dtbinh/FlyNet/Technical/Vicon_Px4_Orientation_notes.txt

Vicon New Terminator Notes:
----------------------------
Facing Flight Direction Towards True North:
-------------------------------------------
Movement	Vicon	PX4 Local
--------	-----	---------
Pith up		-x		-y
Pitch down	+x		+y
Roll Left	+z		+x
Roll Right	-z		-x
Yaw Right	+y		-z
Yaw Left	-y		+z
