dtbinh/FlyNet/Presentations/integration_overview.pptx

## FlyNet Integration Architecture

Austin Anderson

## Overview

Target Detection

Tag
Detection

Navigation
Subsystem

Planning
Subsystem

Map Information

Flight Control
Subsystem

Target/Tag Information

Multi-Platform Coordination

= USB, MAVLink

= ROS Internal

= External Radio

= TBD

## Overview

Target Detection

Tag
Detection

Flight Control
Subsystem

Pixhawk

Navigation
Subsystem

Embedded Proc.

Planning
Subsystem

Map Information

Target/Tag Information

External Platforms

Multi-Platform Coordination

= USB, MAVLink

= ROS Internal

= External Radio

= TBD

## Nav Subsystem

Attitude
- Input
- Euler or Quaternion
- 3, double (64-pt.)
- MAVLink
- Up-to 1 kHz (?)

Local NED
- Output
- 3, double (64-pt.)
- ROS Internal
- ~10 Hz (based on sensor)

Map for OA
- Output
- ???
- ROS Internal
- ~10 Hz

Target Position in Local NED
- Input
- 3, double (64-pt.)
- ROS Internal
- ~10 Hz (based on sensor)

Nav Subsystem
- Runs SLAM on embedded controller
- Needs to output local NED and updated map.

Navigation
Subsystem

## Flight Control Subsystem

Flight Control Subsystem
- Runs flight control on Pixhawk
- Executes local position controller
- Given local NED pos
- Given local NED commands
- Outputs attitude for Nav. System

Attitude
- Output
- Euler or Quaternion
- 3, double (64-pt.)
- MAVLink
- Up-to 1 kHz (?)

Command, Local NED
- Input
- 3, double (64-pt.)
- USB MAVLink
- ~10 Hz (based on sensor)

Pos Local NED
- Input
- 3, double (64-pt.)
- USB MAVLink
- ~10 Hz (based on sensor)

Flight Control
Subsystem

## Detection Subsystem

Detection Subsystem
- Runs on embedded processor to detect targets and tags
- Extract az/el to target
- Extract binary detection from tag
- Tag is still TBD

Target Detection

Tag
Detection

Target Detection
- Binary -> target visible?
- Bearing 2, double (64-pt.)
  - Az/El
- SPI video
- 10 Hz (???)

Tag Detection
- Binary -> target visible?
- Double -> Tag ID
- USB or UART most likely…
- Or just camera…
- 10 Hz (???)

## Detection Subsystem

Detection Subsystem
- Runs on embedded processor to detect targets and tags
- Extract az/el to target
- Extract binary detection from tag
- Tag is still TBD
- Candidate for merging/ separate processor

Target Detection

Tag
Detection

Target Detection
- Binary -> target visible?
- Bearing 2, double (64-pt.)
  - Az/El
- SPI video
- 10 Hz (???)

Tag Detection
- Binary -> target visible?
- Double -> Tag ID
- USB or UART most likely…
- Or just camera…
- 10 Hz (???)

## Off-board Interface

Target/Tag Information

Map Information

Multi-Platform Coordination

Off-board Interface
- WiFi link for now
- Has to run some thread on embedded processor
- Very much TBD for now….
- Likely 10 Hz interface
- Map is a lot of data to move
- Need to reduce map
- Figure out how distributed planning will work
- Consider adding more processors…
