dtbinh/FlyNet/Technical/controls/Architecture/controls_working.pptx

W

R

C(s)

F, M

G(s)

A, α

Y

V

## Slide 2

Thrust, T
Drag, F_D
Gravity, F_g

Roll Torque
Pitch Torque
Yaw Torque

F

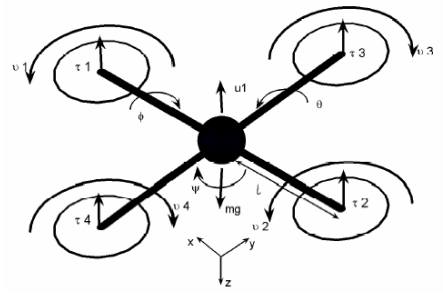
[picture p4: figure]

A_i =[xyz]_(inertial)

α_b =[φθψ]_(body)

M

Forces

τ_θ =k_t L (ω_1^2 −ω_2^2 )

τ_ψ =k_ψ L (ω_1^2 −ω_2^2 +ω_3^2 −ω_4^2 )

Moments

τ_φ =k_t L (ω_3^2 −ω_4^2 )

T=∑ T_i =k_t ω^2

F_D =−k_d x

F_g =mz

Assuming body and propeller gyroscopic moments are small

## Slide 3

C(s)

Roll ref

Pitch ref

Yaw ref

Throttle ref

Control System

Voltage1

Rotor Dynamics

ω_1

ω_2

ω_3

ω_4

f(ω)

F

M

Voltage2

Voltage3

Voltage4

## Slide 4

Rotor Dynamics

R_a

L_a

+

e=k_e θ

τ=k_t I_a

Θ/V=K/(s(τs+1))

Ω/V=K/(τs+1)

J_m θ+bθ=k_t I_a

L_a (di_a)/(dt)+R_a i_a =V_a −k_e θ

ℒ(s)

J_m Θs^2 +b Θs=k_t I_a

L_a I_a s+R_a I_a =V_a −k_e Θs

## Slide 5

Attitude
Control

V

K_I

1/s

φ_(des)

K_p

φ_(des)

K_p

K/(τs+1)

ω_m

t_φ (ω^2 )

τ_m

1/(Js)

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
θ_(des)

K_p

θ_(des)

K_p

K/(τs+1)

ω_m

τ_θ (ω^2 )

τ_m

1/(Js)

θ

1/s

θ

s

K_D

## Slide 6

Altitude
Control

1/s

K_I

z_(des)

K/(τs+1)

ω_m

T(ω^2 )

T

K_p

V

z_(estimate)

s

K_D

## Slide 7

Velocity
Control

1/s

K_I

x_b

V

K/(τs+1)

τ_θ (ω^2 )

τ_m

1/(Js)

1/s

x_b _(estimate)

K_p

ω_m

θ

θ

s

x_(estimate)

1/s

K_I

y_b

V

K/(τs+1)

τ_φ (ω^2 )

τ_m

1/(Js)

1/s

y_b _(estimate)

K_p

ω_m

φ

φ

s

y_(estimate)

## Slide 8

Position
Control

x,y_(des)

x_i ,y_i

x_b ,y_b

θ_(des)

K_p

R_(i2b)

Velocity Controller

φ_(des)

Attitude Controller

θ

x,y_(estimate)

Attitude Controller

φ
