dtbinh/FlyNet/Technical/controls/Architecture/control_diagram.pptx

Pixhawk/flight controller
Guidance
Custom

Desired velocity

ax-body, ay-body , az-body
p, q, r

ϕd θd ψd

Map Metrics

Map

pd qd rd

ϕd θd ψd

Desired trajectory

Vis. Odom.

ϕd θd ψd

Vis. Odom.

Vis. Odom.

Depth images,
Ultrasonic readings

Vis. Odom.

F, M

Zintertial-des

Desired Position

Depth images,
Ultrasonic readings
