dtbinh/FlyNet/Technical/documentation/Fall2015FinalReports/Technical Documentation/FlightControls.docx

Flight Control System:

Overview:

The purpose of the flight control system is to provide reliable indoor flight for a quad-rotor vehicle when a characterized/reliable position estimate is available, and when a set of desired locations/poses are commanded.

This system will accept a desired position in map space, given a North-West-Up coordinate system (used as per autopilot specifications), as well as a yaw command. These commands will be sent from the planning subsystem. Additionally, the SLAM algorithm described in the perception subsystem will provide position and orientation estimates to be used in the estimators used for control.

These commands and estimates are sent to an onboard Pixhawk autopilot. The autopilot uses these estimates and commands to run it’s internal control algorithms, which interface directly with the motors and ESCs. The Pixhawk uses a successive loop closure approach with position control as the outer most loop and the inner loops consisting of velocity, attitude, and attitude rate controllers.

Modeling:

Summary of Work

A simulation was developed to model the behavior of a quadcopter given certain physical properties and position commands. The simulation consists of a position controller, an attitude controller, and quadcopter dynamic model. The FlyNet simulation was built on the framework developed by D. Hartman, et al. (2014) and modified to fit the needs of this particular project and quadcopter. An overview of the model is shown in Figure 1.

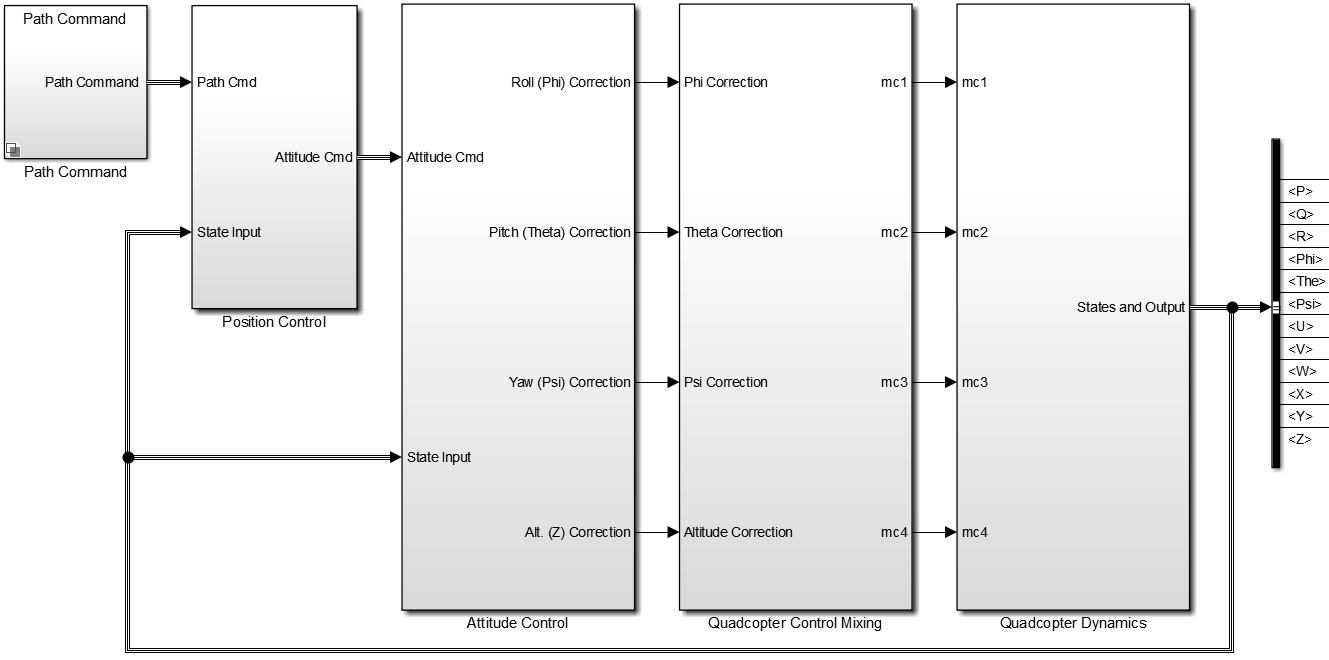
[picture p47: figure]

Figure 1. FlyNet quadcopter Simulink model

The simulation requires three sets of inputs:

- Initial conditions for all of the states (P, Q, R, ϕ , θ , ψ , U, V, W, X, Y, Z) and motor angluar rates, ω_(motor)
- Physical parameters of quadcopter (for a full list see Table 2)
- Path commands (X, Y, Z, and ψ )

These inputs are used by the model to simulate the quadcopter dynamics given a list of waypoints.

Position Controller

The position controller uses PD to control the desired velocity in the body horizontal plane ( X_b and Y_b ). The desired velocity is derived from the error between desired and current inertial positions. Figure 2 shows Simulink diagram of the position controller.

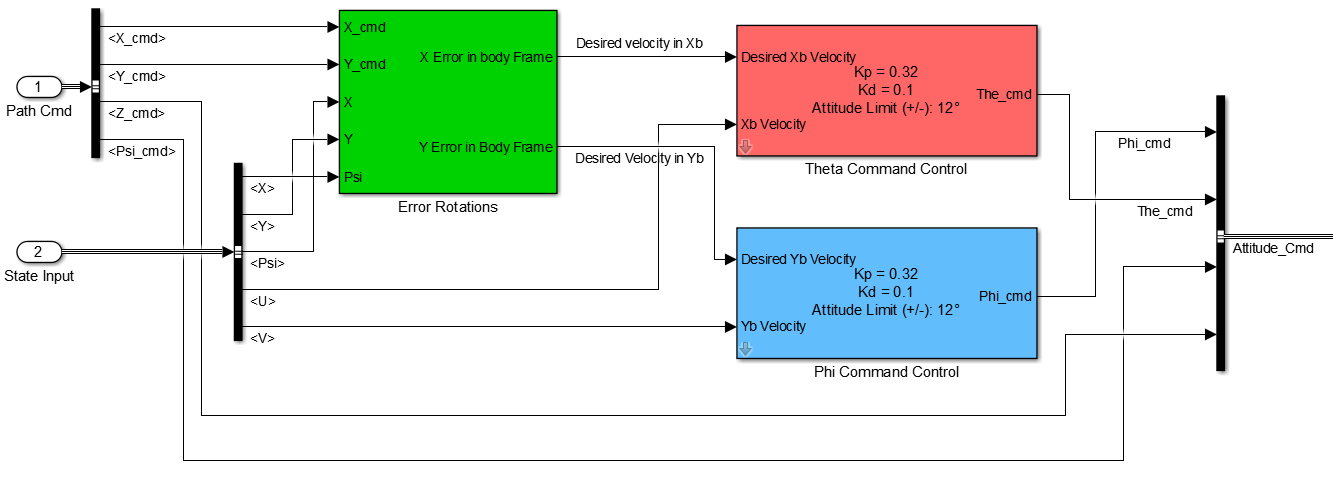
[picture p48: figure]

Figure 2. FlyNet quadcopter simulation position controller

The position controller outputs a signal bus containing roll and pitch attitude commands in addition to the altitude and yaw commands provided by the path command. This signal bus is then passed to the attitude controller.

Attitude Controller

The attitude controller applies PID control to the roll, pitch, and yaw in addition to the body Z coordinate in order to maintain the attitude required to execute the path command provided to the model. The attitude controller Simulink model is shown in Figure 3.

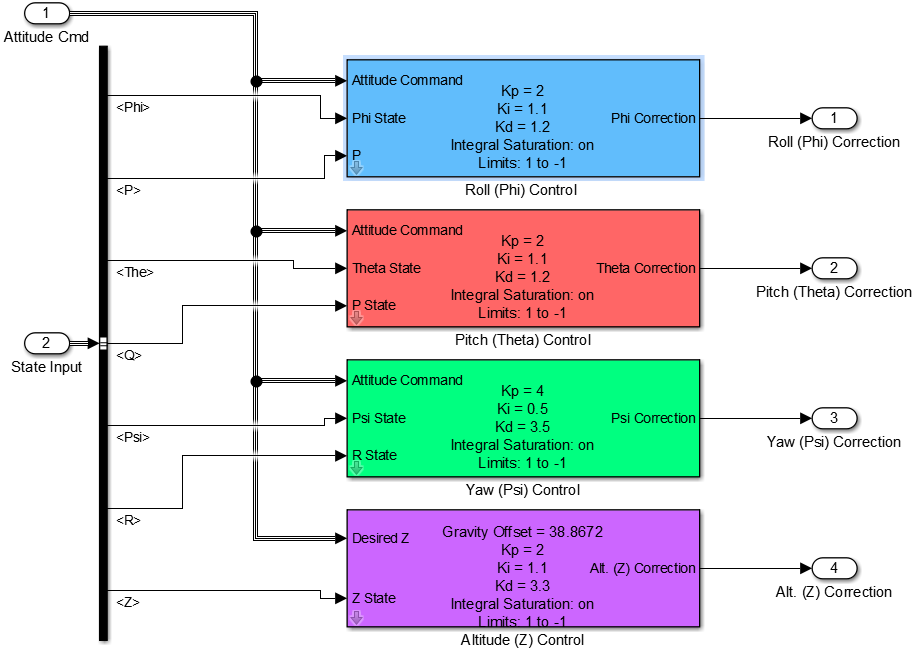
[picture p49: figure]

Figure 3. FlyNet quadcopter simulation attitude controller

The attitude controller uses body angular positions and rates (P, Q, R) in addition to the roll, pitch, and yaw commands provided by the position controller to compute the attitude corrections necessary to maintain a given path. The attitude corrections are sent to the motor mixer in order to translate them in to motor RPM commands. The motor mixer is shown in Figure 4.

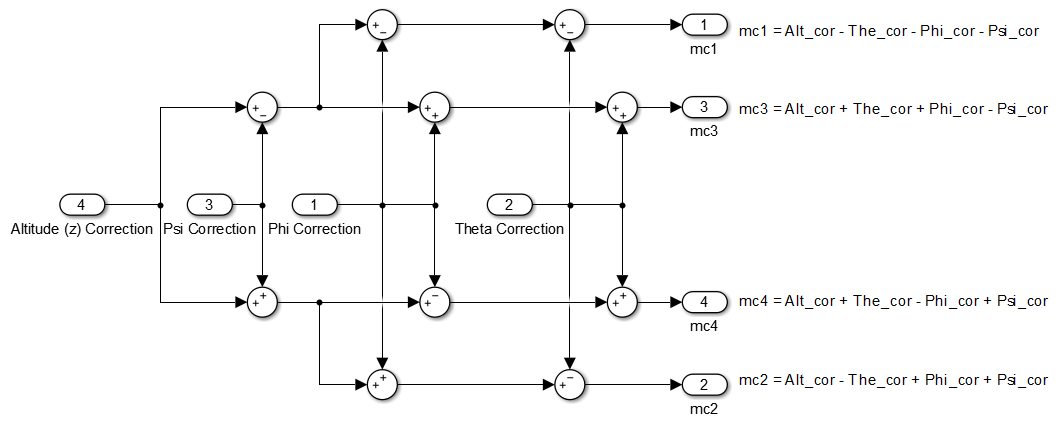
[picture p50: figure]

Figure 4. FlyNet quadcopter simulation motor mixer

The variable ‘mc#’ refers to the individual motor RPM commands that are required to achieve the attitude corrections. At this time, motor dynamics are considered and modeled in this simulation according to the transfer function shown in Equation (1):

| Ω/V=(k_t)/(τ_m s+1) | (1)

Here, Ω is the motor angular velocity, V is the PWM signal provided to the motor, k_t is the motor torque constant, and τ_m is the motor time constant. Once the motor commands are known, the dynamic model can simulate the response of the quadcopter to external force and moments.

Quadcopter Dynamics

Quadcopter dynamics are well understood and documented in various papers. Detailed information on the physics behind the quadcopter dynamic model used in this simulation can be found in the work of D. Hartman, et al. (2014). It is important, however, to note that the current dynamics model ignores blade flapping and frame aerodynamic drag. Because the quadcopter velocities are assumed to be small, these effects are negligible.

Simulation Results

The simulation was first tested using step input commands for X, Y, and Z to simulate the behavior of quadcopter in response to 1 meter commands in each direction. Figure 5 shows the response of the quadcopter in the X and Y directions (the test yielded the same result for both directions).

Figure 5. X and Y response of model to step command

In the X-Y direction, the quadcopter shows a stable response with an overshoot of 14% with a 5% settling time of 3.7 seconds. The altitude (Z direction) step response exhibits slower performance but is still stable. Figure 6 shows the model response to an altitude step command.

Figure 6. Z response of model to step command

In the Z direction, the quadcopter shows a stable response with an overshoot of 50% with a 5% settling time of 22.4 seconds. The altitude control is less critical than the horizontal control for the purposes of the FlyNet mission because minimal altitude control is expected. Horizontal control, however, is pivotal to maneuvering obstacle-filled spaces.

Yaw angle is another command that was tested because it will be necessary to perform yaw maneuvers in order to scan the search area during the mission. Figure 7 shows the model response to a yaw step command.

Figure 7. Yaw response of model to step command

The yaw angle control is stable, showing an overshoot of 25% with a 5% settling time of 6.6 seconds. These results show the controller is stable and performs well in horizontal motion but should be improved in the other direction. Improvement can be achieved by further tuning PID gains or adding feedforward control.

In order to assess the quadcopter model’s ability to follow a path, a series of position commands were provided to the model. The path shown in Table 1 was provided to the model.

Table 1. Simulink model commanded path

| 0 min | 6 min | 7 min | 7.5 min | 8 min | 8.5 min | 9 min | 9.5 min | 10 min
X [in] | 126 | 165 | 84 | 50 | 46 | 48 | 130 | 280 | 270
Y [in] | 30 | 179 | 329 | 362 | 497 | 584 | 548 | 467 | 480
Z [in] | 36 | 36 | 36 | 36 | 36 | 36 | 36 | 36 | 36

The XYZ commands were given at the time intervals shown. The first command was given 6 minutes to execute as it was the initial change in altitude from ground level to 36 inches (3 feet). After the first command, constant altitude was maintained. Figure 8 and Figure 9 shows the simulated results of the quadcopter path following.

Figure 8. Top-down view of simulated quadcopter path-following

Figure 9. Isometric view of simulated quadcopter path-following

The results show that after an initial overshoot in altitude, the vehicle tends to adhere to the commanded path. There are slight deviations when heading is changed but that is expected based on the simulated controller step responses. The simulation shows a Root-Mean-Square (RMS) error of 8.50 and the requirement is RMS must be less than 20 for path following.

Table 2. Quadcopter simulation physical parameters.

Variable | Parameter | Units
g | Acceleration due to gravity | m/(s^2)
d | Distance between motor and the axis of rotation | m
mass | Total mass | kg
ct | Lumped parameter thrust coefficient | (Ns^2)/(rad^2)
cq | Lumped parameter torque coefficient | (Nms^2)/(rad^2)
Jx | Moment of inertia about X | kg∙m^2
Jy | Moment of inertia about Y | kg∙m^2
Jz | Moment of inertia about Z | kg∙m^2
Jm | Moment of inertia of motors | kg∙m^2
Jb | Inertia tensor | kg∙m^2
Jbinv | Inverted inertia tensor | kg∙m^2
dctcq | Matrix of ct and cq for moment calculation | (Ns^2)/(rad^2), (Nms^2)/(rad^2)
motor_m | Mass of one motor | kg
motor_dm | Distance from motor to quadcopter center of mass | m
motor_h | Height of motor | m
motor_r | Radius of motor | m
ESC_m | Mass of one ESC | kg
ESC_a | Width of ESC | m
ESC_b | Length of ESC | m
ESC_ds | Distance from ESC to center of mass | m
HUB_m | Mass of hub | kg
HUB_r | Radius of hub | m
HUB_H | Height of hub | m
arms_m | Mass of one arm | kg
arms_r | Radius of arm | m
arms_L | Length of arm | m
arms_da | Distance from center of mass to arm | m
minThr | Minimum throttle | %
T | Time constant | s
cr | Throttle % to RPM conversion coefficient | (RPM)/(%Throttle)
b | Y-intercept for linear regression model of cr | RPM

Hardware:

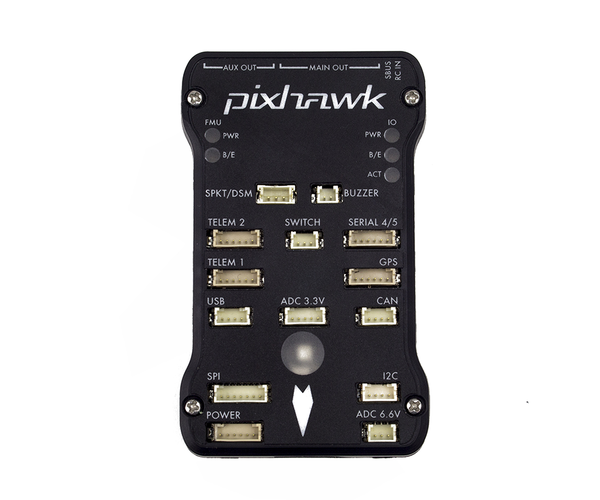
[picture p51: figure]

A 3DR Pixhawk autopilot is being used as the low-level flight controller and state estimator.

The Pixhawk internally uses accelerometers built into the unit to estimate its orientation. It also has a built in barometer for altitude state estimation; however, this is not being used since the barometer estimates are unreliable even over a short time frame. The magnetometer onboard the Pixhawk can also provide yaw estimates.

The PX4 firmware is being used in our system. This firmware is convenient for this application because it has built in support for external pose estimates. This allows the use of VICON for pose estimates during the controller performance evaluations, initial flight-testing for waypoint following, and for testing of the planning subsystem. Additionally, this topic will be used in the final flight configuration, in which a SLAM solution provides the pose estimates.

Figure 10: Pixhawk Autopilot

The firmware currently being used on the Pixhawk is PX4 commit hash: 2a1b1fe11db3406ff9e6027f858c7a994adee15d

Interfaces:

The communication between the planning subsystem, perception subsystem, and the flight control subsystem is handled using the Robot Operating System (ROS). This library was used as it abstracts low level interfaces, manages software dependencies, allows for the integration of heterogeneous code, and has existing code relevant to all of the subsystems. The MAVROS library allows direct communication with the PX4 firmware running on the Pixhawk using the MAVLink protocol. For near term testing, a motion capture system was used to feed position and orientation data into the autopilot. This will be replaced by the SLAM solution in the future, but development of the motion capture system also provides ground truth data with which the team can verify the performance of its algorithms. Currently a trajectory generation node is used to feed set point commands to the autopilot. This node will be replaced by the planning subsystem as that matures. The current architecture and interconnectivity of the ROS flight control software is shown in the following graph:

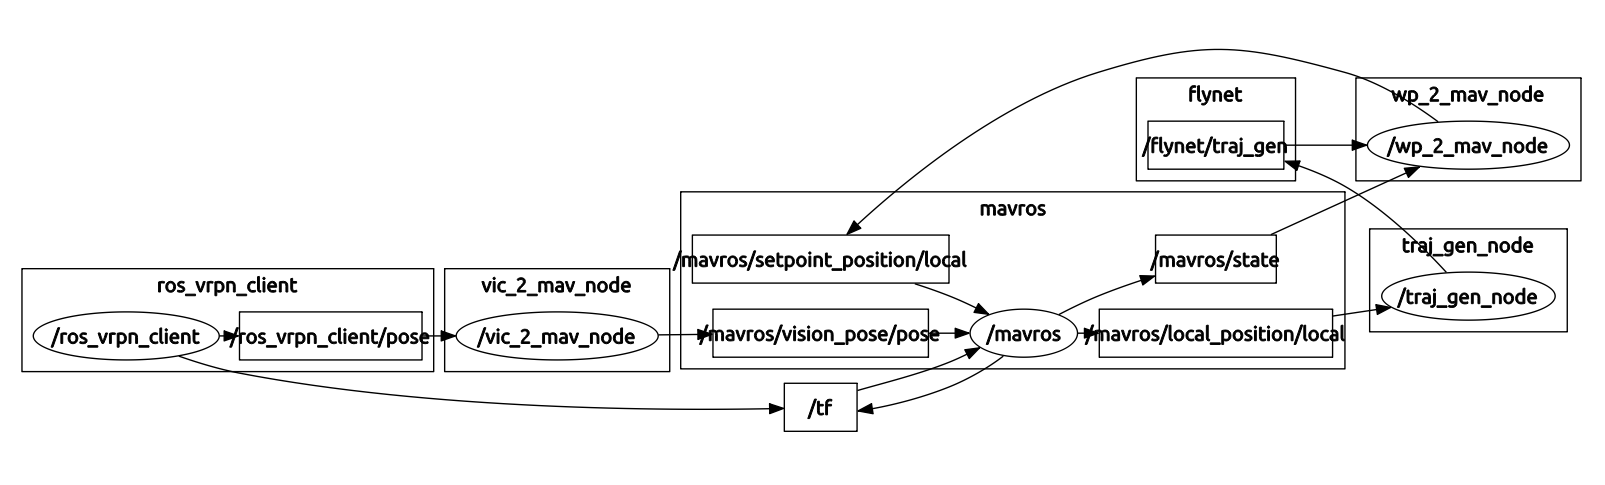
[picture p52: figure]

ROS NODES:

Figure 11: Flight Controls ROS Architecture

The flight control software written in ROS was architected to maximize modularity to support different flight modes as different subsystems evolve. The core nodes are the MAVROS node and wp_2_mav node. These handle the lowest level operations of the vehicle. The surrounding nodes can be switched out and still maintain basic functionality. For example, while the ROS_VRPN_CLIENT node is used now to provide position estimates to the vehicle, it will eventually be replaced with the SLAM algorithm. Similarly, the traj_gen node will eventually be replaced by the planning subsystem. Translator nodes will still likely be required to manage coordinate frame differences, but the existing translators should be adaptable to meet future requirements.

MAVROS Node:

This is the central node of the flight control software. It interfaces directly with the autopilot. It feeds in position and heading set points as well as vehicle position and orientation estimates from an external source. It publishes the local position and orientation estimate of the vehicle state calculated by the autopilot. It also publishes current autopilot state information that is used for management of flight modes. In addition to the topics MAVROS publishes and can subscribe to, it also provides a number of useful services. Currently MAVROS services are used to accomplish the following tasks:

1. Arm the quadcopter for autonomous flight
2. Force the autopilot into OFFBOARD flight mode to support autonomous commands
3. Set the GUIDED flag to true to enable autonomous operation
4. Set the home location to 0,0,0 in the local frame.
5. Set the takeoff flag

The MAVROS node is also used to set internal parameters of the autopilot. The following table captures important parameters for autonomous flight and their settings:

Name | Description | Value
ATT_MAG_DECL | Magnetic declination at Boulder, CO in deg. | 8.60
CBRK_NO_VISION | Flag indicating if vision data is available | 0 (use vision)
MIS_YAWMODE | Mode enumeration for yaw control | 0 (use set point)
ATT_EXT_HDG_M | External heading measurement mode | 1 (use vision)
INAV_W_Z_BARO | Weight used to incorporate barometer in alt. est. | 0.2 (lowered from default of 0.5)
Control Gains | Gains for internal set point controllers (attitude rate, attitude, velocity, position), still in the process of tuning for performance | Various/TBD

For further lists of parameters, descriptions, and default values, visit:
https://pixhawk.org/firmware/parameters

ROS_VRPN_CLIENT NODE:

This node interfaces to motion capture system using a VRPN connection. The node is passed the IP address of the computer running the motion capture system and the name of the object being tracked. It reports the position and orientation information of the tracked object at 100 Hz.

Vic_2_Mav Node:

This node subscribes to the position and orientation topic published by the ROS_VRPN_CLIENT node and translates the coordinate frame to one compatible with MAVROS. The translated position and orientation estimates are then published directly to the vision position and orientation topic of MAVROS. The autopilot’s attitude and local position estimators then fuse this information internally. The rate of this node is driven by the rate of the ROS_VRPN_CLIENT node topic.

Traj_Gen Node:

This node generates a series of set points for the vehicle to follow. The published set points follow a custom message format that includes local x,y,z (North, West, Up) coordinates and heading. This node currently supports the use of manually input arrays of set points. The first set point is always point 1.5 m above the origin with no heading command. This was done to prevent the vehicle from trying to take off and re-orient its heading at the same time. Set points are advanced when the vehicle has closed to within a set distance threshold of the current set point. This is accomplished by independently checking distance to the altitude set point, z, and the absolute distance to the planar x,y set points. To further smooth motion from set point to set point, the vehicle must remain in the specified threshold for a number of software loops that approximate a set amount of time before it is advanced. The node subscribes to the local position estimate generated by the autopilot for this threshold check. The rate of this node is driven by that subscribed estimate.

WP_2_MAV Node:

This node subscribes to the custom set point message generated by the Traj_Gen node, formats it to be compatible with MAVROS, and publishes set point commands to the autopilot at a constant rate of 50 Hz. Set points are updated asynchronously as new local position information becomes available, but this node synchronizes that to publish at a constant rate to the autopilot. This node also handles the interaction with the MAVROS services to arm the quardrotor and set the proper flags and states to force it into an autonomous mode. It monitors the state of the autopilot reported by MAVROS to safely set autonomous mode when the pilot allows it to by flipping a switch on their control. When the pilot specifies manual control, this node stops trying to force the vehicle to autonomous operation and allows the pilot to fly the vehicle.

Coordinate Systems:

The following list of coordinate systems is relevant to the control system:

1. VICON: (West-Down-South) defined by user to align with to the compass rose.
2. Pixhawk: (North-East-Down) the coordinate system used by the Pixhawk internally.
3. MAVROS: (North-West-Up) the coordinate system that is expected when passing position commands and estimates to MAVROS topics.
4. SLAM: (TBD)

Results:

After the coordinate system transformations were discovered and implemented in ROS nodes used to convert between coordinate systems, a successful flight test was performed that tested the waypoint tracking capabilities of the system.

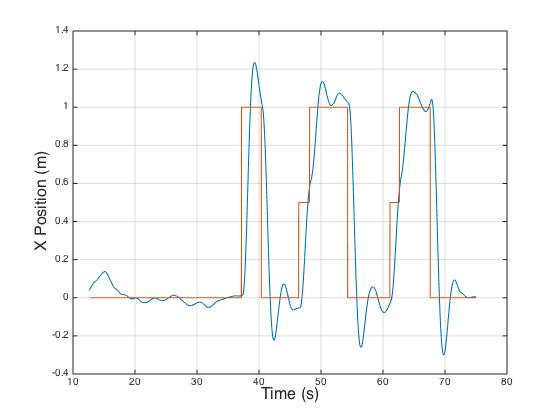
[picture p53: figure]

Figure 12: X Position Waypoint Tracking (Pose Estimate: Blue, Setpoint: Green)

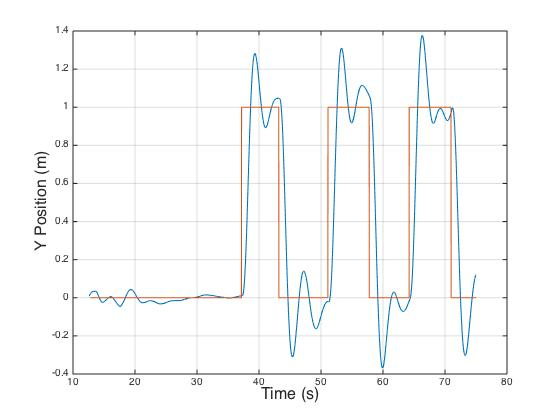
[picture p54: figure]

Figure 13: Y Position Waypoint Tracking (Pose Estimate: Blue, Setpoint: Green)

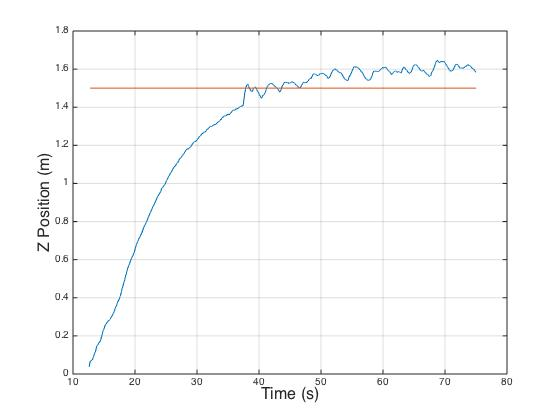
[picture p55: figure]

Figure 14: Z Position Waypoint Tracking (Pose Estimate: Blue, Setpoint: Green)

These results demonstrate the successful development of a test bed for future work on the integration of planning and perception algorithms.

Future Work:

The future work for this subsystem includes the tuning of control gains and the integration of the planning and perception subsystems. New software nodes will also be required to handle obstacle avoidance, set flags for re-planning, and using altitude diversity to bypass occlusions. Generally, testing of this subsystem has required multiple team members, long hours, and has resulted in crashes requiring mechanical reconstruction. All of these issues can be mitigated with a larger focus on high fidelity modeling. While software-in-the-loop (SITL) simulations were explored briefly this semester, they were abandoned. In the coming semester, SITL will be further explored and developed to prototype algorithms and flight control software before deployment on the flight hardware. This should reduce time required to debug new software on the hardware, and reduce the risk of unexpected behavior.
