dtbinh/FlyNet/Administration/quadchart_drew_austin_11_18.pptx

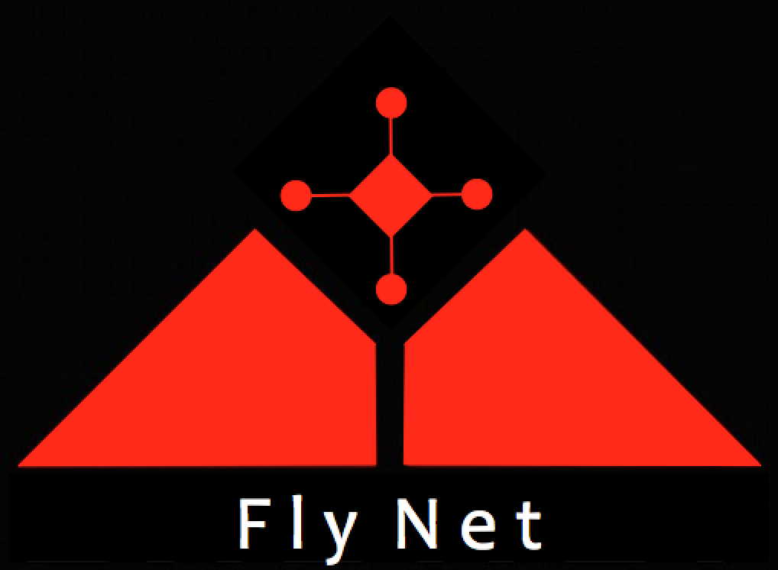
[picture p87: figure]

FlyNet: Autonomous Quadcopter Search and Rescue

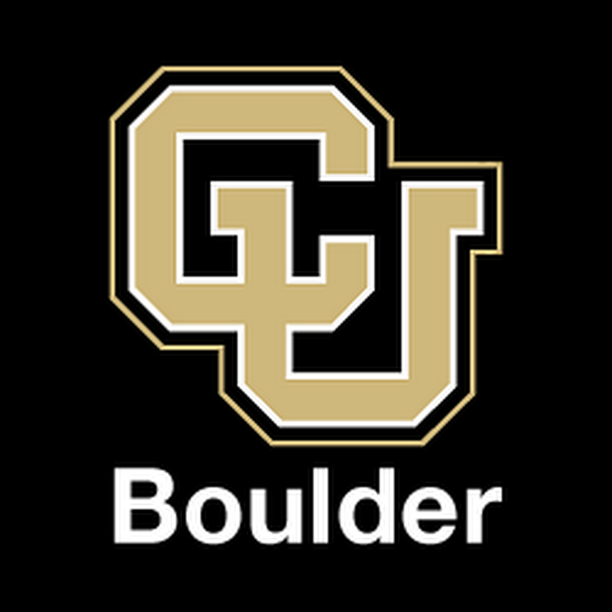
[picture p88: figure]

Progress
- Station-keeping at origin reliably
- Non-origin setpoints are underway
- Have been able to feed vision pose to pixhawk estimators
- Yaw commands appear to being accepted

Big Picture Task
- Have the quadrotor fly reliably indoors
- Follow a given set of waypoints
- Station-keep reliably

Proposed Solution / Justification
- Temporarily use VICON position data
- VICON pose is fed into the pixhawk and internally fused with barometer
- Send series of different position and attitude setpoints, verify performance with VICON
- Use RTAB position in the long run

Path Forward
- Flight test yaw control
- Flight test non origin waypoints
- Gain tuning is in progress in tandem with pixhawk simulation from Ed
- Once individual waypoint tracking is reliable, send list of waypoints
