dtbinh/FlyNet/Presentations/frew_approved_block_diagrams.pptx

Main Node

Converter Node

Legend

Hardware

ROS Topic

ROS VRPN

Vicon Pose
(xvic, yvic, zvic, ψset)

Coord. Sys. Transform

Vicon Pose in MAVROS C.S.
(xmap, ymap, zmap)

Quadrotor

Motor PWM

Dynamics

Pixhawk

Visual Odometry
(vx, vy, vz)

Depth and Grayscale Images

Obstacle Distance
(fused range x 5)

Ultrasound
(range x 5)

IMU
(ax-body,ay-body,az-body,
p, q, r)

Fused Pose Data

Position Setpoint

MAVROS

Pixhawk Pose Estimate
(x, y, z, ϕ, θ, ψ)

Pose → Odom.

Fused Odometry
(vx, vy, vz)

RTAB Map

SLAM Pose
(xmap, ymap, zmap)

Guidance Node

Guidance

OctoMap

OctoMap → 2D Map

2D Occupancy Grid

Planning Node

Setpoint Position/Attitude
(xset, yset, zset
ϕset, θset, ψset)

## Slide 2

FLiR

WiFi Dongle

ODROID

Battery (14.8V)

14.8 V , .81 A

5 V , 4 A

5V
Regulator

5 V , 0.3 A

Guidance

Pixhawk

Power Distribution

14.8 V , 2-20 A

ESC

Radio Receiver

Motors

14.8 V

## Slide 3

FLiR

I2C (Control)

Expansion Board

SPI (Video)

WiFi Dongle

USB 3.0 (#0)

ODROID

USB 2.0 (#1)

Pixhawk

USB 2.0 (#2)

Guidance

PWM

ESC

Radio Receiver

## Slide 4

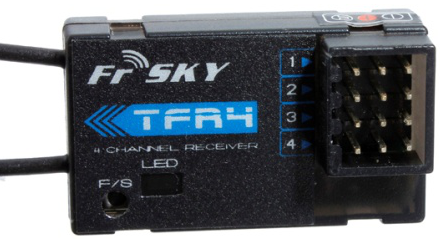
[picture p89: figure]

FrSKY TFR4 Radio Receiver

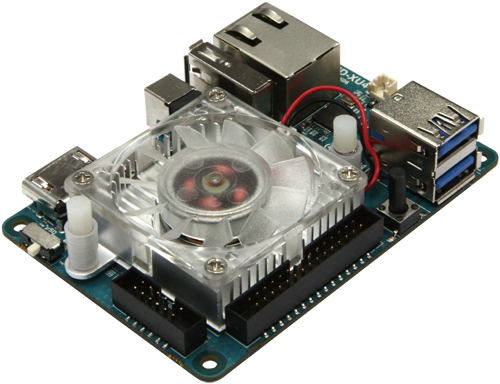
[picture p90: figure]

ODROID XU4

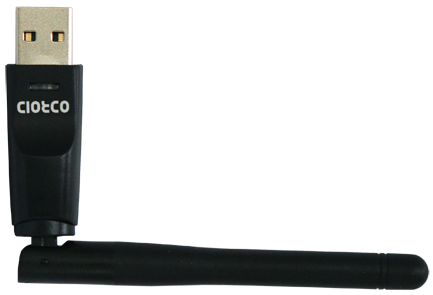
[picture p91: figure]

WiFi Adapter

USB Hub

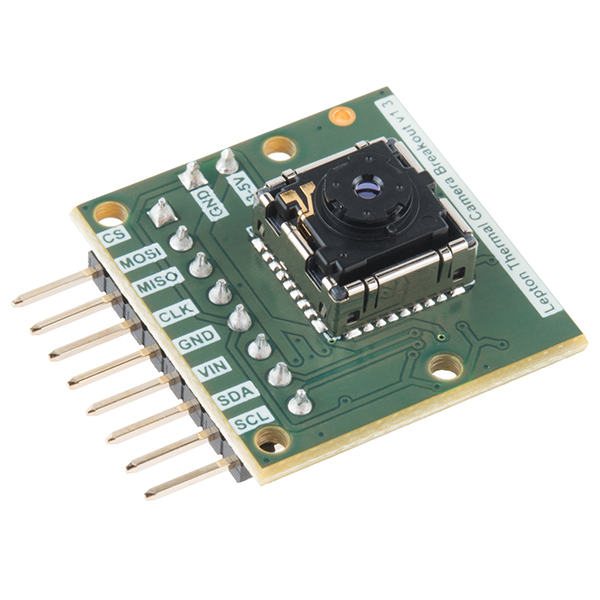
[picture p92: figure]

FLiR Sensor

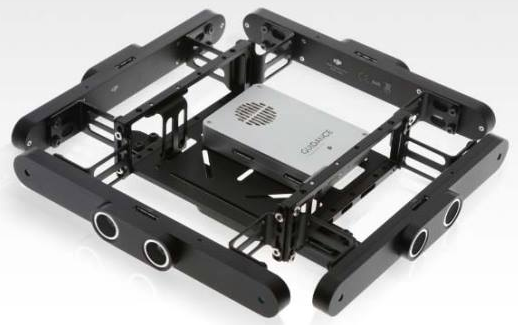
[picture p93: figure]

DJI Guidance

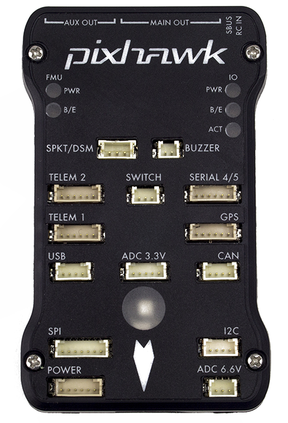
[picture p94: figure]

Pixhawk with PX4 Firmware


Aliencopter Bee Quadrotor

ESC/ Motor

Power Distribution Board

Battery

Power Module

BEC

## Slide 5

WiFi Adapter

Comms
Power

Aliencopter Bee Quadrotor

FrSKY TFR4 Radio Receiver

UART
(RC inputs)

Pixhawk with PX4 Firmware

USB 3.0 (#0)

ODROID XU4

FLiR Sensor

DJI Guidance

USB 2.0 (#1)
(Position
Commands)

SPI (video)
I2C (control)

PWM Signals

USB 2.0 (#2)
(odometry & BW images)

ESC/ Motor

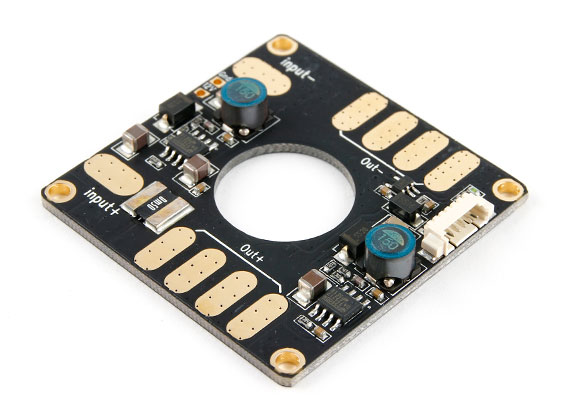
[picture p95: figure]

Battery (14.8V)

## Final Architecture

Ground Station

- ROS master
- Communicates with onboard flight computer
- Data visualization with RVIZ

ROS publisher 10Hz
(HW Limited)

USB

DJI Guidance

- Provides depth map, grayscale images, and visual odometry for RTAB Map

SSH via WiFi

FLiR Sensor

- Provides IR images for human identification

Odroid XU4

- Ubuntu 14.04
- Runs RTAB Map
- Runs planning algorithms
- Runs target ID algorithms

I2C & SPI

Pixhawk Autopilot

- Running PX4 Firmware
- Accept position/attitude setpoints from planning algorithm
- Runs onboard position controllers
- Provides attitude information to target ID algorithms

USB
