dtbinh/FlyNet/Presentations/dvz_example.pptx

## Final Architecture

Ground Station

- ROS master
- Communicates with onboard flight computer
- Data visualization with RVIZ
- Runs laser scanmatcher

ROS publisher 10Hz
(HW Limited)

Hokuyo Laser scanner

- Measurements used by AMCL for position and scanmatcher for velocity

Pixhawk Autopilot

- Running Arducopter Firmware
- Providing accelerometer measurements and Euler angles to KF
- Providing attitude control (stabilize mode)

3DR X8, X8+

- Octo-Quad configuration
- ~15 min flight time with 10000mA 4S battery

ROS

Odroid U3

- Ubuntu 14.04
- Runs Kalman Filter
- Runs AMCL
- Runs Flight Controllers

ROS publisher 40Hz (HW Limited)

PyMavlink
20Hz
(SW Limited)

SSH via WiFi

Motor ESCs

PX4Flow

- Measures Altitude

## ROS Architecture

PixHawk

PWM Conv

PX4 Flow

NAV

Path Planner

Scan Matcher

Hokuyo

Localization

Map

Key

Hardware Node

Software Node

Topic

Pre-loaded Info

Notes: Quinn
Update PixHawk outputs
Break localization into Kalman Filter and Particle Filter
Change odom to be rates

## Hardware Configuration

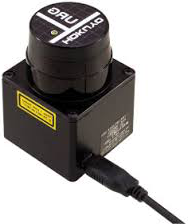
[picture p96: figure]

Hokuyo URG-04LX-UG01 Laser Scanner

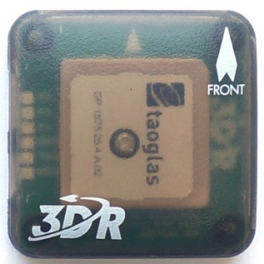
[picture p97: figure]

ublox LEA-6H GPS+MAG

Pixhawk with APM Arducopter Firmware

FrSKY TFR4 Radio Receiver

Sony Camera

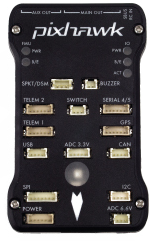
[picture p98: figure]

Overview

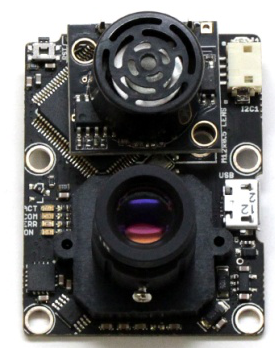
[picture p99: figure]

PX4Flow

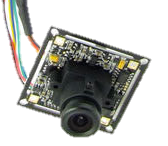
[picture p100: figure]

ESC/ Motor

USB Hub

O-Droid U3

Power Distribution Board

Battery

Power Module

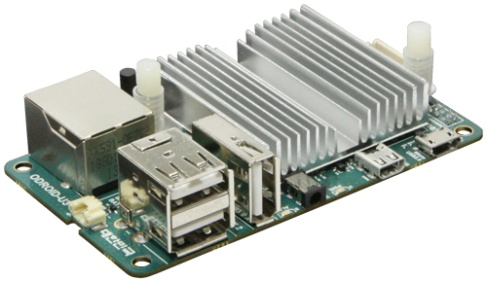
[picture p101: figure]

BEC

To USB Hub

Intro

Design

Wrap Up
