dtbinh/FlyNet/Presentations/GP_6_min.pptx

## FlyNet Overview

Austin Anderson
Steve McGuire

## Project Requirements

## Project Requirements

Disaster!

## Project Requirements

Blocked Door

Goal:
Find the Survivor!

Survivor

Dark
Room

Drones

Debris

Responder

Inaccessible Room

Operator

## Project Requirements

Blocked Door

Goal:
Find the Survivor!

Requirements

- Operate in GPS denied environment
- Operate in low/no light
- Identify and track survivors
- Identify and track responders
- Navigate 3D environment
- Plan with prior map
- Update plan based on findings
- Update prior map
- Explore the space in one flight
- Work in a team to explore
- Include ground and air vehicles
- Carry/deploy aide package
- Communicate findings to operator

Survivor

Dark
Room

Drones

Debris

Responder

Inaccessible Room

Operator

## Project Requirements

Blocked Door

Goal:
Find the Survivor!

Requirements

- Operate in GPS denied environment
- Operate in low/no light
- Identify ~~and track~~ survivor~~s~~
- Identify ~~and track~~ responder~~s~~
- Navigate 3D environment
- Plan with prior map
- Update plan based on findings
- Update prior map
- Explore the space in one flight
- ~~Work in a team to explore~~
- ~~Include ground and air vehicles~~
- ~~Carry/deploy aide package~~
- Communicate findings to operator

Survivor

Dark
Room

Drone

Debris

Responder

Inaccessible Room

Operator

## SLAM Background

- SLAM = Simultaneous Localization and Mapping
- Family of algorithms used for robotic exploration
- Localizes a robot using sensor odometry and map landmarks
- Updates map landmarks as it goes
- Uses estimation filters

Plywood Structures

Floor

Wall

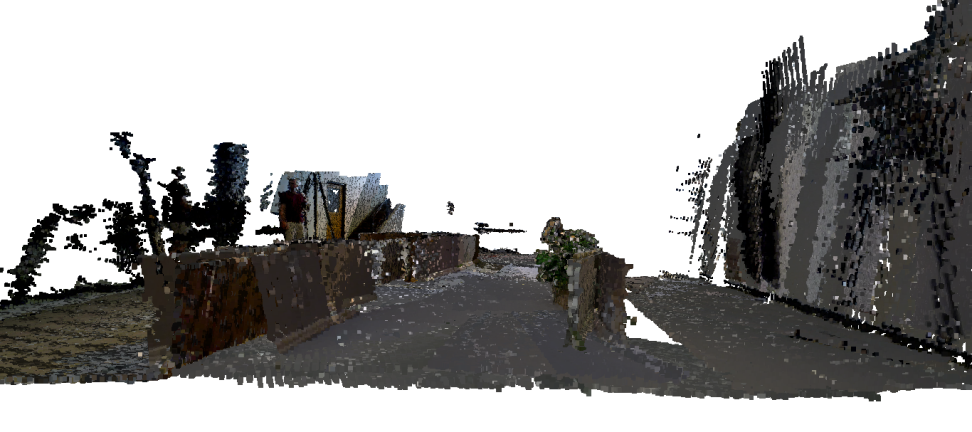
[picture p102: figure]

Occupancy map of Fleming Flight Space
Generated with RGBD sensor

## Common Platform Components


Quadcopter Frame*

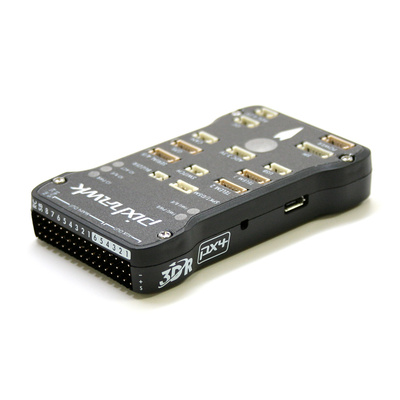
[picture p103: figure]

Pixhawk Autopilot

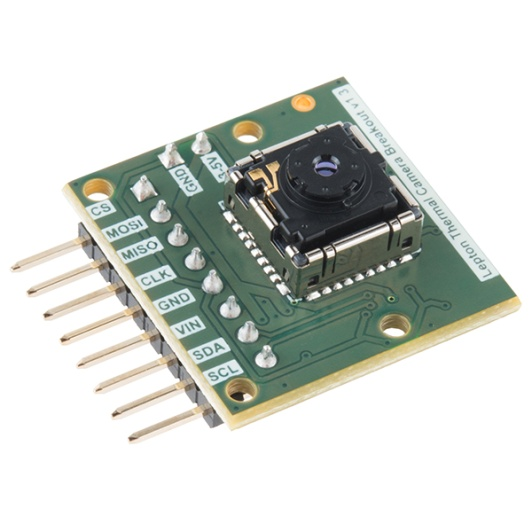
[picture p104: figure]
FLiR Dev Kit

FLiR Sensor

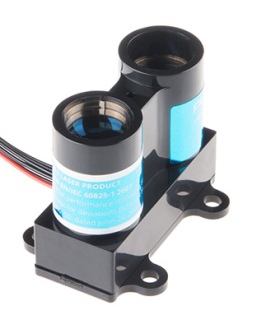
[picture p105: figure]
LIDAR-Lite v2
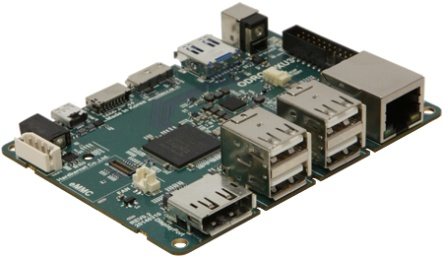
[picture p106: figure]

Embedded Processor*

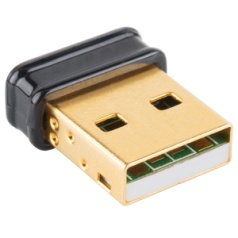
[picture p107: figure]
Edimax WiFi Adapter (EW-7811UN)

Laser Altimeter*

WiFi Radio Link

* Indicates design options being evaluated

Laser Altimeter image from: sparkfun.com

Quadrotor frame image from: hobbyking.com

Embedded Proc. image from: hardkernel.com

WiFi Radio Link image from: sparkfun.com

Pixhawk image from: pixhawk.org

FLiR Sensor image from: sparkfun.com

## SLAM Sensors

- LiDAR and monocular camera
- LiDAR provides 2-D scans
- Camera supplements scans
- LiDAR is robust to lighting conditions
- Platform can fly fast
- Relatively light processing requirement
- LiDAR is heavy/expensive

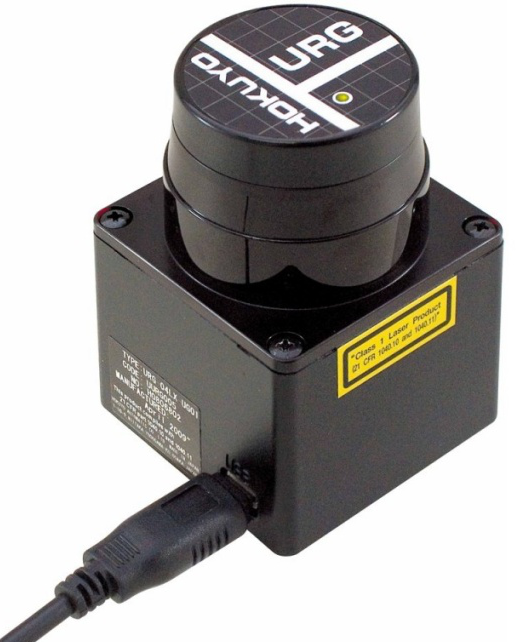
[picture p108: figure]
Hokuyo URG-04LX-UG01 Scanning Laser Rangefinder
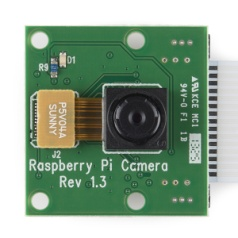
[picture p109: figure]
Raspberry Pi Camera Module

Hokuyo Lidar image from: robotshop.com

Monocular camera image from: sparkfun.com

## SLAM Sensors

- RGBD Camera
  - Red, green, blue, depth
- Depth map constructed from structured light projection
- Depth robust to lighting conditions
- Heavy
- Medium computational complexity
- Suffers from image blurring

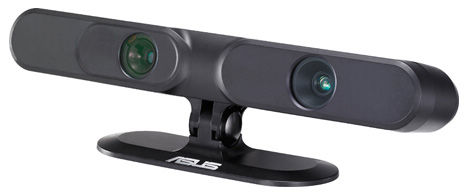
[picture p110: figure]
Product Image

ASUS Xtion Pro RGBD Camera image from: asus.com

## SLAM Sensors

- DJI Guidance
  - Stereo vision with ultrasonic ranging
  - Five simultaneous modules
  - IMU fused
- FPGA accelerated to reduce computation costs
- Provides visual odometery and collision avoidance out of the box
- Sensitive to lighting conditions
- Expensive and heavy

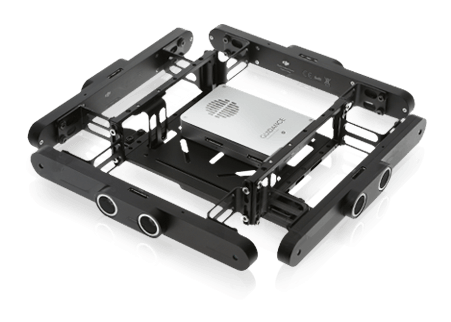
[picture p111: figure]

DJI Guidance sensor image from: developer.dji.com

## Technical Challenges

- Robust indoor flight
- GPS denied navigation
- Embedded processing of SLAM algorithms
- Robust planning for efficient search
- Planning with known prior map
- Planning for obstacle avoidance in 3-D
- Multi-platform search
- Multi-platform information fusion
- Robust target identification
- Target discrimination
- SLAM with moving targets

## Technical Challenges

- Robust indoor flight
- GPS denied navigation
- Embedded processing of SLAM algorithms
- Robust planning for efficient search
- Planning with known prior map
- Planning for obstacle avoidance in 3-D
- Multi-platform search
- Multi-platform information fusion
- Robust target identification
- Target discrimination
- SLAM with moving targets

## Questions?

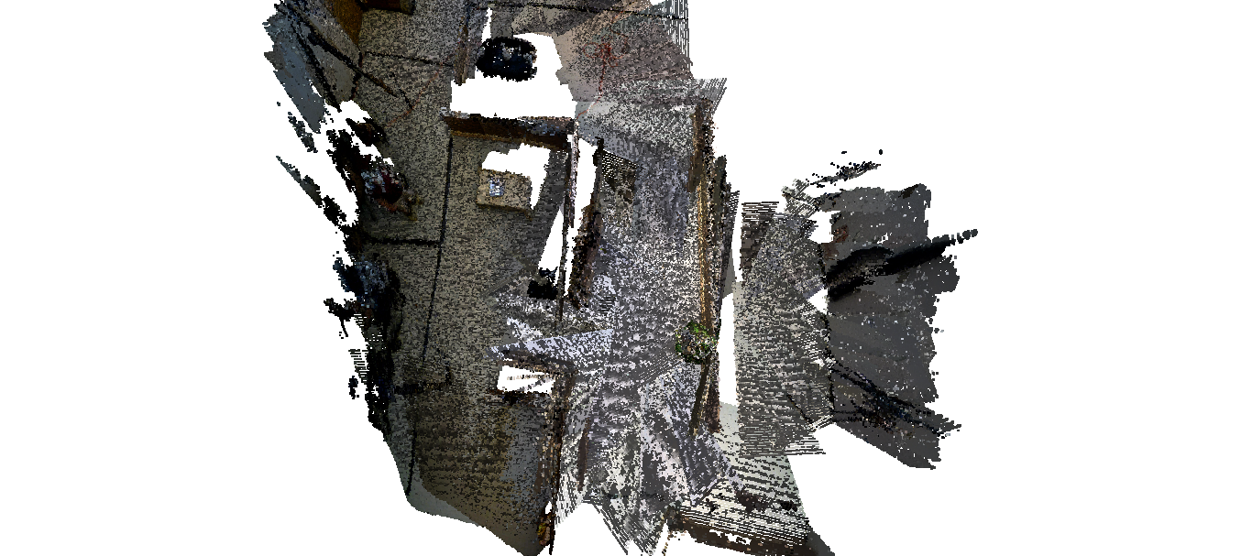
[picture p112: figure]

## Backups

## FlyNet Overview or: How I Learned to Stop Worrying and Love the Drones

Austin Anderson
Steve McGuire
