dtbinh/FlyNet/Presentations/Mid Semester Review/msr_presentation_10_21.pptx

AlienBee Power and Mass Budgets

Item | QTY | Mass [g] | Curr [mA] | [mW]
Turnigy Nano-Tech LiPo Battery | 1 | 482.7 | -- | --
Odroid XU4 | 1 | 64.2 | 800 | 4000
3DR Radio | 1 | 26.2 | 100 | 330
Pixhawk | 1 | 40.3 | 175 | 1500
FLIR Lepton LWIR Camera | 1 | 0.55 | 5 | 150
Customer Payload (1lb) | 1 | 453.59 | -- | --
AlienBee Quad (Motor, Structure) | 1 | 43 | -- | --
DJI 9443 Propellor (E300) | 4 | 19 | -- | --
Guidance | 1 | 291 | 540 | 12000
ASUS Xtion Pro Live – RGBD camera | 1 | 115 | 500 | 2500
LIDAR-Lite v2 | 1 | 28.1 | 100 | 550
Windows Lifecam Studio Camera | 1 | 128 | 500 | 2500
TOTAL - Guidance | | 2380 | 1670 | 17980
TOTAL - RGBD | | 2360 | 2230 | 11530

## Slide 2

AlienBee Endurance vs. Payload

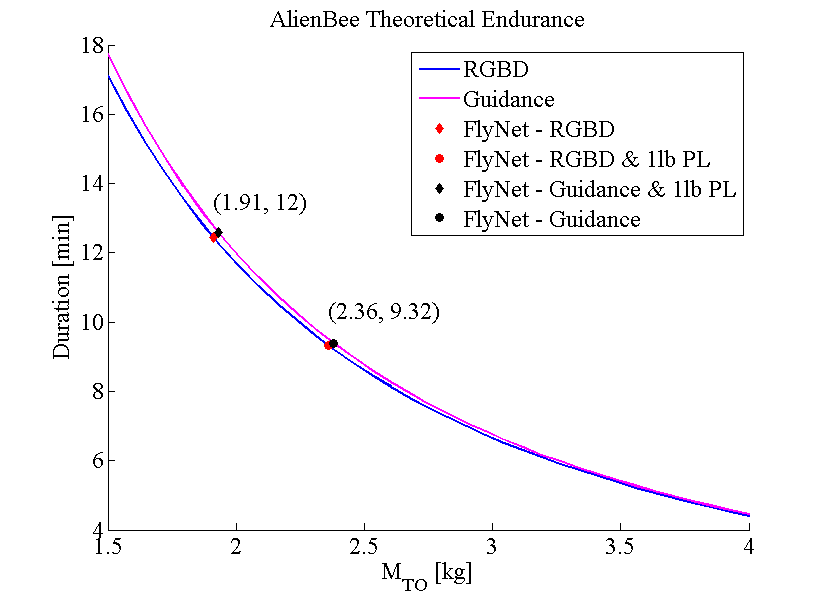
[picture p113: figure]

## Slide 3

Matrice Endurance vs. Payload

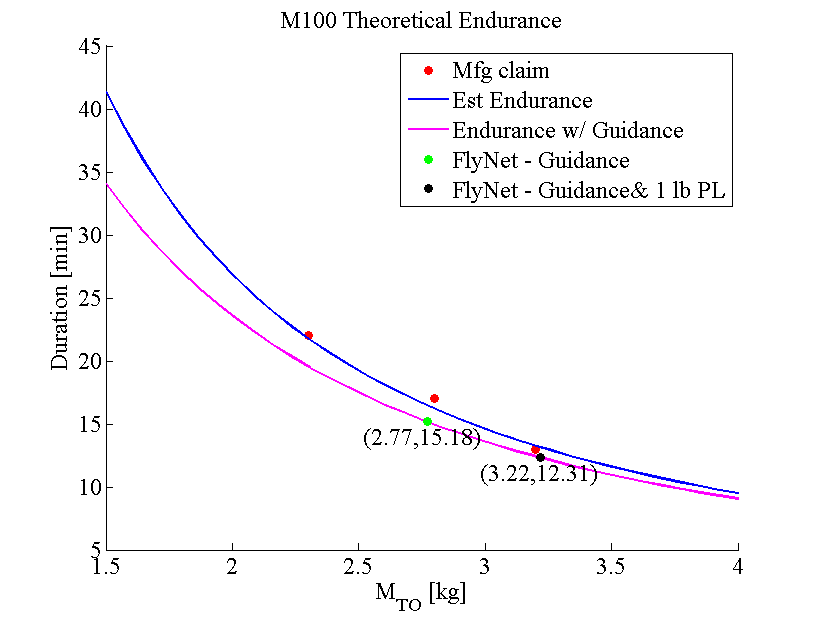
[picture p114: figure]
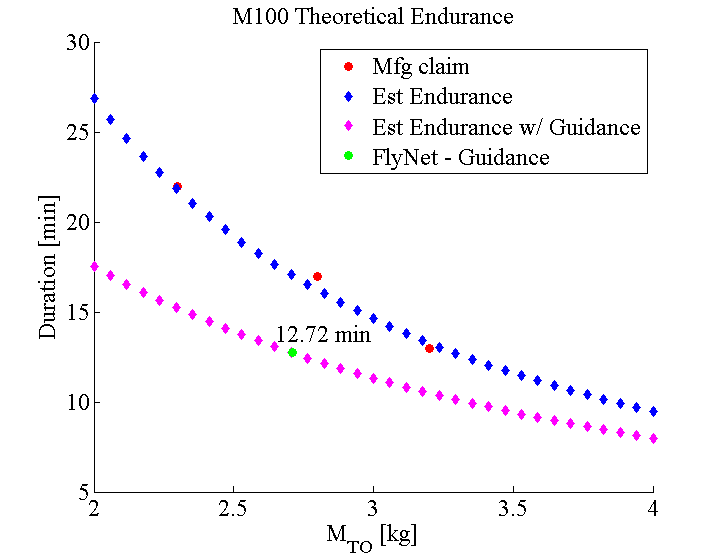
[picture p115: figure]

## Slide 4

FlyNet: Autonomous Quadcopter Search and Rescue

System | Mass Normal (1lb PL) [kg] | Endurance [min] | Endurance w/ 1lb PL [min]
M100 | 2.77 (3.22) | 15.2 | 12.3
AlienBee w/ RGBD | 1.91 (2.36) | 12.4 | 9.3
AlienBee w/ Guidance | 1.93 (2.38) | 12.6 | 9.4

## Slide 5

Matrice 100 Mass Budget

Item | QTY | Mass [g]
Intelligent Flight Battery TB47D | 1 | 600
Odroid XU4 | 1 | 64.2
FLIR Lepton LWIR Camera | 1 | 0.55
Guidance | 1 | 291
DJI Matrice 100 | 1 | 1083
Customer Payload (1lb) | 1 | 453.59
DJI E 620D ESC (E800) | 4 | 43
DJI 1345s Propellor (E800) | 4 | 19
DJI 3510 Motor (E800) | 4 | 106
TOTAL | | 3220
