dtbinh/FlyNet/Presentations/Mid Semester Review/slide_contributions/Ed.pptx

Pixhawk Control Architecture

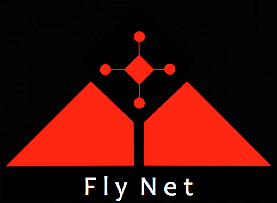
[picture p116: figure]

Position Control

Position Control

Horizontal
Control

Vertical
Control

Position Rate Control

Horizontal Rate Control

Altitude Control

Attitude Control

Euler Angles

Attitude Rate Control

Roll Rate

Pitch Rate

Attitude Control

Yaw Rate

Position setpoint

X, Y, Z
Vx, Vy, Vz

Attitudesetpoint

Roll, Pitch, Yaw, Throttle

Multirotor Mixer

Manual RC

Manual RC

Current position and velocity

Euler rotation matrix

Velocity estimate

Accelerometer

GPS

Barometer

Sonar

Flow

Position Estimator

Velocity

Accelerometer

GPS

Magnetometer

Flow

Attitude Estimator

Attitude
