dtbinh/FlyNet/Presentations/Mid Semester Review/slide_contributions/bryce_slides.pptx

FlyNet: Autonomous Quadcopter Search and Rescue

## Motivation

Req 1: The system shall perform a search for targets in and unknown environment
Req 9: The system shall operate in various indoor lighting conditions

FlyNet: Autonomous Quadcopter Search and Rescue

Notes: Basic flight environment description

## System Interface

- Linux companion computer
  - Path planner
  - Obstacle avoidance

FlyNet: Autonomous Quadcopter Search and Rescue

Notes: Need to dedicate significant amount of time to systems level tasks i.e leave low level controllers alone if possible

## Vehicle Control

Strategy:
- Use as many onboard(autopilot) processes as possible
- Use off the shelf hardware/software wherever possible
1st Iteration:
- Run position/attitude/altitude controllers on Pixhawk
- Use Pixhawk controllers

FlyNet: Autonomous Quadcopter Search and Rescue

## Pixhawk Hardware

FlyNet: Autonomous Quadcopter Search and Rescue

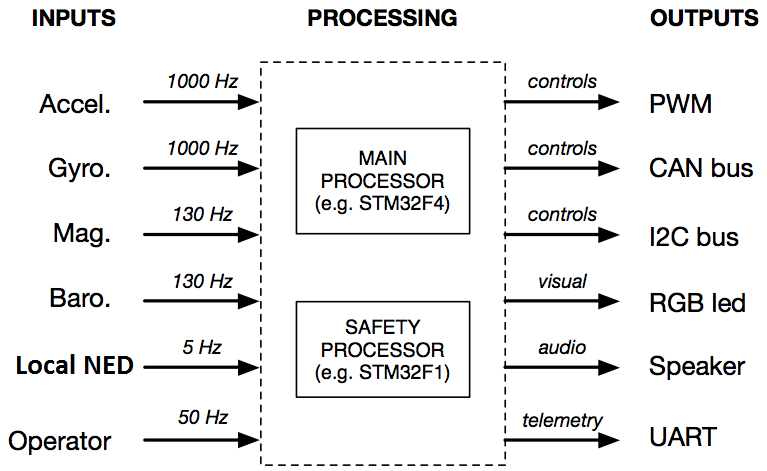
[picture p117: figure]

Notes: Replace gps with local ned

## Pixhawk – Off-board Computer Interface

FlyNet: Autonomous Quadcopter Search and Rescue

Embedded Controller (Pixhawk)

uORB publish/subcribe bus

Position Controller

Attitude Controller

Linux Companion Computer

ROS publish/subscribe bus

Actuator & Sensor Interface

Safety Controller

SLAM

Obstacle Avoidance

Local NED Subscriber

Planner Generated Set point

UART MAVlink
>250 Hz
< 1 ms latency

Local NED Publisher

Path
Planner

Modified

Custom

Preexisting

## Slide 7

FlyNet: Autonomous Quadcopter Search and Rescue

IMU

p,q,r | ax-b ay-b az-b |φbθbψb

Path Planner

Acceleration
Set point

Quadrotor

Actuator Allocator

Attitude Controller

Position Controller

Velocity
Set point

Controller Decision Gate

Position
Set point

Custom

Hardware

Preexisting

Altitude
Set point
