dtbinh/FlyNet/Presentations/Mid Semester Review/slide_contributions/prashant.pptx

## Sensors

FlyNet: Autonomous Quadcopter Search and Rescue

## Sonar

- Sonar Max MB 1200 (Broad Beam)
  - Most sensitive
  - Low power consumption
  - Less sensitive to noise clutter
- Sonar Max MB 1240 (Narrow Beam)
  - Large target detection
  - Better acoustic noise rejection

FlyNet: Autonomous Quadcopter Search and Rescue

## Ultrasonics Specification

- Current drawn –
  - 5V – 3.4mA
  - 3.3V – 2.1mA
- Min. reported distance – 20 cm
- Max. range – 765 cm
- Refresh rate – 99uS
- Modes of operation
  - PWM
  - Analog
  - RS232
- Auto calibrates

FlyNet: Autonomous Quadcopter Search and Rescue

## Plots

FlyNet: Autonomous Quadcopter Search and Rescue

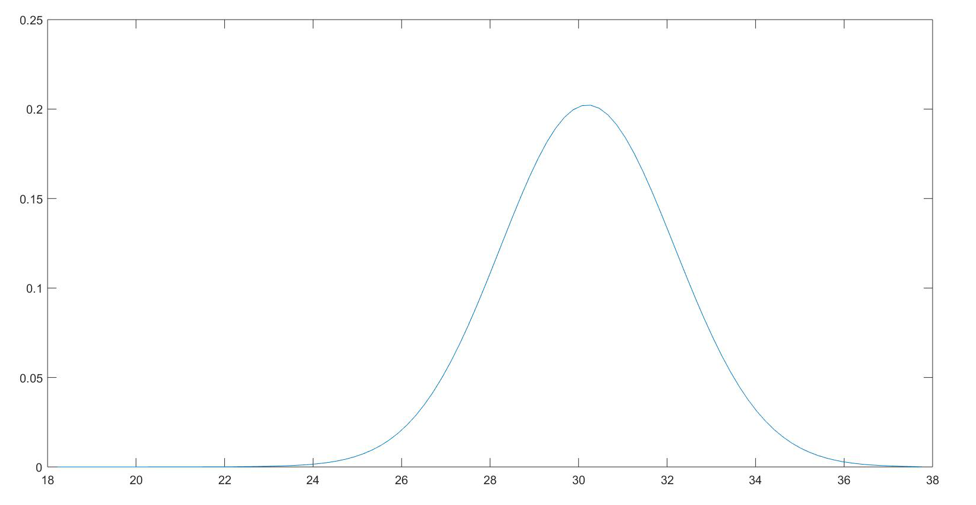
[picture p118: figure]

Sonar Max MB1200 PDF – Analog Mode

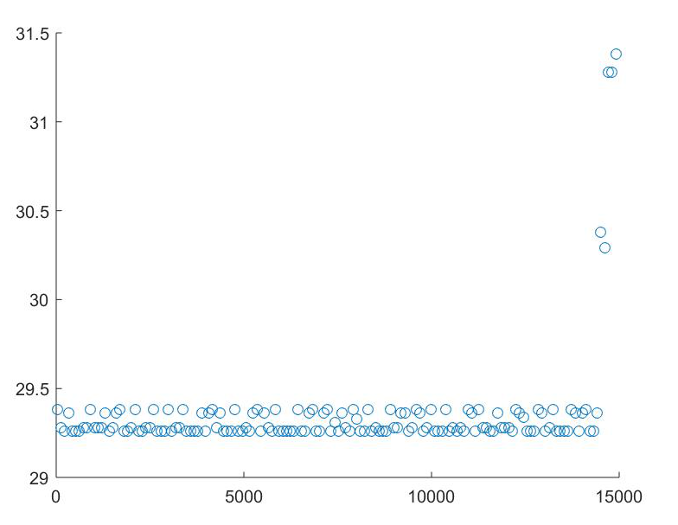
[picture p119: figure]

Sonar Max MB1200 Scatter plot– PWM Mode

Object placed 29 cm from sensor

## Plots

FlyNet: Autonomous Quadcopter Search and Rescue

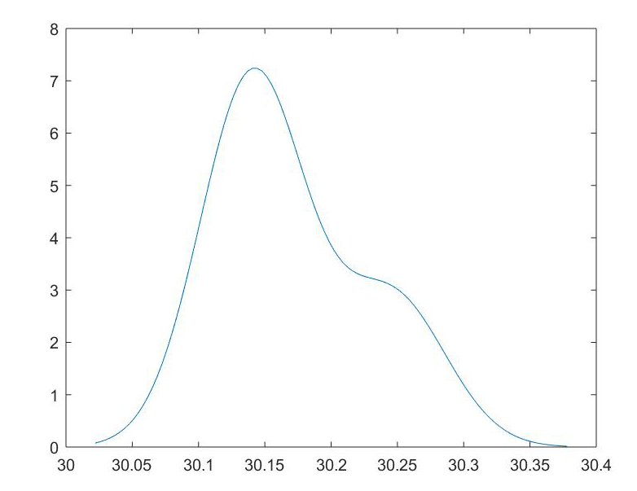
[picture p120: figure]

MB1240 PDF PWM Mode

Object placed 30 cm from sensor

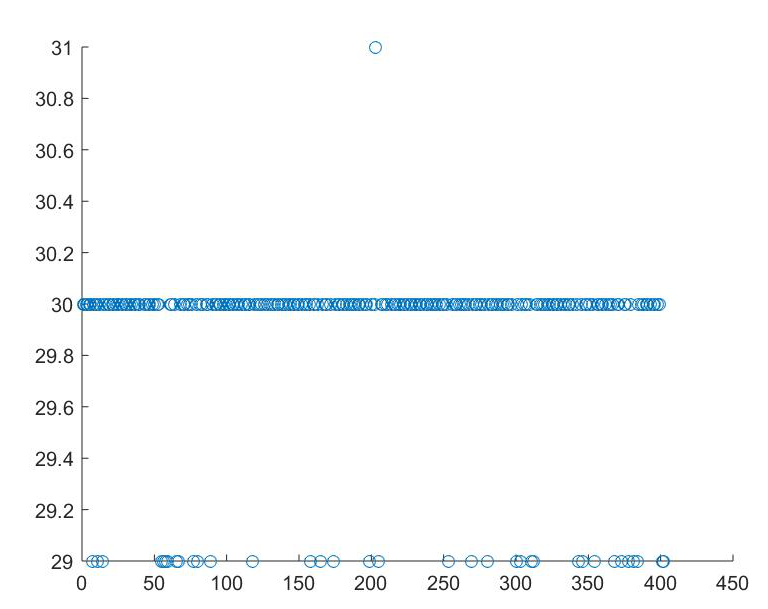
[picture p121: figure]

MB1240 Scatter Plot PWM Mode

## Slide 6

FlyNet: Autonomous Quadcopter Search and Rescue

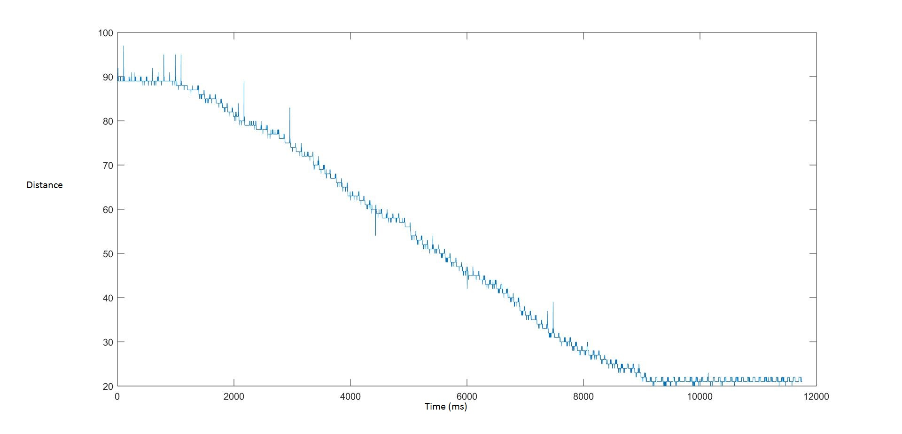
[picture p122: figure]

Sensor moved from 90 cm to almost 5 cm from wall

MB1240 Plot When sensor is in motion

## Slide 7

FlyNet: Autonomous Quadcopter Search and Rescue

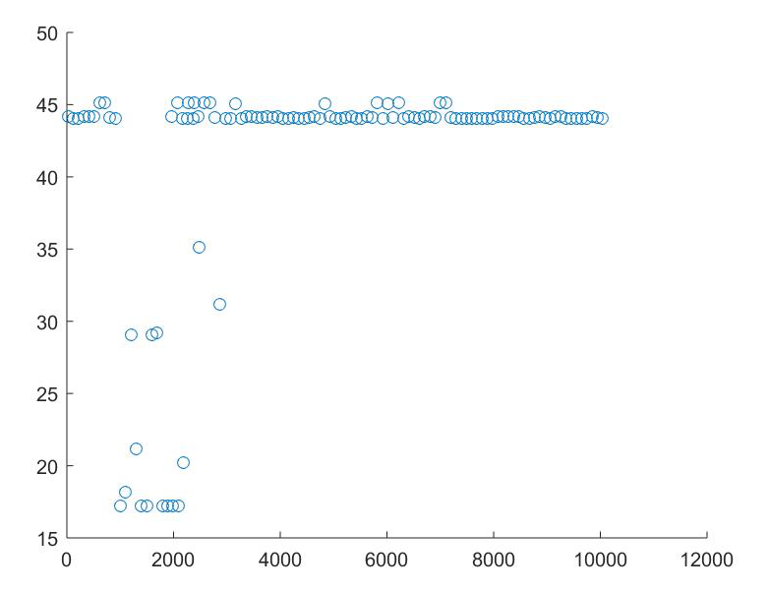
[picture p123: figure]

MB1240 in clutter
x axis – time in ms
Y axis – distance in cm

Sensor placed 44 cm from wall

## LiDAR

- Range 0-40m
- Current consumption <100mA
- Max Repetition rate – 500 Hz
- Acquisition time 0.02 seconds
- Modes of communication
  - I2C
  - PWM

FlyNet: Autonomous Quadcopter Search and Rescue

## Plots

FlyNet: Autonomous Quadcopter Search and Rescue

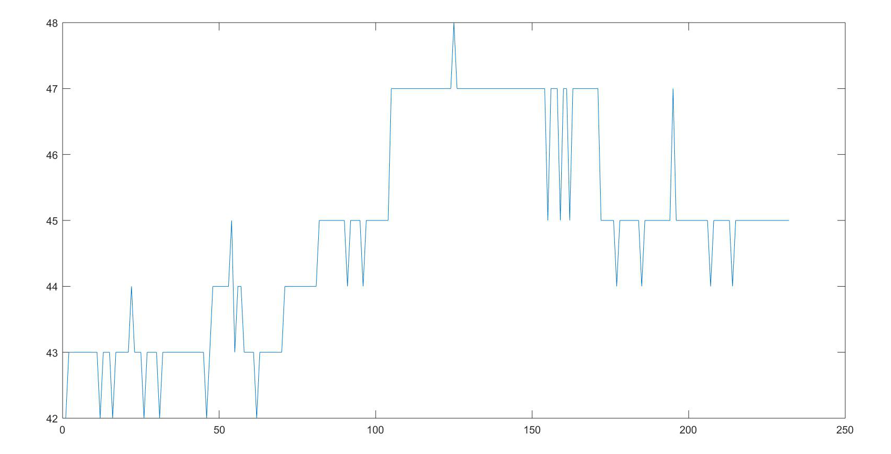
[picture p124: figure]

LiDAR Lite Plot

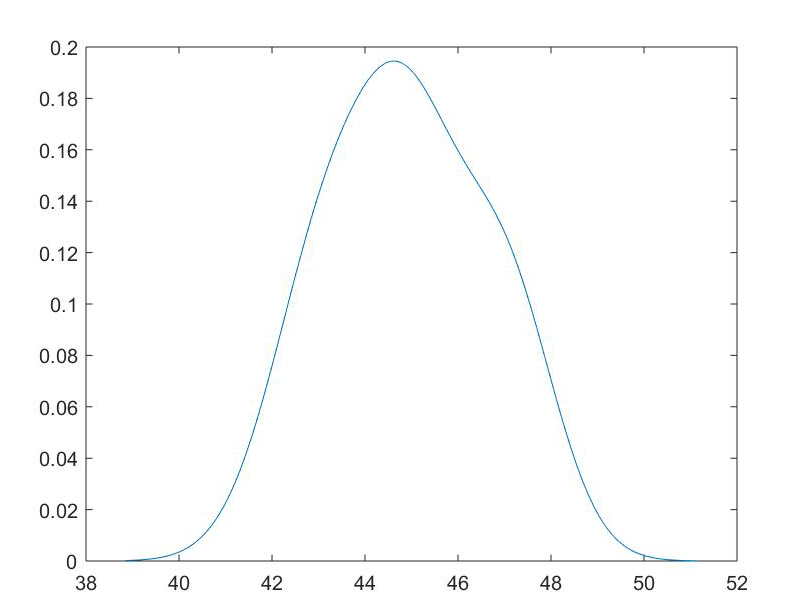
[picture p125: figure]

LiDAR Lite PDF

Sensor placed 44 cm from wall
