dtbinh/FlyNet/Presentations/Mid Semester Review/slide_contributions/taylor.pptx

Tracking

Motivation: Req. 1.2.1: The system shall identify human targets within 5 meters
Req. 2: The system shall track visually identified targets

## Slide 2

Tracking Method

- Must process images at >= 10 Hz (Req. 2.2.1)
  - Use C++ and OpenCV for low-overhead image processing
- OpenCV has significant documentation and many useful libraries
- OpenCV used in conjunction with Multiple Hypothesis Tracking (MHT) and Kalman Filtering will provide quick and accurate tracking solutions
- Preliminary Sensor: Lepton 80x60 Pixel LWIR camera
  - Provides contrast between human and background

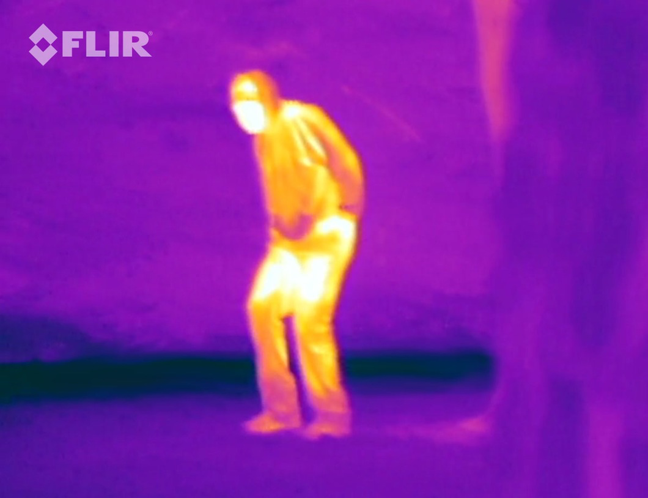
[picture p126: figure]

## Slide 3

Algorithm Overview

Obtain Object Measurements
Generate Hypotheses
Prune Hypotheses
Correlate Hypotheses with Previous Feasible Tracks
Prune Feasible Tracks
Publish Confirmed Tracks

## Slide 4

Obtaining Measurements from Images

Obtain Image

Mask Image

Find Contours

Save Features

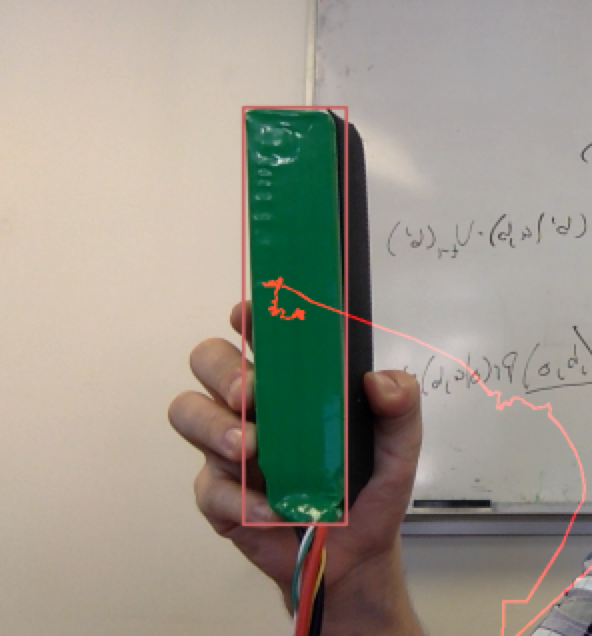
[picture p127: figure]
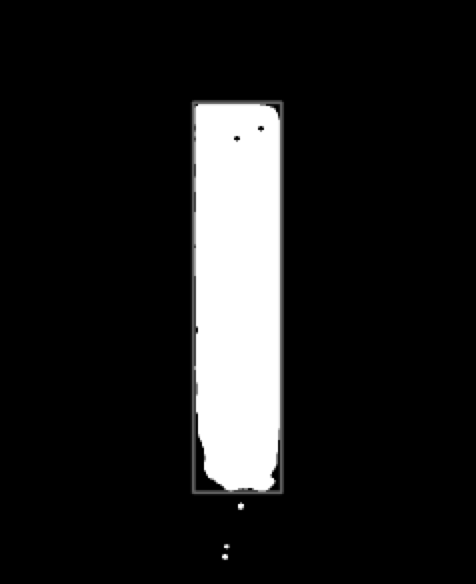
[picture p128: figure]
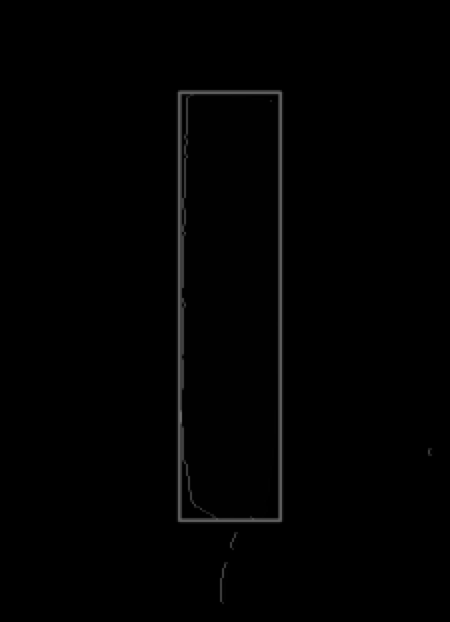
[picture p129: figure]

Features:
- Area
- X Position
- Y Position
Computed Features:
- Δ Area
- X Velocity
- Y Velocity

## Slide 5

Algorithm Overview

Obtain Object Measurements
Generate Hypotheses
Prune Hypotheses
Correlate Hypotheses with Previous Feasible Tracks
Prune Feasible Tracks
Publish Confirmed Tracks

## Slide 6

Generating Hypotheses

Objects of interest are detected at t0

t0

## Slide 7

Generating Hypotheses

New objects of interest are detected at t1 and they can be associated to form feasible tracks

t1

## Slide 8

Generating Hypotheses

New objects of interest are detected at t1 and they can be associated to form feasible tracks

t1

## Slide 9

Algorithm Overview

Obtain Object Measurements
Generate Hypotheses
Prune Hypotheses
Correlate Hypotheses with Previous Feasible Tracks
Prune Feasible Tracks
Publish Confirmed Tracks

## Slide 10

Pruning Hypotheses

These may be down selected using a velocity constraint

t1

## Slide 11

Pruning Hypotheses

This velocity constraint is used as follows:

t1

## Slide 12

Pruning Hypotheses

Propagate the measurement’s state for one period:

t1

## Slide 13

Pruning Hypotheses

Apply an error bound:

t1

## Slide 14

Pruning Hypotheses

Prune hypotheses down to those that fit within velocity constraint

t1

## Slide 15

Algorithm Overview

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

## Slide 16

Prune Feasible Tracks

Continue to form feasible tracks until tracks become improbable

t2

## Slide 17

Algorithm Overview

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

## Slide 18

Prune Feasible Tracks

Track is terminated after no new correlated objects

t3

## Slide 19

State Transition Matrix

A State Transition Matrix (STM) can be used to further constrain the location of future object measurements

## Slide 20

Kalman Filtering
