dtbinh/FlyNet/Administration/Documentation/flynet_requirements_chart_10_19_15.xlsx

Level 1 Requirement | Level 2 Requirement | Level 3 Requirement | Requirement Label | Verification | Proposed Solution
The system shall perform a search for targets | The system shall visually identify targets | The system shall have visual sensor(s) | 1.1.1 | Record images | ASUS Xtion Live Pro (RGBD Camera)
 |  | The system shall be capable of processing imagery | 1.1.2 | Load images into processing software | Interfacing Xtion with onboard processor
 |  | The system shall locate individual targets in images with 95% probability of detection | 1.1.3 | Correctly identify all targets in image with 95% accuracy, run statistics on experimental results | Tune parameters of OpenCV tracking software to identify targets with correct POD
 |  | The system shall identify human targets within 5 meters | 1.1.4 | Run experiments on identification percentage at various distances to target in order to characterize visual identification range | Resolution of RGBD camera
 | The system shall navigate an unknown environment, using partial, prior information, e.g. building plans. | The vehicles shall avoid unrecoverable collisions with obstacles | 1.2.1 | Send the obstacle on trajectory with collision on the course, verify that the obstacle is avoided. | Use of laser/ultrasonic rangefinders
 |  | The system shall plan vehicle trajectories through the environment | 1.2.2 | Calculate a trajectory and report waypoints between current position and desired position, visually verify results | ???
 |  | The vehicles shall move through the environment along planned trajectories to within 20 RMS error of the planned trajectory when no obstacles are present. | 1.2.3 | The system shall plan and record a trajectory through a course of obstacles. The position of the moving vehicle will be recorded by a VICON system. The measured position and trajectory waypoints will be used to characterize the RMS position error | Interfacing of trajectory planner with Pixhawk position controller
 |  | The aerial vehicle will maintain a minimum distance of 5 cm from obstacles | 1.2.4 | The vehicle will be sent on a crash course with obstacles, the minimum distance between vehicle and obstacle will be measured by a VICON system | Position control/obstacle avoidance algorithms will maintain distance
 | The system shall search a 50,000 ft^2 area | The system shall have power to sustain 10 minutes of search time with full payload | 1.3.1 | The system will be sent on a racetrack trajectory and the total capable search time measured. | Battery and motor choices? Platform choice/weight and sensor and computer weights
 |  | The system shall travel a minimum of 1 mile | 1.3.2 | The total distance travelled during the verification of 1.3.1 will be calculated | Platform and battery choice
The system shall track visually identified targets | Each PPU shall have the ability to track targets | The PPU shall estimate target position to within 0.5 meters | 2.1.1 | The estimated position of the target on the system will be compared with that of the target position recorded by a VICON system. | Use of Kalman filter and range information from RGBD camera to localize target
 |  | Each PPU shall estimate at least 2 visually identified target tracks | 2.1.2 | 10 targets will be placed in the field of view of the visual sensor and estimated positions of visually identified targets will be reported | Association filter for creating new tracks and associating measurements?
 |  | Each PPU shall maintain estimates of all confirmed target tracks | 2.1.3 | The system will report tracks of confirmed targets and report them over the course of its search | Confirmed targets will not demise after any time, algorithm spec
 | PPUs shall track targets moving up to 2 m/s along the ground | PPUs shall process target estimates at 10 Hz (derived from 2.1.1) | 2.2.1 | The time of each updated track position shall be reported | NVIDIA Jetson for processing power
The system shall consist of a team of at least 2 robots | The system shall have at least 1 aerial vehicle | The vehicle shall have a manual override mode | 3.1.1 | Visually verified flight | Quadrotor aerial vehicle
 |  | The aerial vehicle shall be able to take off autonomusly | 3.1.2 | An autonomous take will be visually verified | Autonomous take off sequence for quad through software, uses altimeter (rangefinder)
 |  | The aerial vehicle shall be able to land autonomously without unrecoverable collision | 3.1.3 | An autonomus landing will visually verified | Autonomous landing sequence for quad through software, uses altimeter (rangefinder)
The system shall be autonomous, i.e. no human input once the system begins a search. | The system shall not rely on external processing | The system shall carry processing capabilities onboard | 4.1.1 | All computing platforms will be mounted onboard system vehicles | NVIDIA Jetson
 |  | The system shall perform perception onboard | 4.1.2 | All perception operations will occur on onboard computing platforms. Design requirement | Jetson
 | The system shall not have any off-vehicle sensors | The system shall carry sensing capabilities onboard | 4.2.1 | Deisgn requirement | Xtion, rangefinders
 | The system shall not have access to external power supplies | The system shall carry all vehicle and PPU power supplies onboard | 4.3.1 | Design requirement | Quadrotor H frame with acceptable payload capabilities
 | The system shall not have external navigation and targeting commands | The system shall make all navigation decisions onboard | 4.4.1 | Design requirement | Algorithms on Jetson
The aerial vehicle shall be capable of delivering a 0.5 lb payload | The vehicle shall produce enough lift to carry itself and the additional payload | The vehicle shall carry a 1lb payload | 5.1.1 | Flight testing with additional payload attached | Quadrotor platform
 | The aerial vehicle shall navigate to a delivery zone | The aerial vehicle shall identify the delivery zone within 5 meters confirmed target ID and target position. | 5.2.1 | Perceived landing zone position shall be reported | Localization algorithms, target ID algorithms
 | The aerial vehicle should autonomously deliver the payload | The aerial vehicle should be equipped with a payload release mechanism | 5.3.1 | Design requirement | ???
 |  | The aerial vehicle should autonomously place the payload in the delivery zone | 5.3.2 | Visually verify payload release | ???
The vehicle PPUs shall communicate obstacle and target state information with other PPUs | The vehicles shall maintain communication intermittently throughout the mission amongst themselves | PPUs shall each have the capability to receive data | 7.1.1 | Send test data packets and PPU will report received status | LTE, Wifi, Radio transmitter
 |  | PPUs shall each have the capability to transmit data | 7.1.2 | PPU will send test packets, receiving system will report received status | LTE, Wifi, Radio receiver
 | The system shall detect the position of obstacles | PPUs shall have an obstacle sensor | 7.2.1 | Design requirement | Xtion
 |  | PPUs shall have an obstacle perceiver | 7.2.2 | PPU will report perceived obstacle positions, verified against VICON position measurement of obstacles | SLAM Algorithm
 | The system shall share obstacle information | PPUs shall maintain an obstacle map | 7.3.1 | See verification of 7.2.2 | SLAM Algorithm
 |  | PPUs will have the ability to communicate their obstacle map to other PPUs | 7.3.2 | PPUs will report the received maps from other PPUs | ROS
 | The system shall share target information | The system shall have the ability to communicate confirmed target tracks | 7.4.1 | PPUs will report all receied confirmed tracks | ROS
The system shall tag/confirm targets using pre-tagged identifiers | The targets will be pre tagged | Tags shall be transferable | 8.1.1 | Design requirement | QR Codes
 | The system shall be capable of identifying tags | The system shall have a target tag sensor/identifier | 8.2.1 | The system will report identified tags | Xtion
 | The system shall confirm targets tags | The system shall detect target tags with 95% probability of detection | 8.3.1 | Statistical tests on verification of 8.2.1 | Xtion/OpenCV
 |  | The system shall detect target tags within 5 meters | 8.3.2 | Range tests on verification of 8.2.1 | Xtion/OpenCV
 | Tags shall be independently identifiable | Tags shall have a uniquely determined, measurable characteristic | 8.4.1 | Report tag ID number, confirm all tags are uniquely identified | QR Codes
Keywords/Acronyms | Definition
System | Team of vehicles + PPUs performing the mission
Vehicle
Mission | Searching an unknown territory for a target
Target | A human or object of interest for searching/tracking
Perception | Interpretation/manipulation of data from sensors
Platform | The vehicle frame, electronics, and (if applicable) motors and wheels. Does not include PPU.
PPU (Perception and Planning Unit) | All hardware necessary to perform computation, sensing, and send movement commands to a vehicle. Includes autopilot and additional sensors (when applicable). There will be one PPU per vehicle
External Weight | Any weight that is additional to platform and PPU weight
Onboard | Attached to any one of the vehicles in the system
Unrecoverable Collision | A collision which renders the vehicle incapable of moving.
Change Log:
Removed lighting requirement
Altered frame rate requirement on FLiR
Replace 1lb payload with 0.25lb
