dtbinh/FlyNet/Technical/Hardware/budget.xlsx

Hardware Name | Total Cost | Category | Computer Totals | Flight Hardware Totals | Sensor Totals
NVIDIA Jetson Dev Board | 190.49 | 1 | 190.49 | 0 | 0
ASUS Xtion Pro Live | 170 | 3 | 0 | 0 | 170
Laser Range Finder | 114.95 | 3 | 0 | 0 | 114.95
Ultrasonic Range Finder (wide beam) | 49.95 | 3 | 0 | 0 | 49.95
Ultrasonic Range Finder (narrow beam) | 49.95 | 3 | 0 | 0 | 49.95
Teensy board | 39.9 | 1 | 39.9 | 0 | 0
ODROID XU4 | 75 | 1 | 75 | 0 | 0
Headers | 7.5 | 2 | 0 | 7.5 | 0
Breadboard | 5.95 | 2 | 0 | 5.95 | 0
Jumpers | 3.95 | 2 | 0 | 3.95 | 0
Wire Kit | 6.95 | 2 | 0 | 6.95 | 0
Guidance | $800.00 | 3 | 0 | 0 | 800
FLiR Camera Sensor | $260.00 | 3 | 0 | 0 | 260
XU4 Shifter Shield | $18.00 | 1 | 18 | 0 | 0
ODROID USB-CAM | $17.00 | 3 | 0 | 0 | 17
Propellers for Aliencopter Bee (your call on choice) | $40 | 2 | 0 | 40 | 0
HDMI Cable | $5.50 | 2 | 0 | 5.5 | 0
DJI Mounting Gear | $148.00 | 2 | 0 | 148 | 0
Flir Mounting Hardware | $7.71 | 2 | 0 | 7.71 | 0
Odroids + Peripherals x 2 | $362.10 | 1 | 362.1 | 0 | 0
Final demo supplies | $371.11 | 2 | 0 | 371.11 | 0
New Aliencopter Bee | $152.49 | 2 | 0 | 152.49 | 0
 |  | Total | 685.49 | 749.16 | 1461.85
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
