dtbinh/FlyNet/Presentations/Mid Semester Review/slide_contributions/Busby_Slides.pptx

FlyNet: End of Semester Test

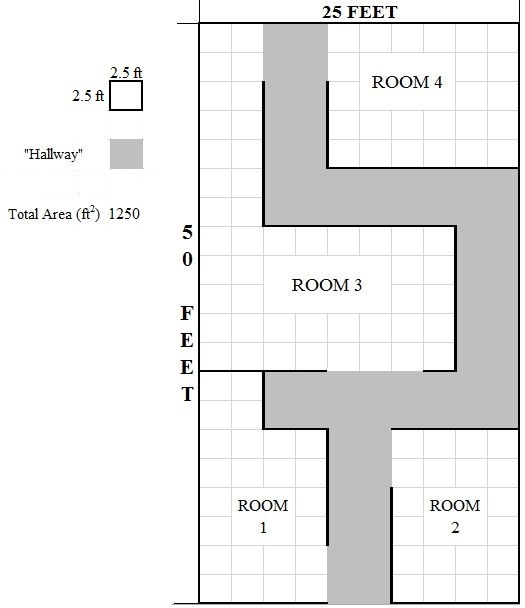
[picture p148: figure]

Setup:
- Known blueprint of area
- Set up in Fleming Vicon Cage
- Multiple rooms
- Includes various hallway types
  - Dead end
  - Left turn
  - Right turn

## Slide 2

FlyNet: End of Semester Test

“Roadblock”

“Target”

“Complete Block”

Unknowns:
- Three “Roadblocks” placed into map
  - 4’ x 3’ wall
  - Placed into map
- “Target” placed into map
- One “Complete Block” placed into map
  - 4’ x 6’ wall
  - Height of standard wall for test environment

## Slide 3

FlyNet: End of Semester Test

“Roadblock”

“Target”

Entry/Exit Point

“Complete Block”

Tasks to Complete:
- Explore entire map
- Avoid all obstacles
  - Walls
  - “Roadblocks”
  - “Complete Blocks”
- Return back to Entry Point with entire area mapped
