dtbinh/FlyNet/Presentations/Mid Semester Review/Individual_Slides/Steve/visodo_slides/figures/imu-6050.pdf

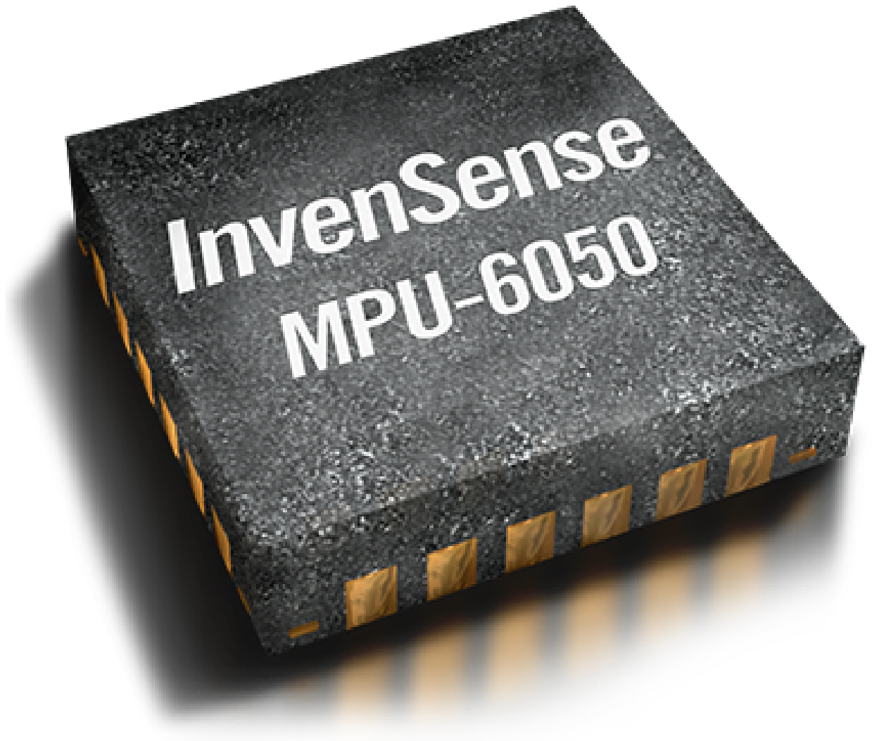
[picture p150: page 1]
