dtbinh/FlyNet/Presentations/Mid Semester Review/Individual_Slides/Steve/visodo_slides/figures/octree.pdf

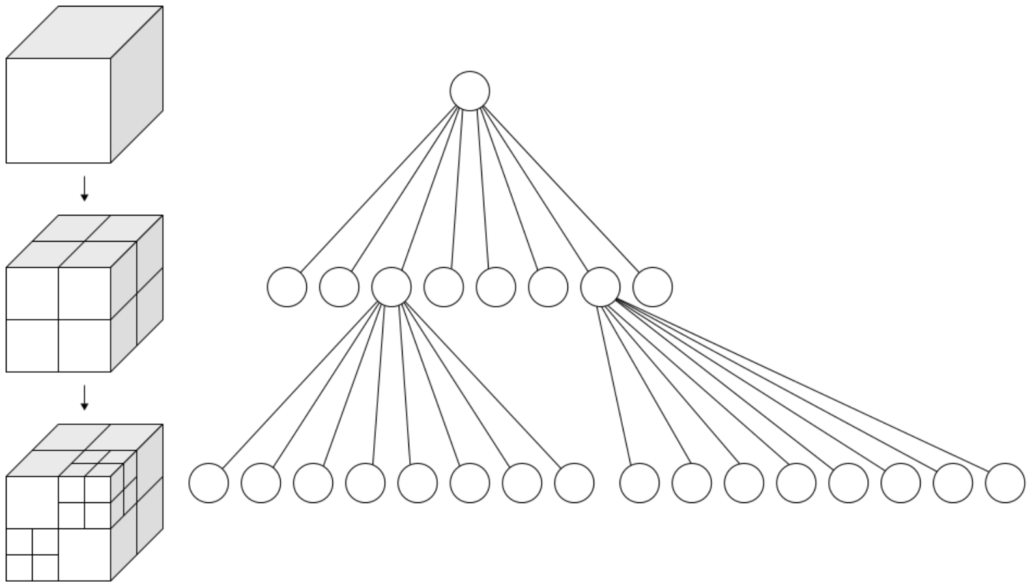
[picture p151: page 1]
