dtbinh/FlyNet/Presentations/Mid Semester Review/Individual_Slides/Steve/visodo_slides/figures/xtion_rgb_depth.pdf

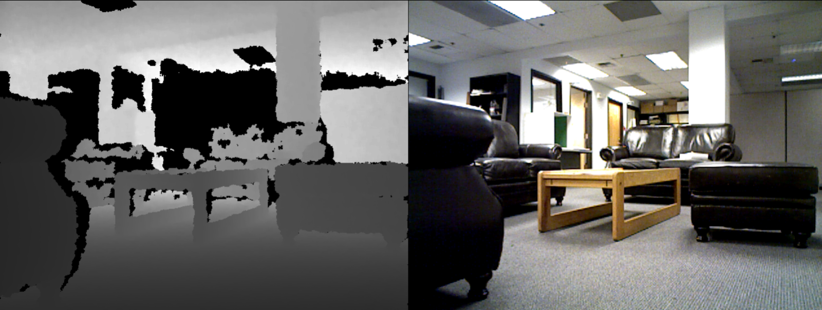
[picture p152: page 1]
