dtbinh/FlyNet/Data/flight_data/xy_traj.jpg

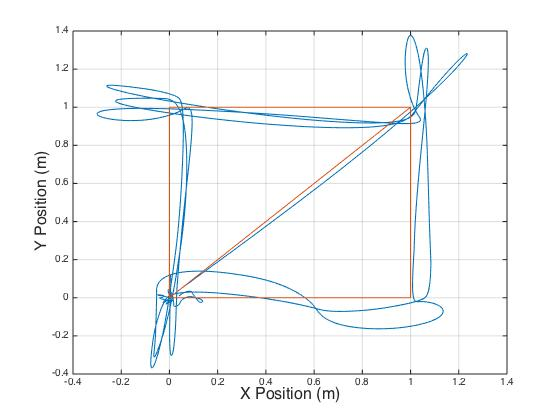
Data/flight_data/xy_traj.jpg
