dtbinh/FlyNet/Data/flight_data/yaw_command_xy_hold.jpg

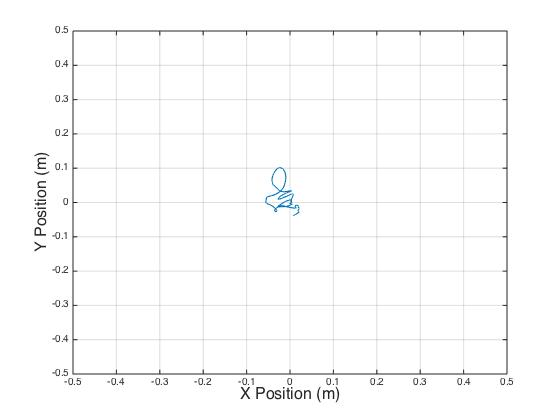
Data/flight_data/yaw_command_xy_hold.jpg
