dtbinh/FlyNet/Data/flight_data/yaw_command_yaw_pose.jpg

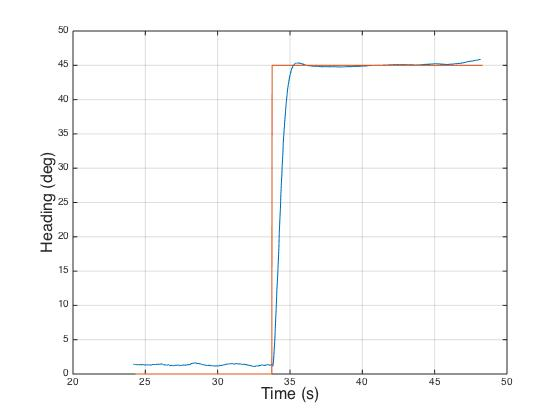
Data/flight_data/yaw_command_yaw_pose.jpg
