dtbinh/FlyNet/Odroid_Files/screenshot.png

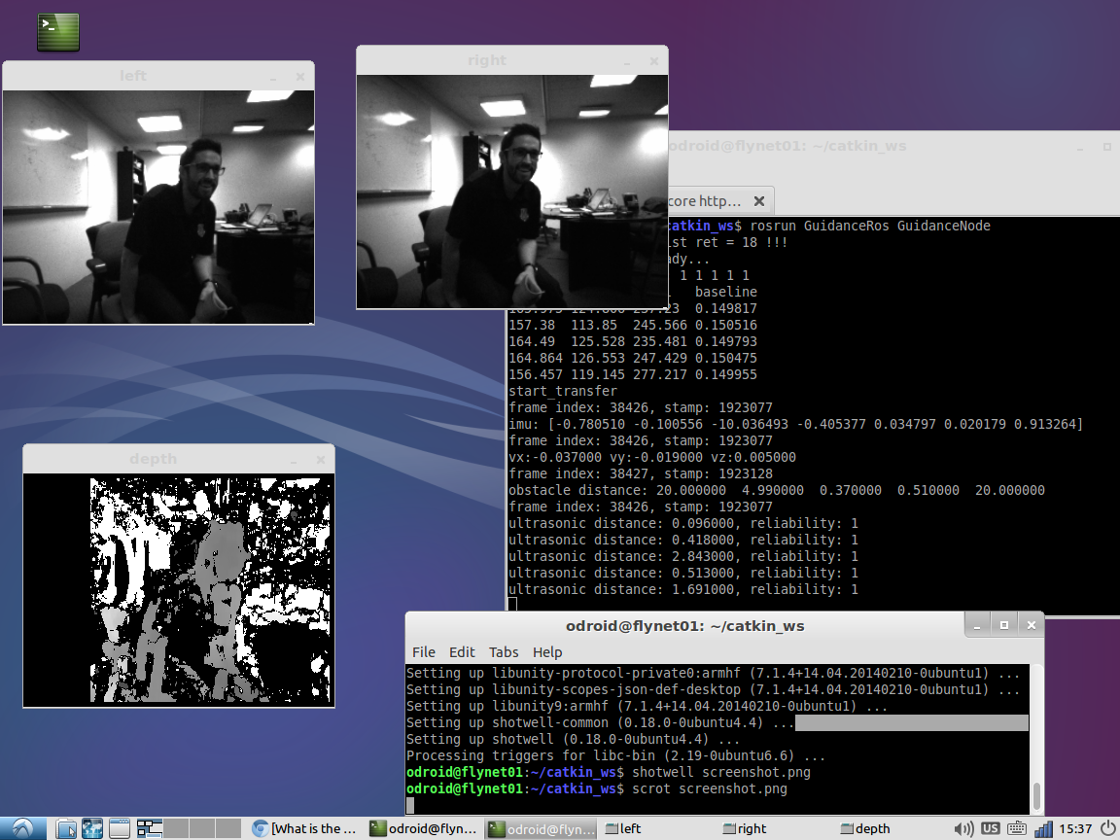
Odroid_Files/screenshot.png
