dtbinh/FlyNet/Presentations/Mid Semester Review/Individual_Slides/Ed/originalPX4.PNG

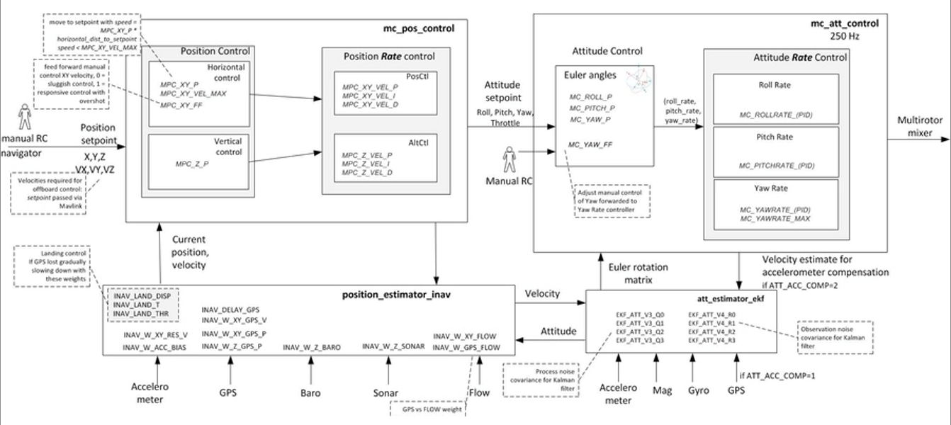
Presentations/Mid Semester Review/Individual_Slides/Ed/originalPX4.PNG
