dtbinh/FlyNet/Presentations/Mid Semester Review/Individual_Slides/Tyler/AB_endurance.png

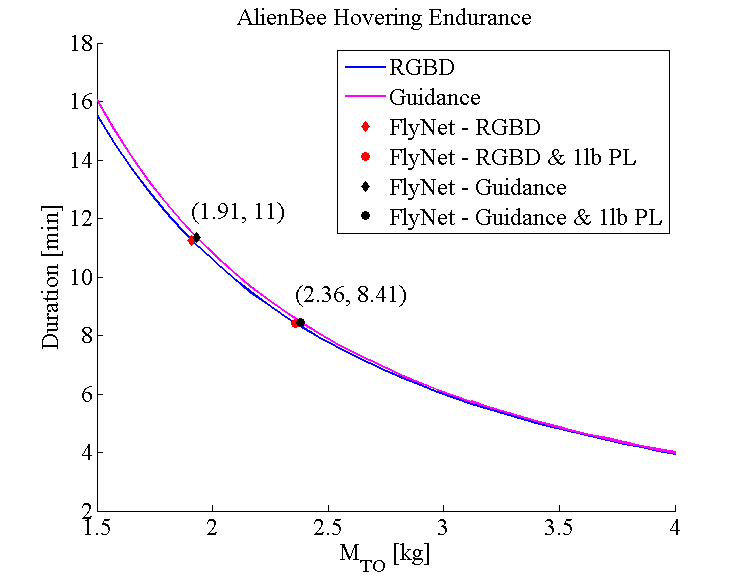
Presentations/Mid Semester Review/Individual_Slides/Tyler/AB_endurance.png
