dtbinh/FlyNet/Presentations/Mid Semester Review/Individual_Slides/Tyler/M100_endurance.png

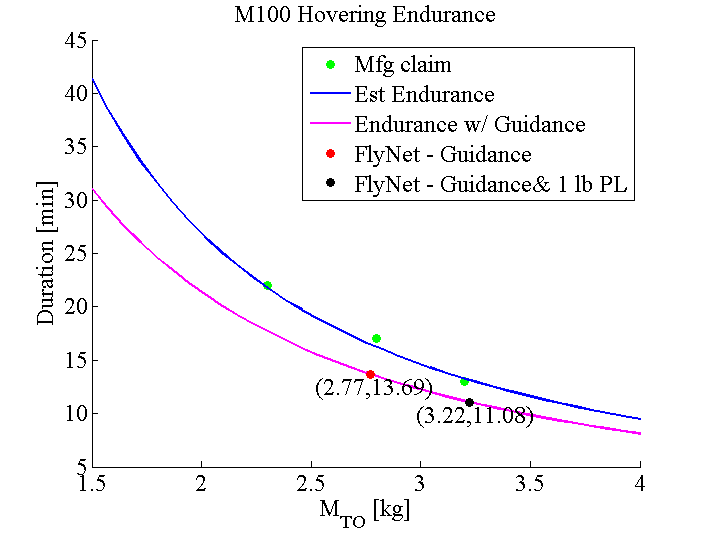
Presentations/Mid Semester Review/Individual_Slides/Tyler/M100_endurance.png
