dtbinh/FlyNet/Technical/pathPlanner/PRM/pathexample.gif

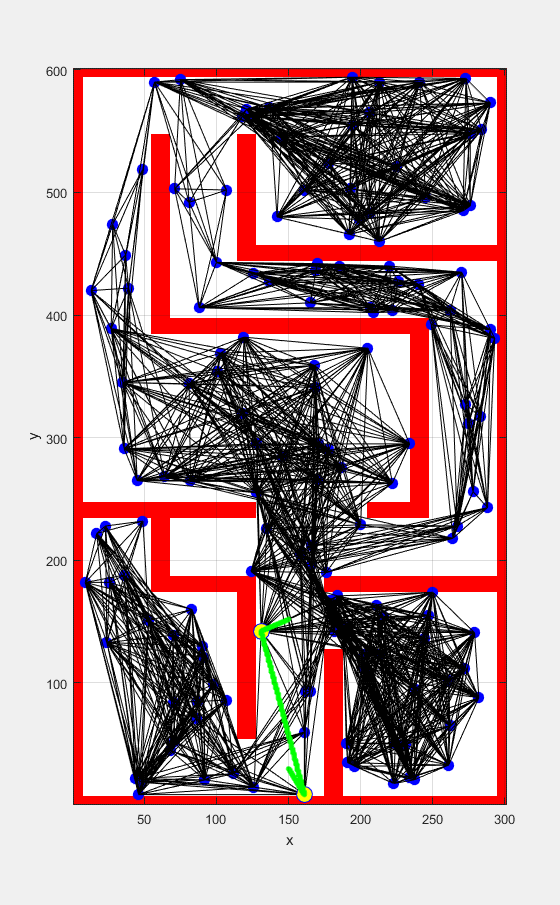
Technical/pathPlanner/PRM/pathexample.gif
