dtbinh/FlyNet/Technical/scripts/rqt_graph_cur.png

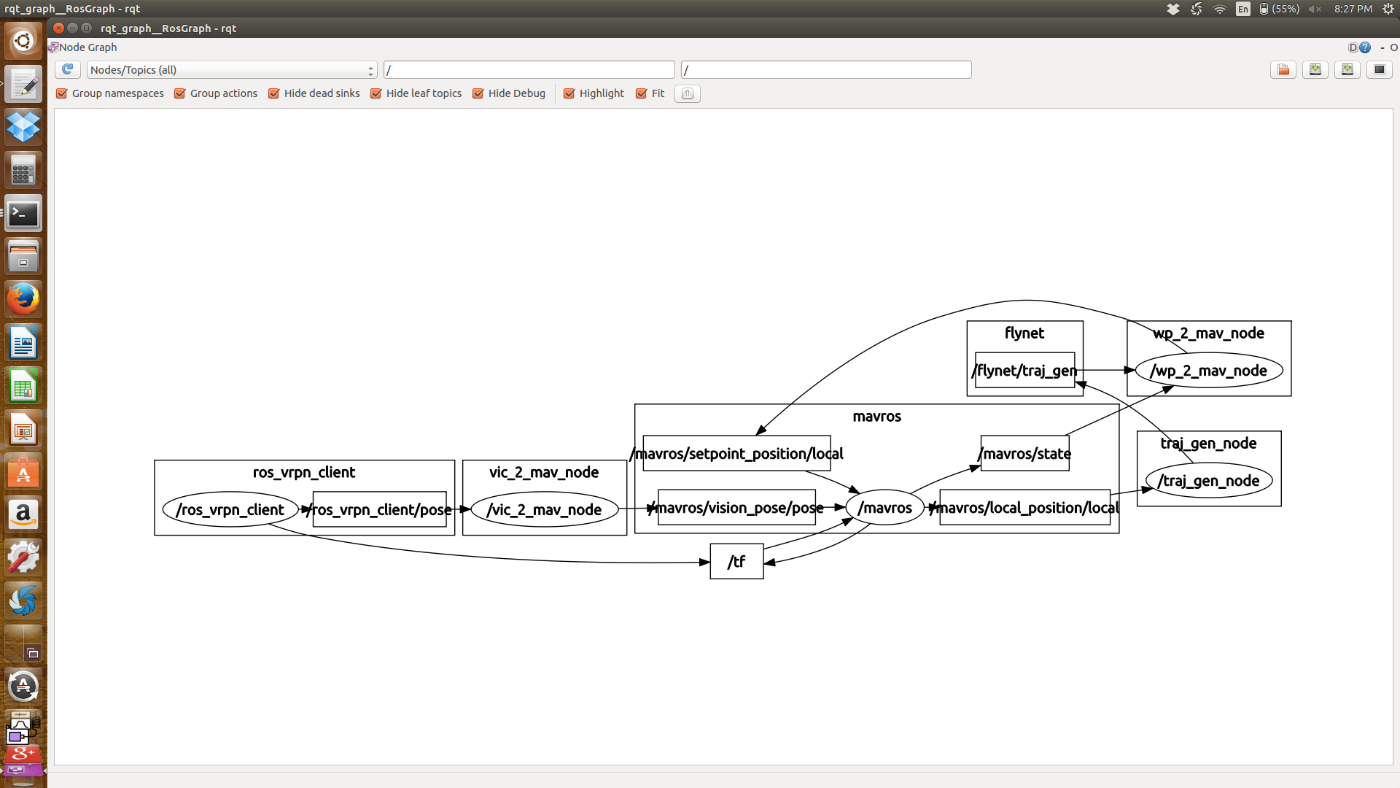
Technical/scripts/rqt_graph_cur.png
