dtbinh/FlyNet/Technical/Technical Budgets/SunnySky Motors.JPG

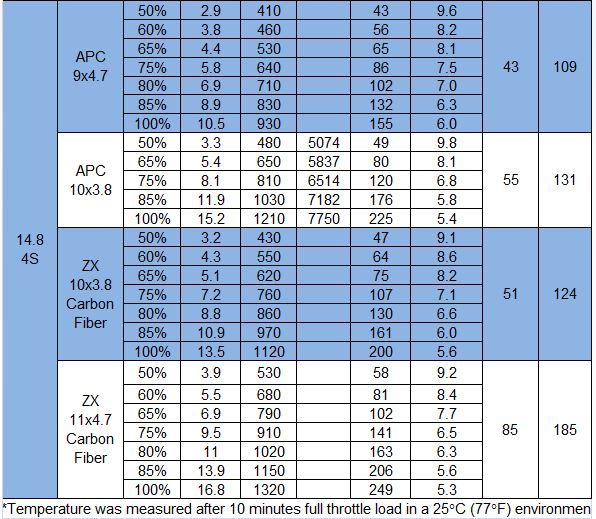
Technical/Technical Budgets/SunnySky Motors.JPG
