dtbinh/FlyNet/Technical/Technical Budgets/PowerMassBOM_ABee_NEW.xlsx

Sheet: Battery
** Voltage is automatically calculated based on the number of cells in the LiPo (3.7V per cell)
Battery | QTY | Mass [g] | Cost [$] | # Cells | Capacity [mAh] | Voltage [V] | Discharge Rate | Length [mm] | Width [mm] | Thickness [mm] | link(s)
Turnigy Nano-Tech LiPo Battery | 1 | 815.8 |  | 4 | 10000 | 14.8 | 10
Total | 1 | 815.8 | $0.00 | 4 | 10000 | 14.8 | 10
Turnigy Multistart 10.0 | 1 | 815.8 |  | 4 | 10000 | 14.8 | 10
Turnigy Nano-Tech Lipo Battery 4.5 | 1 | 482.7 |  | 4 | 4500 | 14.8 | 20

Sheet: Electronics
** Propulsion System is not included in this section, see "Propulsion" Worksheet
Electronics | QTY | Mass [g] | Cost [$] | Power [mW] |  |  | Voltage [V] |  |  | Current [mA] |  |  | link(s)
 |  |  |  | Min | Typical | Max | Min | Typical | Max | Min | Typical | Max
Jetson TK1 | 0 | 143.9 | $192.00 | 3470 | 4000 | 12490 | 9.5 |  | 13.5 | 365.2631579 | 333.3333333 | 1040.833333 | http://developer.download.nvidia.com/embedded/jetson/TK1/docs/Jetson_platform_brief_May2014.pdf http://elinux.org/Jetson/Jetson_TK1_Power
Odroid Xu4 expansion shield | 1 | 21.2
Odroid XU4 & case & dongle | 1 | 83.5 |  |  | 4000 |  |  | 5 |  |  | 4000 |  | http://www.hardkernel.com/main/products/prdt_info.php?g_code=G143452239825&tab_idx=1
FrSky TFR4 Radio Reciever | 1 | 8.7
3DR Radio | 0 | 26.2 |  |  | 330 |  |  | 3.3 |  |  | 100 |  | https://store.3drobotics.com/products/3dr-radio-set
Guidance+custom mounts | 1 | 470.4 |  |  | 12000 | 12000 | 11.1 | 14.8 | 25 |  | 810.8108108
ASUS Xtion Pro Live | 0 |  |  |  | 2500 | 2500 |  | 5 | 5 |  | 500 | 500
Pixhawk | 1 | 40.3 |  |  | 1500 |  |  | 5 |  |  | 300 |  | http://diydrones.com/profiles/blogs/pixhawk-and-apm-power-consumption
power distribution board | 1 | 21
LIDAR-Lite v2 | 0 | 28.1 | $114.95 |  | 550 |  | 4.75 | 5.5 | 6 | 2 | 100 | 100
FLIR Lepton LWIR Camera | 1 | 0.55 | $259.95 | 4 | 150 |  | 2.5 | 2.8 | 3.1 |  | 53.57142857
Windows Lifecam Studio Camera | 0 | 128 | $69.99 |  | 2500 | 2500 |  | 5 | 5 |  | 500 | 500
Total | 7 | 645.65 | $259.95 | 3474 | 17650 | 12000 | 27.85 | 46.4 | 57.6 | 367.2631579 | 5164.382239 | 2140.833333
 | SunnySky V2216-12 KV800 II
 | http://www.buddyrc.com/sunnysky-v2216-12-800kv-ii-brushless-motor.html

Sheet: Dead Mass
** Dead Mass includes any structures, payloads, or other added mass that is not part of the propulsion system, electronics, or batteries
Dead Mass | QTY | Mass [g] | Cost [$] | Length [mm] | Width [mm] | Thickness [mm] | link(s)
ALIEN BEE Quad Structure | 1 | 303 | $126.30 |  |  |  | http://www.hobbyking.com/hobbyking/store/__61487__AlienCopter_Bee_full_Carbon_KIT_W_Clean_and_Dirty_System_and_PDB_W_BEC.html
VICON IR Orbs | 0 | 11.2
Landing Gear | 4 | 22.5
Prop Guards | 2 | 39
Customer Payload (1lb) | 0 | 453.59 | $0.00
Total | 7 | 471 | $126.30
 |  |  |  | 123
quad | 330

Sheet: Propulsion
Propulsion | QTY | Mass [g] | Cost [$] | Thrust [g] |  | Power [mW] |  |  | Voltage [V] |  |  | Current [mA] |  |  | link(s)
 |  |  |  | nom | max | Min | Typical | Max | Min | Typical | Max | Min | Typical | Max
SunnySky V2216-12 | 4 | 68.7 |  |  | 1200 |  |  |  |  | 14.8 |  |  | 4730.88843 | 20000 | http://www.dji.com/product/e300/spec
20 A ESC | 4 | 28.4
DJI 9443 Propellors | 4 | 11.1
Total | 12 | 432.8 | 0 | 0 | 4800 | 0 | 0 | 0 | 0 | 14.8 | 0 | 0 | 18923.55372 | 80000
 |  |  |  |  |  |  | 280068.5951 | 1184000
 |  |  |  |  |  |  | 70017.14876 |  |  |  |  | I = | aT^2+bT+c | based off thrust values
 |  |  |  |  |  |  |  |  |  |  |  | a | 4.718e-06
 |  |  |  |  |  |  |  |  |  |  |  | b | 0.008504
 |  |  |  |  |  |  |  |  |  |  |  | c | -1.947284
 |  |  |  |  |  |  |  |  |  |  |  | 4730.75

Sheet: TOTAL
 | QTY | Mass [g] | Cost [$]
Electronics Total | 7 | 645.65 | $645.65
Propulsion Total | 12 | 432.8 | $0.00
Dead Mass Total | 7 | 471 | $432.80 | Nom Thrust Avail [g] | Max Thrust Avail [g] | Ideal Thrust Needed [g] | Battery Cap [mAh] | Typ Power [mW] | Max Current [mA] | Typ Current [mA] | Est Typ Flt Time [min] | Est Max Flt Time [min]
Battery Total | 1 | 815.8 | $0.00
Overall Total | 27 | 2365.25 | $1078.45 | 0 | 4800 | 4730.5 | 8000 | 17650 | 85164.38 | 24087.94 | 19.92698755 | 5.636159007
 |  |  |  |  | per motor | 1182.625 | *80% of total used
 |  |  |  |  | for hover | 591.3125
