dtbinh/FlyNet/Technical/Hardware/purchase_list_2.xlsx

Part | Price | Quantity | Link
Guidance | $800.00 | 1 | http://store.dji.com/product/guidance
FLiR Camera Sensor | $260.00 | 1 | https://www.sparkfun.com/products/13233
XU4 Shifter Shield | $18.00 | 1 | http://www.hardkernel.com/main/products/prdt_info.php?g_code=G143556253995
ODROID USB-CAM | $17.00 | 1 | http://www.hardkernel.com/main/products/prdt_info.php?g_code=G137517754892
Propellers for Aliencopter Bee (your call on choice) | Depends | 5 sets | http://store.dji.com/product/e300-9443-carbon-fiber-yellow?from=related_products | or | http://www.hobbyking.com/hobbyking/store/__55442__Multirotor_Carbon_Fiber_DJI_Self_Tightening_9_4x4_3_CW_CCW_2pcs_.html
HDMI Cable | $5.50 | 1 | http://www.amazon.com/AmazonBasics-High-Speed-HDMI-Cable-Supports/dp/B003L1ZYYM?s=aht
