dtbinh/FlyNet/Technical/Hardware/purchase_list.xlsx

Hardware Name | Justification | Price per unit | Weight (g) | Quantity | Total Cost | URL
NVIDIA Jetson Dev Board | Onboard Processing | $190.49 | 145 | 1 | $190.49 | http://www.newegg.com/Product/Product.aspx?Item=N82E16813190005
ASUS Xtion Pro Live | Navigation/Perception/Mapping | $170 | 220 | 1 | $170.00 | http://www.newegg.com/Product/Product.aspx?Item=N82E16826785030
Laser Range Finder | Altimeter/Obstacle avoidance prototyping | $114.95 | 22 | 1 | $114.95 | https://www.sparkfun.com/products/13680
Ultrasonic Range Finder (wide beam) | Obstacle avoidance prototyping | $49.95 | 10-20(?) | 1 | $49.95 | https://www.sparkfun.com/products/9491
Ultrasonic Range Finder (narrow beam) | Obstacle avoidance prototyping | $49.95 | 10-20(?) | 1 | $49.95 | https://www.sparkfun.com/products/9495
Teensy board | Range finder computer interfacing | $19.95 | 10-30(?) | 2 | $39.90 | https://www.sparkfun.com/products/12646
ODROID XU4 | Controls processing | $75.00 | 30 | 1 | $75.00 | http://www.hardkernel.com/main/products/prdt_info.php?g_code=G143452239825
Headers | Prototyping | $1.50 |  | 5 | $7.50 | https://www.sparkfun.com/products/116
Breadboard | Prototyping | $5.95 |  | 1 | $5.95 | https://www.sparkfun.com/products/12615
Jumpers | Prototyping | $3.95 |  | 1 | $3.95 | https://www.sparkfun.com/products/9140
Wire Kit | Prototyping | $6.95 |  | 1 | $6.95 | https://www.sparkfun.com/products/124
 |  |  |  | Total | $714.59
