dtbinh/FlyNet/Presentations/Mid Semester Review/Individual_Slides/Tyler/PowerMassBOM3_ABee.xlsx

Sheet: Battery
** Voltage is automatically calculated based on the number of cells in the LiPo (3.7V per cell)
Battery | QTY | Mass [g] | Cost [$] | # Cells | Capacity [mAh] | Voltage [V] | Discharge Rate | Length [mm] | Width [mm] | Thickness [mm] | link(s)
Turnigy Nano-Tech LiPo Battery | 1 | 482.7 |  | 4 | 4500 | 14.8 | 20
Total | 1 | 482.7 | $0.00 | 4 | 4500 | 14.8 | 20

Sheet: Electronics
** Propulsion System is not included in this section, see "Propulsion" Worksheet
Electronics | QTY | Mass [g] | Cost [$] | Power [mW] |  |  | Voltage [V] |  |  | Current [mA] |  |  | link(s)
 |  |  |  | Min | Typical | Max | Min | Typical | Max | Min | Typical | Max
Jetson TK1 | 0 | 143.9 | $192.00 | 3470 | 4000 | 12490 | 9.5 |  | 13.5 | 365.2631579 | 333.3333333 | 1040.833333 | http://developer.download.nvidia.com/embedded/jetson/TK1/docs/Jetson_platform_brief_May2014.pdf http://elinux.org/Jetson/Jetson_TK1_Power
Odroid XU4 | 0 | 64.2 |  |  | 4000 |  |  | 5 |  |  | 800 |  | http://www.hardkernel.com/main/products/prdt_info.php?g_code=G143452239825&tab_idx=1
3DR Radio | 1 | 26.2 |  |  | 330 |  |  | 3.3 |  |  | 100 |  | https://store.3drobotics.com/products/3dr-radio-set
Guidance | 0 | 291 |  |  | 12000 | 12000 | 11.1 |  | 25 |  | 540.5405405
ASUS Xtion Pro Live | 0 | 115 |  |  | 2500 | 2500 |  | 5 | 5 |  | 500 | 500
Pixhawk | 1 | 40.3 |  |  | 1500 |  |  | 8 |  |  | 175 |  | http://diydrones.com/profiles/blogs/pixhawk-and-apm-power-consumption
LIDAR-Lite v2 | 0 | 28.1 | $114.95 |  | 550 |  | 4.75 | 5.5 | 6 | 2 | 100 | 100
FLIR Lepton LWIR Camera | 0 | 0.55 | $259.95 | 4 | 150 |  | 2.5 | 2.8 | 3.1 |  | 53.57142857
Windows Lifecam Studio Camera | 0 | 128 | $69.99 |  | 2500 | 2500 |  | 5 | 5 |  | 500 | 500
Total | 2 | 66.5 | $0.00 | 3474 | 1830 | 0 | 27.85 | 34.6 | 57.6 | 367.2631579 | 275 | 2140.833333
 | SunnySky V2216-12 KV800 II
 | http://www.buddyrc.com/sunnysky-v2216-12-800kv-ii-brushless-motor.html

Sheet: Dead Mass
** Dead Mass includes any structures, payloads, or other added mass that is not part of the propulsion system, electronics, or batteries
Dead Mass | QTY | Mass [g] | Cost [$] | Length [mm] | Width [mm] | Thickness [mm] | link(s)
ALIEN BEE Quad Structure | 1 | 712.3 | $126.30 |  |  |  | http://www.hobbyking.com/hobbyking/store/__61487__AlienCopter_Bee_full_Carbon_KIT_W_Clean_and_Dirty_System_and_PDB_W_BEC.html
VICON IR Orbs | 0 | 11.2
Landing Gear | 4 | 22.5
Prop Guards | 4 | 39
Customer Payload (1lb) | 1.5 | 453.59 | $0.00
Total | 10.5 | 1638.685 | $126.30

Sheet: Propulsion
Propulsion | QTY | Mass [g] | Cost [$] | Thrust [g] |  | Power [mW] |  |  | Voltage [V] |  |  | Current [mA] |  |  | link(s)
 |  |  |  | nom | max | Min | Typical | Max | Min | Typical | Max | Min | Typical | Max
E300 ESC + DJI 2212 Motor | 0 | 0 |  | 300 | 600 |  |  |  | 9.5 |  | 13.5 |  | 6.891321725 | 15000 | http://www.dji.com/product/e300/spec
DJI 9443 Propellors | 4 | 12
Total | 4 | 48 | 0 | 1200 | 2400 | 0 | 0 | 0 | 9.5 | 0 | 13.5 | 0 | 27565.2869 | 60000

Sheet: TOTAL
 | QTY | Mass [g] | Cost [$]
Electronics Total | 2 | 66.5 | $66.50
Propulsion Total | 4 | 48 | $0.00
Dead Mass Total | 10.5 | 1638.685 | $48.00 | Nom Thrust Avail [g] | Max Thrust Avail [g] | Ideal Thrust Needed [g] | Battery Cap [mAh] | Typ Power [mW] | Max Current [mA] | Typ Current [mA] | Est Typ Flt Time [min] | Est Max Flt Time [min]
Battery Total | 1 | 482.7 | $0.00
Overall Total | 17.5 | 2235.885 | $114.50 | 1200 | 2400 | 4471.77 | 4500 | 1830 | 60275.00 | 27840.29 | 9.69817592 | 4.4794691
 |  |  |  |  |  | 1117.9425
