dtbinh/FlyNet/Presentations/Mid Semester Review/Individual_Slides/Tyler/PowerMassBOM3_M100.xlsx

Sheet: Battery
** Voltage is automatically calculated based on the number of cells in the LiPo (3.7V per cell)
Battery | QTY | Mass [g] | Cost [$] | # Cells | Capacity [mAh] | Voltage [V] | Discharge Rate | Length [mm] | Width [mm] | Thickness [mm] | link(s)
Intelligent Flight Battery TB47D | 1 | 600 |  | 6 | 4500 | 22.2
Total | 1 | 600 | $0.00 | 6 | 4500 | 22.2 | 0

Sheet: Electronics
** Propulsion System is not included in this section, see "Propulsion" Worksheet
Electronics | QTY | Mass [g] | Cost [$] | Power [mW] |  |  | Voltage [V] |  |  | Current [mA] |  |  | link(s)
 |  |  |  | Min | Typical | Max | Min | Typical | Max | Min | Typical | Max
Jetson TK1 | 0 | 143.9 | $192.00 | 3470 | 4000 | 12490 | 9.5 | 12 | 13.5 | 365.2631579 | 333.3333333 | 1040.833333 | http://developer.download.nvidia.com/embedded/jetson/TK1/docs/Jetson_platform_brief_May2014.pdf http://elinux.org/Jetson/Jetson_TK1_Power
Odroid XU4 | 1 | 64.2 |  |  | 4000 |  |  | 5 |  |  | 800 |  | http://www.hardkernel.com/main/products/prdt_info.php?g_code=G143452239825&tab_idx=1
FLIR Lepton LWIR Camera | 1 | 0.55 | $259.95 | 4 | 150 |  | 2.5 | 2.8 | 3.1 |  | 53.57142857 |  | https://www.sparkfun.com/products/13233
Guidance | 1 | 291 |  |  | 12000 | 12000 | 11.1 | 22.2 | 25 | 540.5405405 | 540.5405405 | 540.5405405 | https://developer.dji.com/guidance/specs/
Total | 3 | 355.20 | $0.00 | 0 | 16150 | 12000 |  |  |  | 540.5405405 | 1394.111969 | 540.5405405
 |  |  |  |  |  |  |  |  |  | *based on typ volt values

Sheet: Dead Mass
** Dead Mass includes any structures, payloads, or other added mass that is not part of the propulsion system, electronics, or batteries
Dead Mass | QTY | Mass [g] | Cost [$] | Length [mm] | Width [mm] | Thickness [mm] | link(s)
DJI Matrice 100 | 1 | 1083 | $3200.00 |  |  |  | http://developer.dji.com/matrice-100/specs/
VICON IR Orbs | 5 | 11.2 | $0.00
Customer Payload (1lb) | 1 | 453.59 | $0.00
Total | 7 | 1592.59 | $3200.00

Sheet: Propulsion
Propulsion | QTY | Mass [g] | Cost [$] | Thrust [g] |  | Power [mW] |  |  | Voltage [V] |  |  | Current [mA] |  |  | Length [mm] | Width [mm] | Thickness [mm] | link(s)
 |  |  |  | nom | max | Min | Typical | Max | Min | Typical | Max | Min | Typical | Max
DJI E 620D ESC (E800) | 4 | 43 |  |  |  |  |  |  |  |  |  | 0 | 5.13461504 | 20000
DJI 1345s Propellor (E800) | 4 | 19
DJI 3510 Motor (E800) | 4 | 106 |  | 800 | 2100 |  |  |  |  |  | 26
Total | 12 | 672 | $0.00 | 3200 | 8400 | 0 | 0 | 0 | 0 | 0 | 26 | 0 | 20538.46016 | 80000
 |  |  |  |  |  |  |  |  |  |  |  | * Typical is for hover values

Sheet: TOTAL
 | QTY | Mass [g] | Cost [$]
Electronics Total | 3 | 355.2 | $355.20
Propulsion Total | 12 | 672 | $0.00
Dead Mass Total | 7 | 1592.59 | $3200.00 | Nom Thrust Avail [g] | Max Thrust Avail [g] | Ideal Thrust Needed [g] | Battery Cap [mAh] | Typ Power [mW] | Max Current [mA] | Typ Current [mA] | Est Typ Flt Time [min] | Est Max Flt Time [min]
Battery Total | 1 | 600 | $0.00
Overall Total | 23 | 3219.79 | $3555.20 | 3200 | 8400 | 6439.58 | 4500 | 16150 | 81394.11 | 21932.57 | 12.31045763 | 3.317193265

Sheet: M100 Setup
Item | Qty | Weight [g] | Power [mW] | Current [mA]
M100 Quad System | 1 | 2355 |  |  | *includes motors/battery/flight controller/props
Guidance | 1 | 118.6
 | Nom Thrust | Max Thrust [g/motor] | Current [A] |  | Total Current Motors | Total Thrust Nom | Max Thrust | Necessary Thrust
Motor | 800 | 2100 | 20 |  | 80 | 3200 | 8400 | 4947.2
 | Capacity [mAh] | Discharge Rate
6S Battery | 4500
 | 0.1956521739
 | 11.73913043
 |  | http://multicopter.forestblue.nl/lipo_need_calculator.html
