dtbinh/FlyNet/Presentations/Mid Semester Review/Individual_Slides/Tyler/PowerMassBOM3.xlsx

Sheet: Battery
** Voltage is automatically calculated based on the number of cells in the LiPo (3.7V per cell)
Battery | QTY | Mass [g] | Cost [$] | # Cells | Capacity [mAh] | Voltage [V] | Discharge Rate | Length [mm] | Width [mm] | Thickness [mm] | link(s)
Turnigy Nano-Tech LiPo Battery | 0 | 482.7 |  | 4 | 4500 | 14.8 | 20
Intelligent Flight Battery TB47D | 1 | 600 |  | 6 | 4500 | 22.2
Total | 0 | 600 | $0.00 | 6 | 4500 | 22.2 | 20

Sheet: Electronics
** Propulsion System is not included in this section, see "Propulsion" Worksheet
Electronics | QTY | Mass [g] | Cost [$] | Power [mW] |  |  | Voltage [V] |  |  | Current [mA] |  |  | Length [mm] | Width [mm] | Thickness [mm] | link(s)
 |  |  |  | Min | Typical | Max | Min | Typical | Max | Min | Typical | Max
Jetson TK1 | 0 | 143.9 | $192.00 | 3470 | 4000 | 12490 | 9.5 |  | 13.5 |  |  |  | 127 | 127 |  | http://developer.download.nvidia.com/embedded/jetson/TK1/docs/Jetson_platform_brief_May2014.pdf http://elinux.org/Jetson/Jetson_TK1_Power
Odroid XU4 | 1 | 64.2 |  |  | 4000 |  |  | 5 |  |  |  |  |  |  |  | http://www.hardkernel.com/main/products/prdt_info.php?g_code=G143452239825&tab_idx=1
3DR Radio | 1 | 26.2 |  |  |  |  |  |  |  |  | 100 |  |  |  |  | https://store.3drobotics.com/products/3dr-radio-set
Guidance | 1 | 118.6 |  |  | 12000 | 12000 | 11.1 |  | 25
ASUS Xtion Pro Live | 0 | 115 |  |  |  | 2500
Pixhawk | 1 | 40.3 |  |  |  |  |  |  |  |  | 175 |  | 81.5 | 50 | 15.5 | http://diydrones.com/profiles/blogs/pixhawk-and-apm-power-consumption
LIDAR-Lite v2 | 0 | 28.1 | $114.95 |  |  |  | 4.75 | 5.5 | 6 | 2 | 100 | 100
4 Port Plugable USB Hub | 0 | 32.4
XL Max Sonar EZ/AE | 0 | 6.7 | $25.95 |  |  |  | 3 |  | 5 | 2 |  | 3
Total | 4 | 575.4 | $332.90 | 3470 | 20000 | 26990 | 28.35 | 10.5 | 49.5 | 4 | 375 | 103

Sheet: Dead Mass
** Dead Mass includes any structures, payloads, or other added mass that is not part of the propulsion system, electronics, or batteries
Dead Mass | QTY | Mass [g] | Cost [$] | Length [mm] | Width [mm] | Thickness [mm] | link(s)
ALIEN BEE Quad Structure | 0 | 712.3 | $126.30 |  |  |  | http://www.hobbyking.com/hobbyking/store/__61487__AlienCopter_Bee_full_Carbon_KIT_W_Clean_and_Dirty_System_and_PDB_W_BEC.html
DJI Matrice 100 | 1 | 2355 |  |  |  |  | http://developer.dji.com/matrice-100/specs/
VICON IR Orbs | 5 | 11.2
Landing Gear | 0
Prop Guards | 0
Customer Payload (1lb) | 1 | 453.59 | $0.00
Total | 7 | 3532.09 | $126.30

Sheet: Propulsion
Propulsion | QTY | Mass [g] | Cost [$] | Thrust [g] |  | Power [mW] |  |  | Voltage [V] |  |  | Current [mA] |  |  | Length [mm] | Width [mm] | Thickness [mm] | link(s)
 |  |  |  | nom | max | Min | Typical | Max | Min | Typical | Max | Min | Typical | Max
E300 ESC + DJI 2212 Motor | 0 | 0 |  | 300 | 600 | 3470 | 4000 | 12490 | 9.5 |  | 13.5 |  | 20000 |  |  |  |  | http://www.dji.com/product/e300/spec
DJI E 620D ESC (E800) | 4 | 43
DJI 1345s | 4 | 19
DJI 3510 Motor (E800) | 4 | 106 |  | 800 | 2100 |  |  |  |  |  | 26 |  |  | 20000
DJI 9443 Propellors | 0 | 12
Total | 12 | 180 | 0 | 1100 | 2700 | 3470 | 4000 | 12490 | 9.5 | 0 | 39.5 | 0 | 20000 | 20000

Sheet: TOTAL
 | QTY | Mass [g] | Cost [$]
Electronics Total | 4 | 575.4 | $575.40
Propulsion Total | 12 | 180 | $0.00
Dead Mass Total | 7 | 3532.09 | $180.00 | Thrust Available | Thrust Needed | Min Power [mW] | Typ Power [mW] | Max Power [mW] | Est Min Flt Time [min] | Est Max Flt Time [min]
Battery Total | 0 | 600 | $0.00
Overall Total | 23 | 4887.49 | $755.40 |  | 9774.98 | 6940 | 24000 | 39480

Sheet: M100 Setup
Item | Qty | Weight [g] | Power [mW] | Current [mA]
M100 Quad System | 1 | 2355 |  |  | *includes motors/battery/flight controller/props
Guidance | 1 | 118.6
 | Nom Thrust | Max Thrust [g/motor] | Current [A] |  | Total Current Motors | Total Thrust Nom | Max Thrust | Necessary Thrust
Motor | 800 | 2100 | 20 |  | 80 | 3200 | 8400 | 4947.2
 | Capacity [mAh] | Discharge Rate
6S Battery | 4500
 | 0.1956521739
 | 11.73913043
 |  | http://multicopter.forestblue.nl/lipo_need_calculator.html
