dtbinh/FlyNet/Technical/Hardware/sensor_comparison.xlsx

Sensor | Size | Weight | Power | Included Sensors | Min Range | Max Range | Field of View | Lighting Dependent Performance | Out of box features | Link
Guidance | 7in x 7in x 2in | 291 g | 12 W | 5 x Stereo Cameras | 0.2 m | 20 m | 360 deg az, 180 deg el | Requires external lighting for stereo cameras | FPGA accelerated estimates of visual odometry, nearest obstacles @ 10 Hz, IMU and raw images at 20 Hz | https://developer.dji.com/guidance/specs/
 |  |  |  | 5 Ultrasonic RFs
ASUS Xtion RGBD | 18in x 3.5in x 5in | 220 g | 2.5 W | RGBD Sensor | 0.5 m | 3.5 m | 58 deg az, 45 deg el | Feature extraction fails in no light conditions. Depth sensor still works | RGBD raw images at 30 Hz | https://www.asus.com/us/Multimedia/Xtion_PRO_LIVE/specifications/
 |  |  |  |  |  |  |  | (Both fail to perform visual odometry in no light conditions, SLAM also fails)
