dtbinh/FlyNet/Minutes/Minutes_Order.txt

Order of Minute Taking as Calculated from Python Script:

Taylor
Austin
Drew 
Matt
Tyler
Prashant
Steve
Bryce
