dtbinh/FlyNet/Technical/Testing/TestPlan.xlsx

 |  |  |  |  |  |  | Now - February 29 |  |  | March 1 - End of Semester
Progress | Test | Requirement Verification | Pass/Fail Criteria | Min People Required | To Be Completed by |  | Component Level | Integration |  | Subsystem | Integration |  | Full System
0% | End of Semester Test Demo | All Level 1 Requirements | End of Year Test | 2 | 2016-02-01 | 75% | Initial Camera Test |  | 51.25% | Guidance Subsystem |  | 72.45% | Project
25% | Tracking/ID Subsystem | 1.1, 2.1, 2.2, 8.2, 8.3, 8.4, 4.2.1 | Test full Tracking Subsystem | 3 | 2016-02-22 | 50% | Target Imaging
25% | Guidance Subsystem | 1.2, 5.2, 7.2, 4.2.1 | Test full Guidance Subsystem | 3 | 2016-02-15 | 50% | Obstacle Perceived
50% | Planning Subsystem | 1.2, 5.2, 5.3 | Test full Planning Subsystem | 3 | 2016-02-29 | 50% | Obstacle Map
50% | Controls Subsystem | 1.2, | Test full Controls Subsystem | 2 | 2016-02-08 | 75% | Visual Odometry Verification and Characterization
75% | Hardware Subsystem | 5.1, 8.1 | Test full Hardware Subsystem
75% | Initial Camera Test | 1.1.1,1.1.2, 4.1.2 | Record images, load into processing software on the quad | 1 | 2016-02-01 | 100% | Human Target Probability of Detection |  | 72.25% | Tracking/ID Subsystem
50% | Target Imaging | 1.1.3 | Correctly locate targets in the map 95% of time with 0.5 m accuracy | 2 | 2016-02-15 | 90% | Target Estimation Accuracy
100% | Human Target Probability of Detection | 1.1.3, 1.1.4, 8.3.1, 8.3.2 | Identify human target 95% of the time | 2 | 2016-02-08 | 100% | Multiple Targets Tracking
75% | Collision Correction Planning | 1.2.1 | Send system on collision course, verify avoidance | 3 | 2016-02-22 | 75% | Target Estimate Update Frequency
100% | Trajectory Test Planning | 1.2.2, 5.2, 4.1.1 | Give trajectory to desired position, verify accuracy with VICON | 3 | 2016-02-29 | 75% | Target Accuracy and Range
75% | Obstacle Avoidance Planning | 1.2.4 | Maintain a distance of 5 cm from obstacles, verify with VICON
85% | Durataion | 1.3.1, 1.3.2 | Endurance test, while searching, full payload. Measure Distance traveled as well | 2 | 2016-02-15 | 75% | Collision Correction Planning |  | 80% | Planning Subsystem
90% | Target Estimation Accuracy | 2.1.1 | Estimate position to withing 0.5 meters | 2 | 2016-02-01 | 100% | Trajectory Test Planning
100% | Multiple Targets Tracking | 2.1.2 | Multiple targets tracked simultaneously | 2 | 2016-02-08 | 75% | Obstacle Avoidance Planning
75% | Target Estimate Update Frequency | 2.1.3, 2.2.1 | Target position update should occur at 10Hz | 2 | 2016-02-22 | 100% | Receive and Transmit Test
100% | Autonomous Takeoff & Landing | 3.1.1, 3.1.2, 3.1.3 | Self Explainitory | 2 | 2016-02-29 | 100% | Communications
85% | Payload | 1.3.1, 4.3.1, 5.1.1 | Self Explainitory
100% | Receive & Transmit Test | 7.1.1, 7.1.2 | Send and receive data packets | 4 | 2016-02-29 | 75% | Collision Correction Controls |  | 76.25% | Controls Subsystem
50% | Obstacle Perceived | 7.2.1, 7.2.2 | Report obtacle locations, verify with VICON | 4 | 2016-02-15 | 90% | Trajectory Test Controls
50% | Obstacle Map | 7.3.1 | Obstacle Map maintained | 4 | 2016-02-22 | 75% | Obstacle Avoidance Controls
100% | Communications | 7.3.2, 7.4.1 | Communicate Obstacle Maps and Confirmed target tracks | 3 | 2016-02-08 | 100% | Autonomous Takeoff & Landing
75% | Target Accuracy and Range | 1.1.3, 1.1.4, 8.3.1, 8.3.2 | Detect targets with 0.5m accuracy, find the maximum distance
75% | Visual Odometry Verification and Characterization | 1.2, 1.1 | SLAM accuracy and positioning at minimum speed | 2 | 2016-02-01 | 85% | Durataion |  | 82.5% | Hardware Subsystem
50% | Collision Correction Controls | 1.2.1 | Send system on collision course, verify avoidance | 2 | 2016-02-01 | 85% | Payload
90% | Trajectory Test Controls | 1.2.3, 4.4.1 | Verify the trajectory accuracy against VICON
75% | Obstacle Avoidance Controls | 1.2.4 | Maintain a distance of 5 cm from obstacles, verify with VICON
