dtbinh/FlyNet/Technical/Testing/SolidWorks/WoodFrame.SLDASM

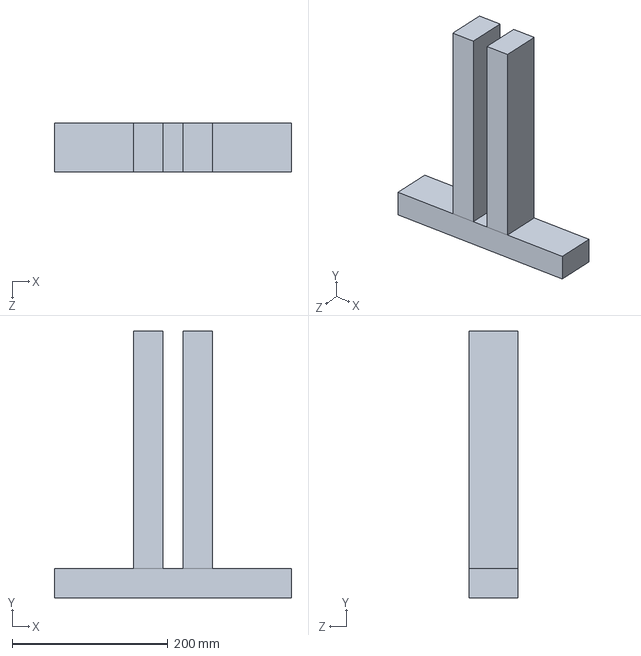
[picture p163: CAD file, 2015-12-05]
Technical/Testing/SolidWorks/WoodFrame.SLDASM
304.8 x 342.9 x 63.5 mm
2x3 x 3
