dtbinh/FlyNet/Technical/Testing/SolidWorks/Demo.SLDASM

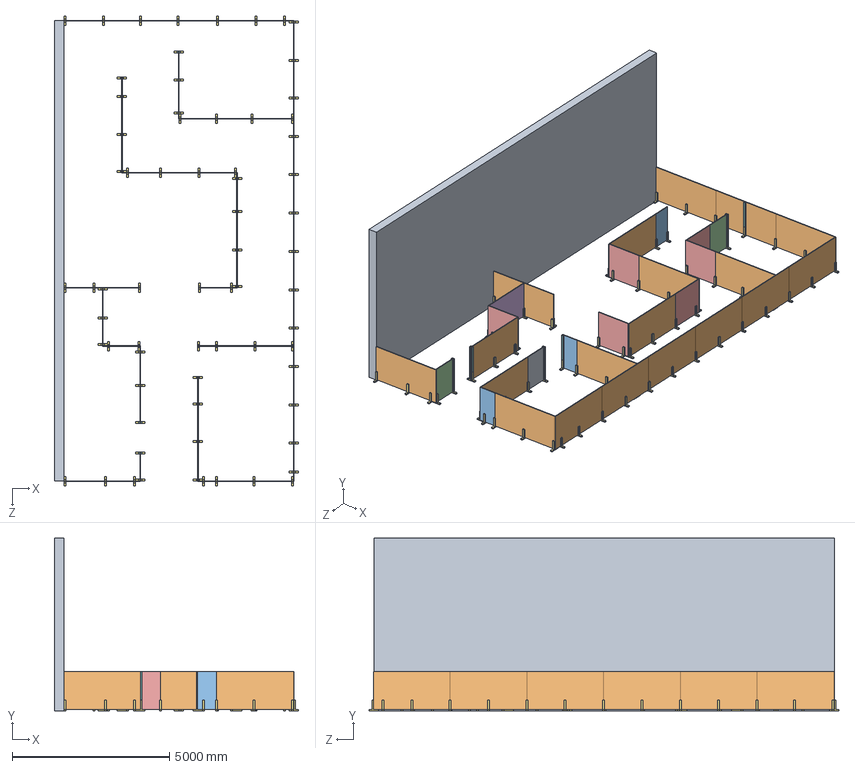
[picture p164: CAD file, 2015-12-05]
Technical/Testing/SolidWorks/Demo.SLDASM
7759.7 x 5486.4 x 14935.2 mm
Wall
4x8Foam x 19
4x2Foam x 3
4x1.5Foam x 2
4x4Foam x 6
4x6Foam
2x3 x 207
DoorFrame x 10
SpecialPiece
