dtbinh/FlyNet/Technical/Testing/SolidWorks/MiniDemo.SLDASM

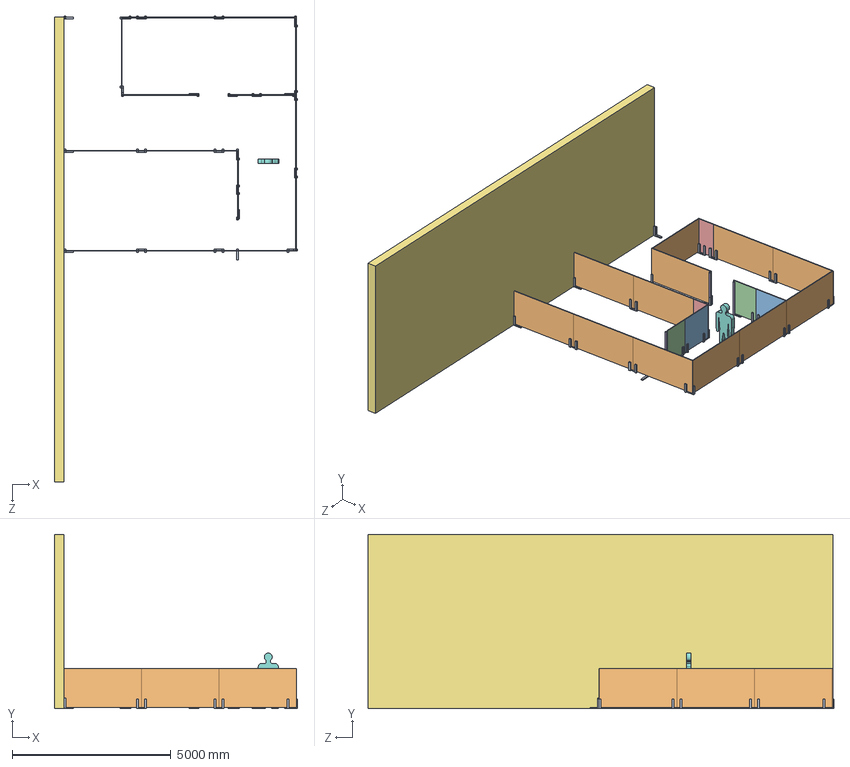
[picture p165: CAD file, 2015-12-05]
Technical/Testing/SolidWorks/MiniDemo.SLDASM
7658.1 x 5486.4 x 14668.5 mm
2x3 x 97
4x8Foam x 12
4x4Foam x 2
4x1.5Foam x 2
4x2Foam x 2
DoorFrame x 4
Wall
Human
