dtbinh/FlyNet/Technical/Testing/SolidWorks/Wall.SLDPRT

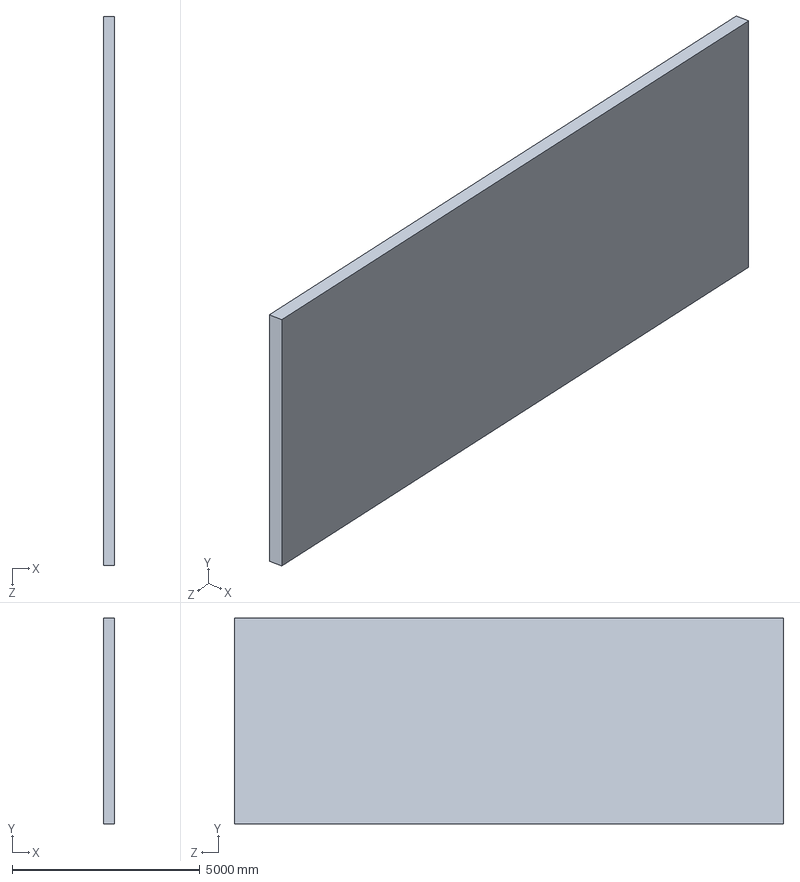
[picture p166: CAD file, 2015-12-05]
Technical/Testing/SolidWorks/Wall.SLDPRT
304.8 x 5486.4 x 14630.4 mm
