dtbinh/FlyNet/Technical/Testing/SolidWorks/4x2Foam.SLDPRT

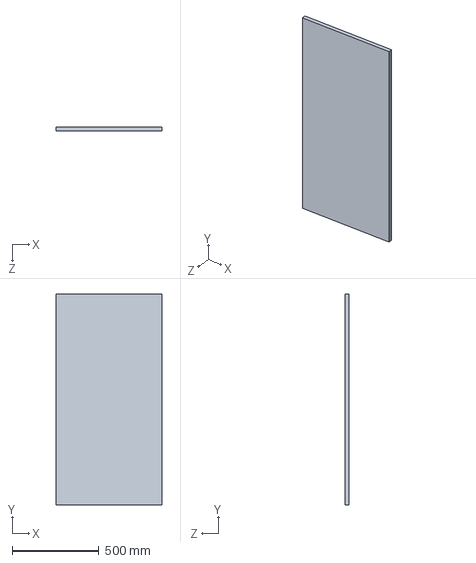
[picture p167: CAD file, 2015-12-05]
Technical/Testing/SolidWorks/4x2Foam.SLDPRT
609.6 x 1219.2 x 25.4 mm
