dtbinh/FlyNet/Technical/Testing/SolidWorks/4x1.5Foam.SLDPRT

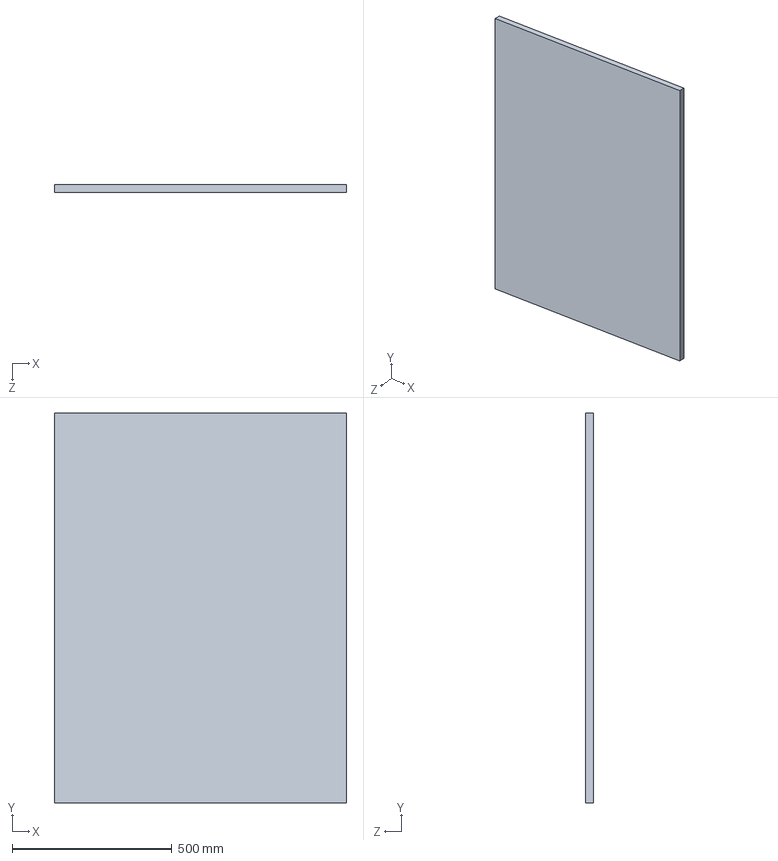
[picture p168: CAD file, 2015-12-05]
Technical/Testing/SolidWorks/4x1.5Foam.SLDPRT
914.4 x 1219.2 x 25.4 mm
