dtbinh/FlyNet/Technical/Testing/SolidWorks/4x6Foam.SLDPRT

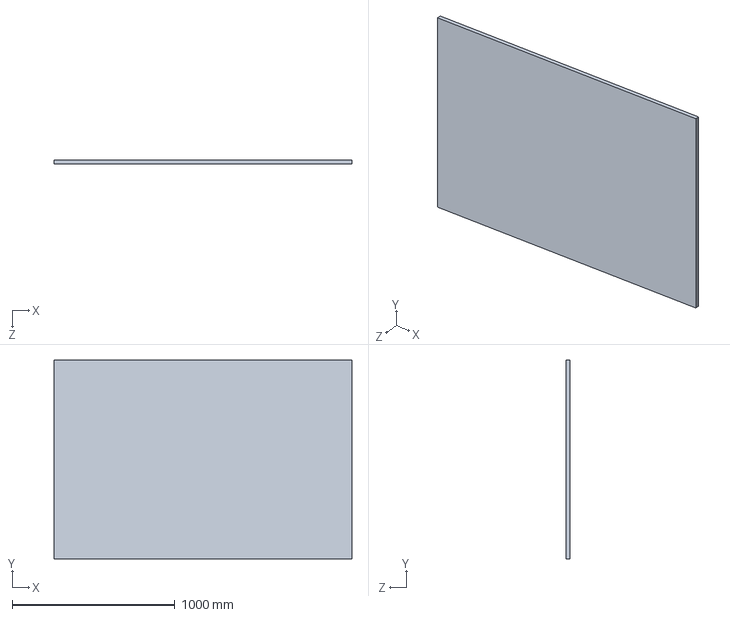
[picture p169: CAD file, 2015-12-05]
Technical/Testing/SolidWorks/4x6Foam.SLDPRT
1828.8 x 1219.2 x 25.4 mm
