dtbinh/FlyNet/Technical/Testing/SolidWorks/SpecialPiece.SLDPRT

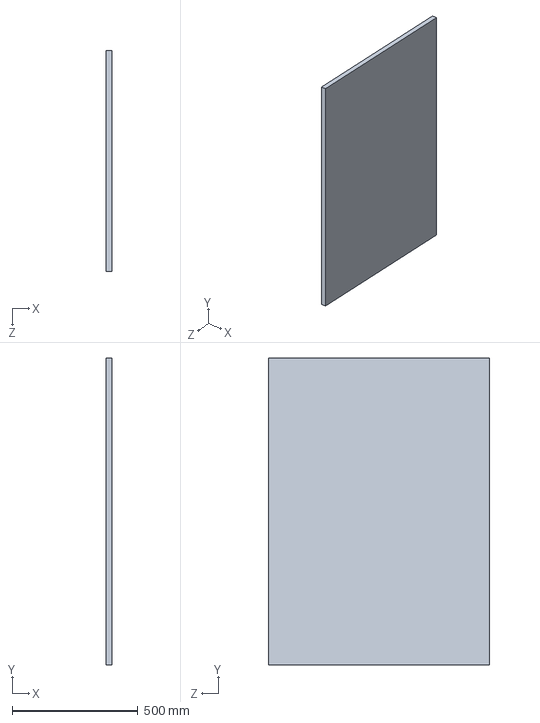
[picture p170: CAD file, 2015-12-05]
Technical/Testing/SolidWorks/SpecialPiece.SLDPRT
25.4 x 1219.2 x 876.3 mm
