dtbinh/FlyNet/Technical/Testing/SolidWorks/Human.SLDPRT

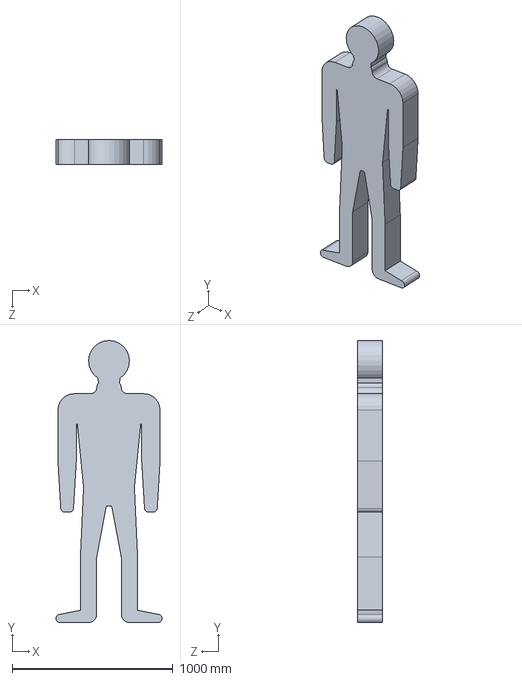
[picture p171: CAD file, 2015-12-05]
Technical/Testing/SolidWorks/Human.SLDPRT
660.4 x 1752.6 x 152.4 mm
