dtbinh/FlyNet/Technical/Testing/SolidWorks/4x4Foam.SLDPRT

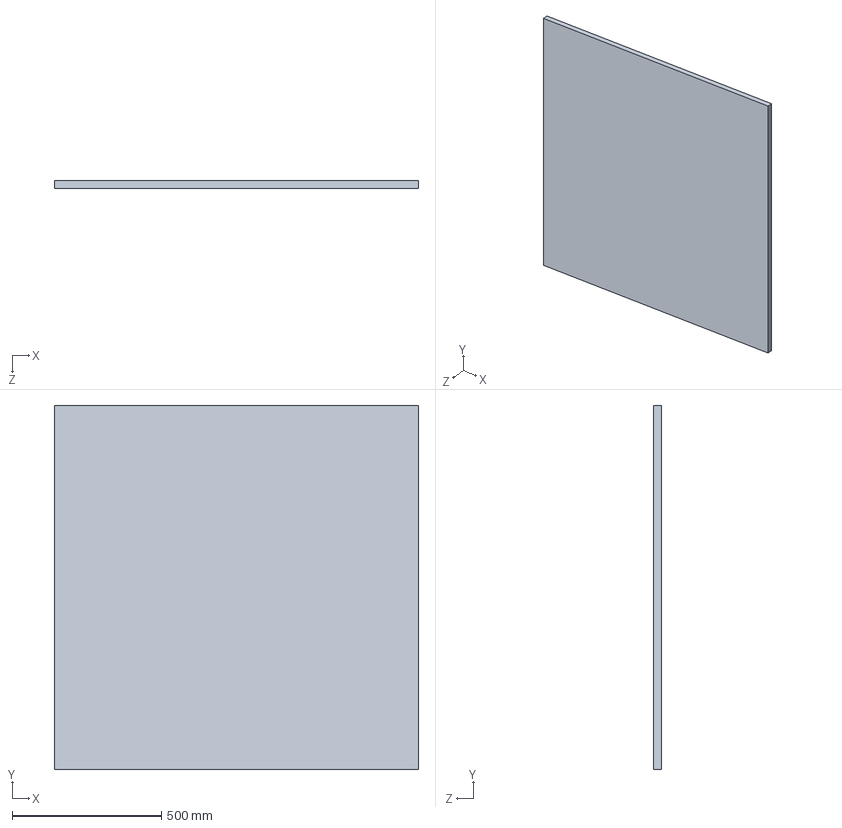
[picture p172: CAD file, 2015-12-05]
Technical/Testing/SolidWorks/4x4Foam.SLDPRT
1219.2 x 1219.2 x 25.4 mm
