dtbinh/FlyNet/Technical/Testing/SolidWorks/DoorFrame.SLDPRT

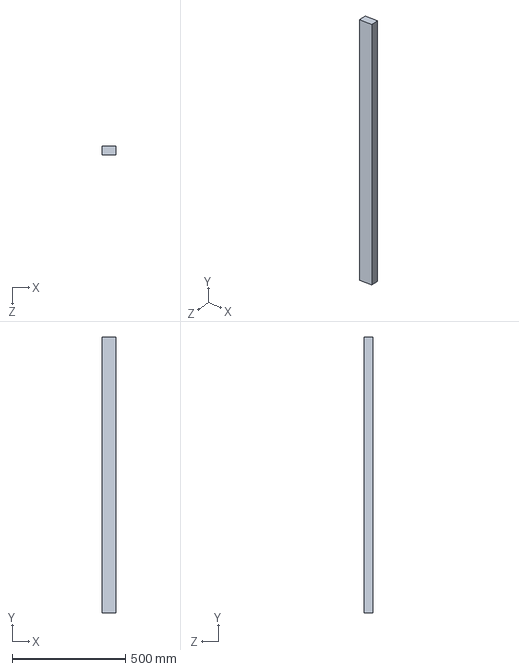
[picture p173: CAD file, 2015-12-05]
Technical/Testing/SolidWorks/DoorFrame.SLDPRT
63.5 x 1219.2 x 38.1 mm
