dtbinh/FlyNet/Technical/Testing/SolidWorks/2x3.SLDPRT

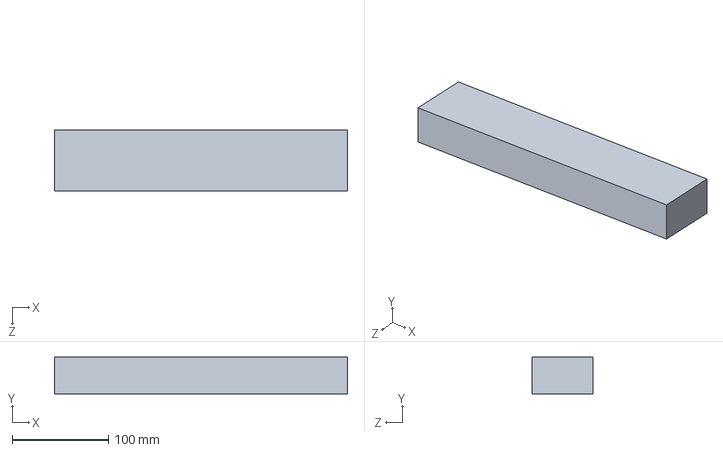
[picture p174: CAD file, 2015-12-05]
Technical/Testing/SolidWorks/2x3.SLDPRT
304.8 x 38.1 x 63.5 mm
