dtbinh/FlyNet/Technical/Testing/SolidWorks/4x8Foam.SLDPRT

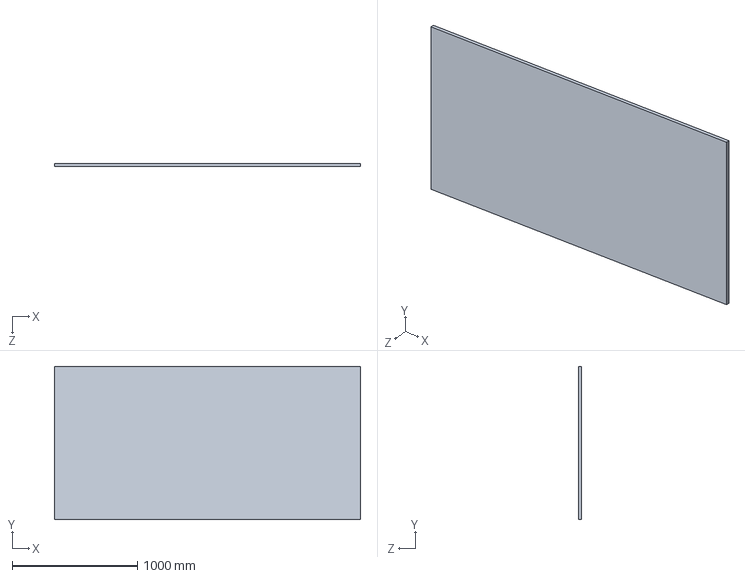
[picture p175: CAD file, 2015-12-05]
Technical/Testing/SolidWorks/4x8Foam.SLDPRT
2438.4 x 1219.2 x 25.4 mm
