dtbinh/FlyNet/Technical/Testing/TargetEstimateUpdate.docx

Test Objective/Description: Target Estimate Update

Location: Fleming Lab

Date:

Hardware Needed: FLiR sensor, Odroid, Laptop

Procedure:

Connect the FLiR Sensor to the Odroid and power it on.

Place a target at a measured distance from the camera.

Record images of the target continuously using the sensor

Check the update rate of the sensor image and the position estimate.

Requirements Met

2.2.1

Test Anomalies

Test Results:

Signature: ___________________________

Test Sheet FlyNet
