dtbinh/FlyNet/Technical/Testing/MultipleTargets.docx

Test Objective/Description: Multiple Targets

Location: Fleming Lab

Date:

Hardware Needed: FLiR Sensor, Odroid, Laptop

Procedure:

Connect the FLiR Sensor to the Odroid and power it on.

Position 3 people at different locations of the lab space.

Record an image using the FLiR camera.

Verify if the sensor can distinctly identify everybody in the room at their respective position.

Repeat test for varying distances between the target and the sensor.

Requirements Met

2.1.2

Test Anomalies

Test Results:

Signature: ___________________________

Test Sheet FlyNet
