dtbinh/FlyNet/Technical/Testing/Communications.docx

Test Objective/Description: Communications

Location: RECUV Lab

Date:

Hardware Needed: Quad, Ground station

Procedure:

Verify map initialization and end of mission transmission function properly

Requirements Met

7.3.2
7.4.1

Test Anomalies

Test Results:

Signature: ___________________________

Test Sheet FlyNet
