dtbinh/FlyNet/Technical/Testing/Receive&Transmit.docx

Test Objective/Description: Receive & Transmit Test

Location: RECUV Lab

Date:

Hardware Needed: Onboard computer, ground station

Procedure:

Verify that map initialization (from ground station or preloaded data) occurs properly

Verify that map is transmitted to ground station successfully at end of mission

Requirements Met

7.1.1
7.1.2

Test Anomalies

Test Results:

Signature: ___________________________

Test Sheet FlyNet
