dtbinh/FlyNet/Technical/scripts/test.csv

header:
  seq: 23031
  stamp:
    secs: 1449283565
    nsecs: 892917568
  frame_id: fcu
pose:
  position:
    x: 0.0484087988734
    y: 0.0115944277495
    z: 0.0460411049426
  orientation:
    x: -0.0116417590164
    y: -0.00795476709125
    z: -0.000857942909083
    w: 0.999900222553
---
header:
  seq: 23032
  stamp:
    secs: 1449283565
    nsecs: 929680704
  frame_id: fcu
pose:
  position:
    x: 0.0484023801982
    y: 0.0115801068023
    z: 0.0463926531374
  orientation:
    x: -0.0116341681972
    y: -0.00794175082908
    z: -0.000865698468827
    w: 0.999900407686
---
header:
  seq: 23033
  stamp:
    secs: 1449283565
    nsecs: 965680704
  frame_id: fcu
pose:
  position:
    x: 0.0483834706247
    y: 0.0115705626085
    z: 0.0480224713683
  orientation:
    x: -0.0116430490676
    y: -0.00793991283829
    z: -0.000866105110714
    w: 0.999900318559
---
header:
  seq: 23034
  stamp:
    secs: 1449283565
    nsecs: 990680704
  frame_id: fcu
pose:
  position:
    x: 0.0483650825918
    y: 0.0115653378889
    z: 0.0482982806861
  orientation:
    x: -0.0116440675586
    y: -0.00793827887698
    z: -0.000868309066843
    w: 0.999900317761
---
header:
  seq: 23035
  stamp:
    secs: 1449283566
    nsecs: 26308480
  frame_id: fcu
pose:
  position:
    x: 0.0483633168042
    y: 0.0115543268621
    z: 0.0477430857718
  orientation:
    x: -0.0116480493857
    y: -0.0079434366025
    z: -0.000868294542972
    w: 0.999900230436
---
header:
  seq: 23036
  stamp:
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
  frame_id: fcu
pose:
  position:
    x: 0.0484966635704
    y: 0.0115942358971
    z: 0.0497758425772
  orientation:
    x: -0.011806466942
    y: -0.0081992784949
    z: -0.00109419633831
    w: 0.999896085553
---
header:
  seq: 23266
  stamp:
    secs: 1449283574
    nsecs: 9411392
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
