dtbinh/FlyNet/Testing.txt

Testing....Testing....Testing!!

Can you see this matt???
