dtbinh/FlyNet/Technical/Testing/GuidanceSubsystem.docx

Test Objective/Description: Guidance Subsystem

Location:

Date:

Hardware Needed:

Procedure:

Requirements Met

1.2
5.2
7.2
4.2.1

Test Anomalies

Test Results:

Successfully integrated with Hardware subsystem

Signature: ___________________________

Test Sheet FlyNet
