dtbinh/FlyNet/Technical/Testing/PlanningSubsystem.docx

Test Objective/Description: Planning Subsystem

Location:

Date:

Hardware Needed:

Procedure:

Requirements Met

1.2
5.2
5.3

Test Anomalies

Test Results:

Integrated with controls via sending waypoints in text files.

Integrated with hardware subsystem.

Signature: ___________________________

Test Sheet FlyNet
