dtbinh/FlyNet/Technical/Testing/ControlsSubsystem.docx

Test Objective/Description: Controls Subsystem

Location: RECUV VICON Cage

Date: December 2015

Hardware Needed:

Procedure:

Requirements Met

1.2

Test Anomalies

Test Results:

Test flights were successful after integrating with Mechanical subsystem.

We were able to perform simple trajectories and nonzero yaw pointing.

Integrated with planning via passing text files of waypoints.

Signature: ___________________________

Test Sheet FlyNet
