dtbinh/FlyNet/Technical/Testing/TrackingIDSubsystem.docx

Test Objective/Description: Tracking ID Subsystem

Location:

Date:

Hardware Needed:

Procedure:

Requirements Met

1.1 | 8.3
2.1 | 8.4
2.2 | 4.2.1
8.2

Test Anomalies

Test Results:

Integrated with the ODRIOD via Ethernet.

Signature: ___________________________

Test Sheet FlyNet
