dtbinh/FlyNet/Technical/Testing/ObstacleAvoidancePlanning.docx

Test Objective/Description: Obstacle Avoidance

Location: RECUV Lab

Date:

Hardware Needed: Onboard computer, ground station

Procedure:

Run (On computer) path planning algorithm to generate a path

- Check that selected path is never too close (_cm) to an obstacle
- Identify doorways in path segments and send flags to controls

Upon successful completion on PC, run (on flight computer) path planning algorithm to generate a path

- Check that selected path is never too close (_cm) to an obstacle

Requirements Met

1.2.4

Test Anomalies

Test Results:

Signature: ___________________________

Test Sheet FlyNet
