dtbinh/FlyNet/Technical/Testing/CollisionCorrectionPlanning.docx

Test Objective/Description: Collision Correction

Location: Flemming Test Space

Date:

Hardware Needed: Onboard computer

Procedure:

Run (On computer) path planning algorithm to regenerate a path once obstacle information has been added to map

- Check that path traverses remainder (__%) of space
- Check that path eventually leads to target identification

Upon successful completion on PC, run (on flight computer) path planning algorithm to regenerate a path

- Check that path traverses remainder (__%) of space
- Check that path eventually leads to target identification

Requirements Met

1.2.1

Test Anomalies

Test Results:

Signature: ___________________________

Test Sheet FlyNet
