dtbinh/FlyNet/Technical/Testing/TestTemplate.docx

Test Objective/Description:

Location:

Date:

Hardware Needed:

Procedure:

Requirements Met

Test Anomalies/Proposed Reason or Solution

Test Results:

Signature: ___________________________

Test Sheet FlyNet
