dtbinh/FlyNet/Technical/Testing/CollisionCorrectionControls.docx

Test Objective/Description: Collision Correction

Location:

Date:

Hardware Needed:

Procedure:

Requirements Met

1.2.1

Test Anomalies

Test Results:

Signature: ___________________________

Test Sheet FlyNet
