dtbinh/FlyNet/Technical/Testing/DeliveryZone.docx

Test Objective/Description: Delivery Zone

Location:

Date:

Hardware Needed:

Procedure:

Requirements Met

5.2.1

Test Anomalies

Test Results:

Signature: ___________________________

Test Sheet FlyNet
