dtbinh/FlyNet/Technical/Testing/EndOfSemesterTestDemo.docx

Test Objective/Description: End of Semester Test Demo

Location: Fleming VICON Cage

Date:

Hardware Needed:

Procedure:

Requirements Met

All Level 1

Test Anomalies

Test Results:

Signature: ___________________________

Test Sheet FlyNet
