dtbinh/FlyNet/Technical/Testing/ObstacleAvoidanceControls.docx

Test Objective/Description: Obstacle Avoidance

Location:

Date:

Hardware Needed:

Procedure:

Requirements Met

1.2.4

Test Anomalies

Test Results:

Signature: ___________________________

Test Sheet FlyNet
