dtbinh/FlyNet/Technical/Testing/PayloadDelivery.docx

Test Objective/Description: Payload Delivery

Location:

Date:

Hardware Needed:

Procedure:

Requirements Met

5.3.1
5.3.2

Test Anomalies

Test Results:

Signature: ___________________________

Test Sheet FlyNet
