dtbinh/FlyNet/Technical/Testing/TargetTagIdentification.docx

Test Objective/Description: Target Tag Identification

Location:

Date:

Hardware Needed:

Procedure:

Requirements Met

8.2.1

Test Anomalies

Test Results:

Signature: ___________________________

Test Sheet FlyNet
