dtbinh/FlyNet/Technical/Testing/UniqueTargetTags.docx

Test Objective/Description: Unique Target Tags

Location:

Date:

Hardware Needed:

Procedure:

Requirements Met

8.4.1

Test Anomalies

Test Results:

Signature: ___________________________

Test Sheet FlyNet
