dtbinh/FlyNet/Presentations/CDR_Fall_2015/Individual_Slides/Matt/Testing.pptx

FlyNet: Test Plan

Testing

## Slide 2

FlyNet: Test Plan

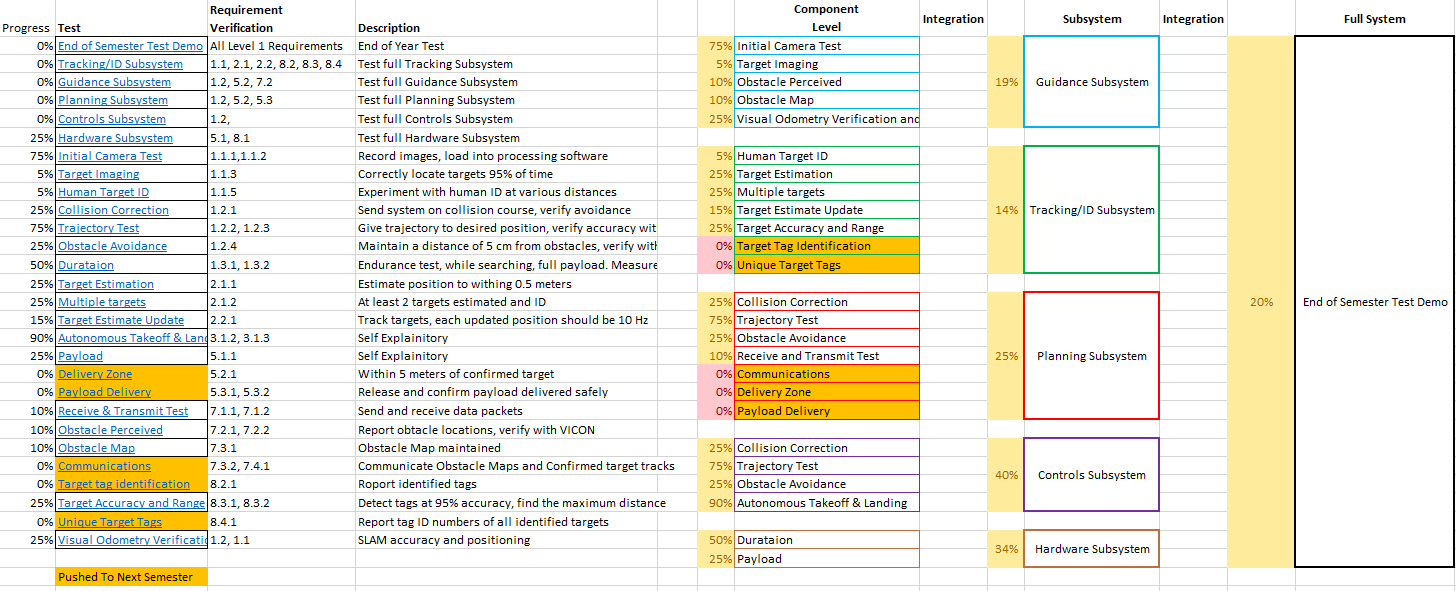
[picture p180: figure]

## Slide 3

FlyNet: Test Plan

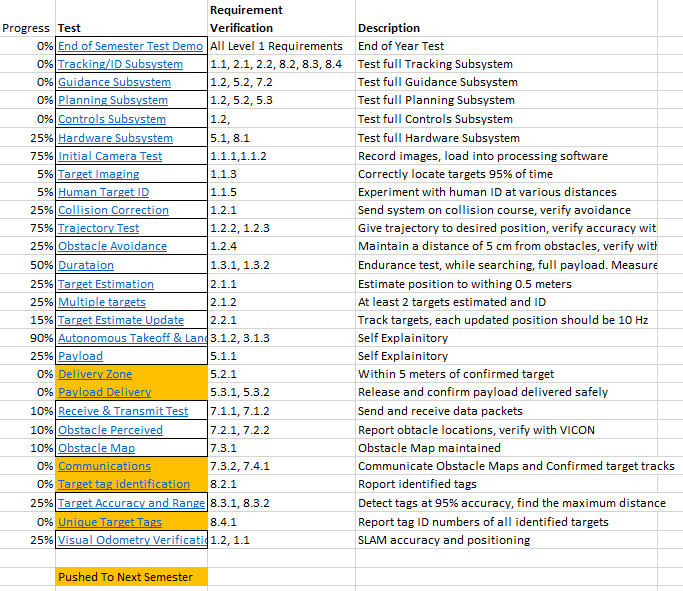
[picture p181: figure]

Notes: Fell behind schedule
Spent more time designing system then planned
Designs changed
Component issues

Talk about the most important test from this semester, and the two most important tests for next semester.

## Slide 4

FlyNet: Test Plan

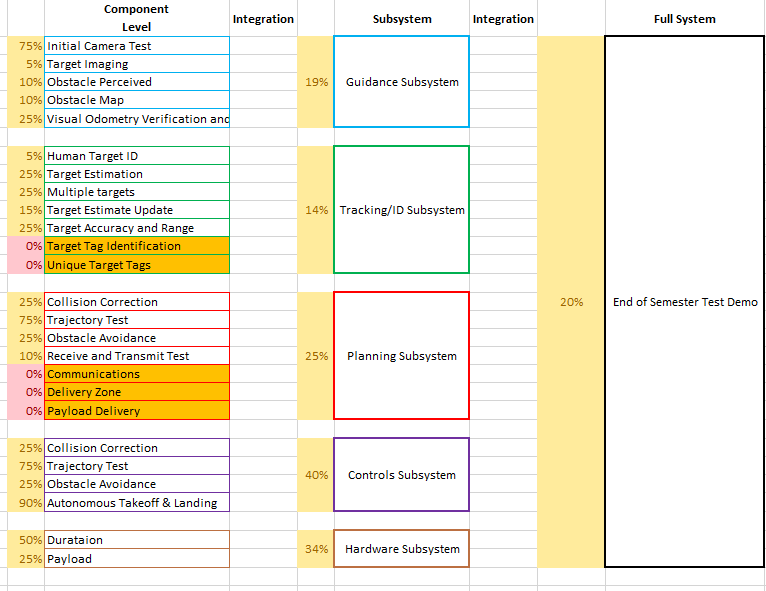
[picture p182: figure]

## Slide 5

FlyNet: Autonomous Quadcopter Search and Rescue

2 ft.

Hallway

2 ft.

- Start with a known floor plan

Notes: Designed for this semester
Pushed back to next semester
Showcase functionality of the system
Performed in Fleming lab

## Slide 6

FlyNet: Autonomous Quadcopter Search and Rescue

2 ft.

2 ft.

Hallway

Target

- Start with a known floor plan
- Target placed into area in unknown location

## Slide 7

FlyNet: Autonomous Quadcopter Search and Rescue

2 ft.

2 ft.

Hallway

“Roadblock”

Target

“Complete Block”

- Start with a known floor plan
- Target placed into area in unknown location
- “Roadblocks” and a “Complete Block” added to simulate debris or obstacles

## Slide 8

FlyNet: Autonomous Quadcopter Search and Rescue

2 ft.

2 ft.

Hallway

“Roadblock”

Target

“Complete Block”

Entry/Exit Point

- Start with a known floor plan
- Target placed into area in unknown location
- “Roadblocks” and a “Complete Block” added to simulate debris or obstacles
- Also have a known entry/exit point

## Slide 9

FlyNet: Autonomous Quadcopter Search and Rescue

2 ft.

2 ft.

Hallway

“Roadblock”

Target

“Complete Block”

Entry/Exit Point

- System will autonomously fly and map entire space

Guidance Sensor
SLAM Algorithm

## Slide 10

FlyNet: Autonomous Quadcopter Search and Rescue

2 ft.

2 ft.

Hallway

“Roadblock”

Target

“Complete Block”

Entry/Exit Point

- System will autonomously fly and map entire space
- Planning subsystem will help avoid obstacles and recalculate trajectory

Guidance Sensor
Obstacle Detection
Path Planning

!

## Slide 11

FlyNet: Autonomous Quadcopter Search and Rescue

2 ft.

2 ft.

Hallway

“Roadblock”

Target

“Complete Block”

Entry/Exit Point

- System will autonomously fly and map entire space
- Planning subsystem will help avoid obstacles and recalculate trajectory
- Target will be identified and located in the space

Guidance Sensor
FLIR Camera & Target ID

## Slide 12

FlyNet: Autonomous Quadcopter Search and Rescue

2 ft.

2 ft.

Hallway

“Roadblock”

Target

“Complete Block”

Entry/Exit Point

- System will autonomously fly and map entire space
- Planning subsystem will help avoid obstacles and recalculate trajectory
- Target will be identified and located in the space
- System will return to exit point to deliver map

## Slide 13

FlyNet: Autonomous Quadcopter Search and Rescue

- Building specs:
  - 4’ high walls made of 4’x8’ foam insulation paneling
  - Walls held upright with wooden frames
  - Doorframes will have extra reinforcements
  - Wall design has been tested and proves to be viable

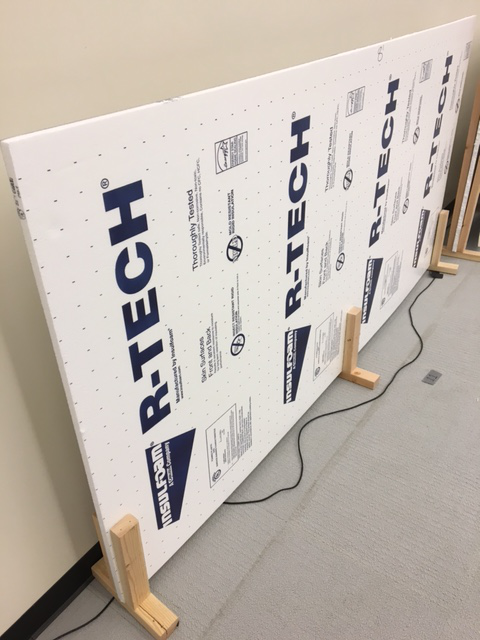
[picture p183: figure]
