dtbinh/FlyNet/Technical/Testing/Final Flight Demo.xlsx

Sheet: Layout
 | 24 Feet |  | 24 Feet
48 Feet |  | 24 Feet
 |  |  |  | Linear Feet | 116 | 29
 |  |  |  |  | 72
 |  |  |  |  | 44

Sheet: Wall Specs
 | 1 |  |  | 2 |  |  | 3 |  |  | 1 |  |  |  | 2 |  |  |  | 3
 |  |  |  |  |  |  |  |  |  |  |  |  |  |  |  |  |  |  |  |  |  |  |  | Full Layout
 |  |  |  |  |  |  |  |  |  |  |  |  | 29 |  |  |  |  |  |  |  |  |  |  |  | # Walls | Length | Total Length
 |  | 15 |  |  |  |  |  | 4 |  |  |  |  |  |  |  |  |  |  | 4 | Wall Seg. | # Needed | Total Length |  | Door Frames | 3 | 8 | 24
 |  |  | 16 |  |  | 17 | 18 |  |  | 28 |  |  | 30 |  |  |  |  |  |  | 4 | 6 | 24 |  | Small Walls | 12 | 6 | 72
 |  |  |  |  |  |  |  |  |  |  |  |  |  |  | 31 |  |  | 32 |  | 8 | 19 | 152 |  | Full Walls | 20 | 9 | 180
 |  |  |  |  |  |  |  |  |  | 27 |  |  |  |  |  |  |  |  |  | 6 | 1 | 6 |  | Total |  |  | 276
14 |  |  | 13 |  | 12 |  |  | 5 |  |  |  |  |  |  |  |  |  |  | 5 | 2 | 3 | 6 |  | #2x3 |  |  | 34.5
 |  |  |  |  |  |  |  |  |  |  |  | 26 |  | 25 |  |  |  |  |  | 3 | 3 | 9
 |  |  |  |  | 11 |  |  |  |  |  |  |  |  |  |  |  |  |  |  | Total | 32 | 197 | 0
 |  |  |  |  | 10 |  |  |  |  |  |  |  |  |  |  | 24
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
