dtbinh/FlyNet/Technical/controls/Architecture/controls_working.pdf

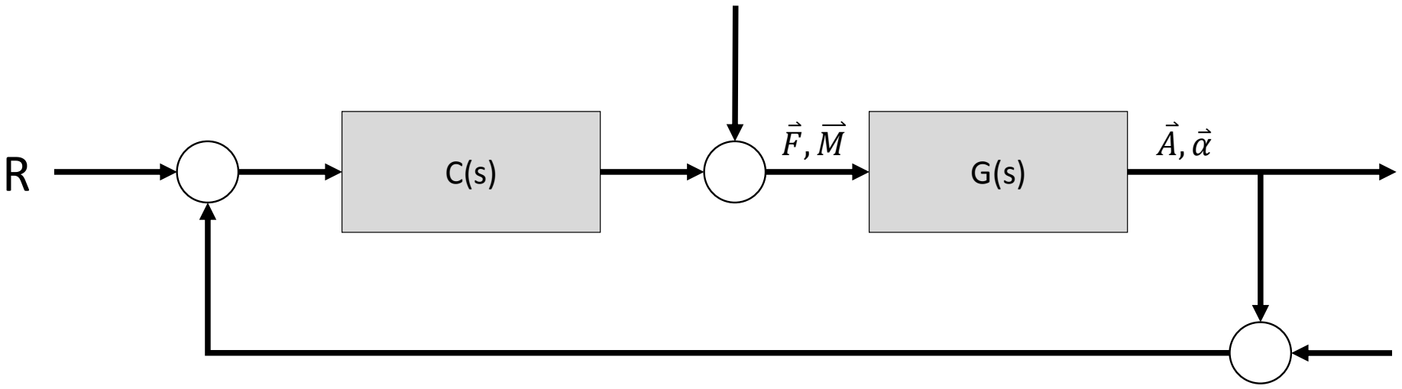
[picture p190: figure]

YV

W

=

x y z inertial

=

φ θ ψ

body

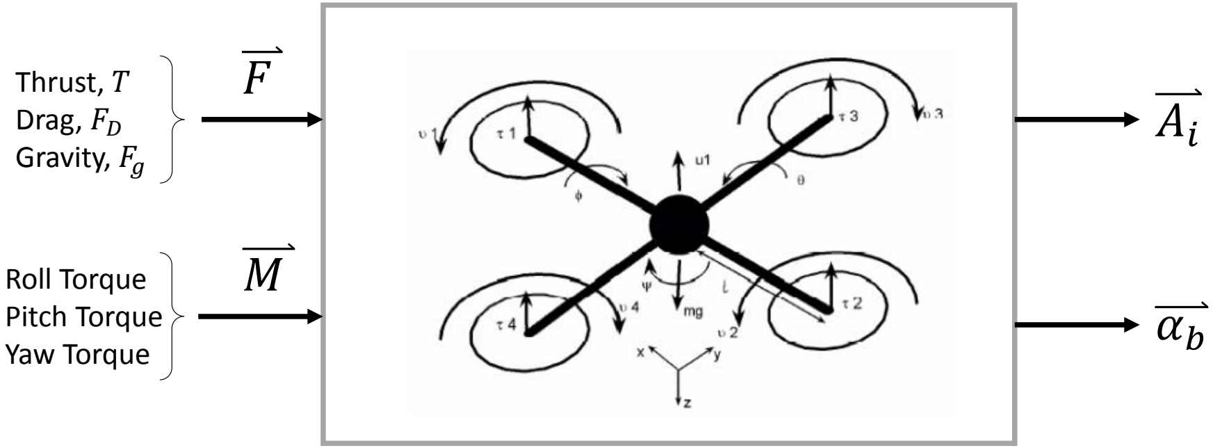
[picture p191: figure]
Thrust,; Drag,; FD Gravity,; Roll Torque Pitch Torque

# Yaw Torque T = Ti

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
Forces | Moments
Assuming body and
propeller gyroscopic
moments are small

C(s)

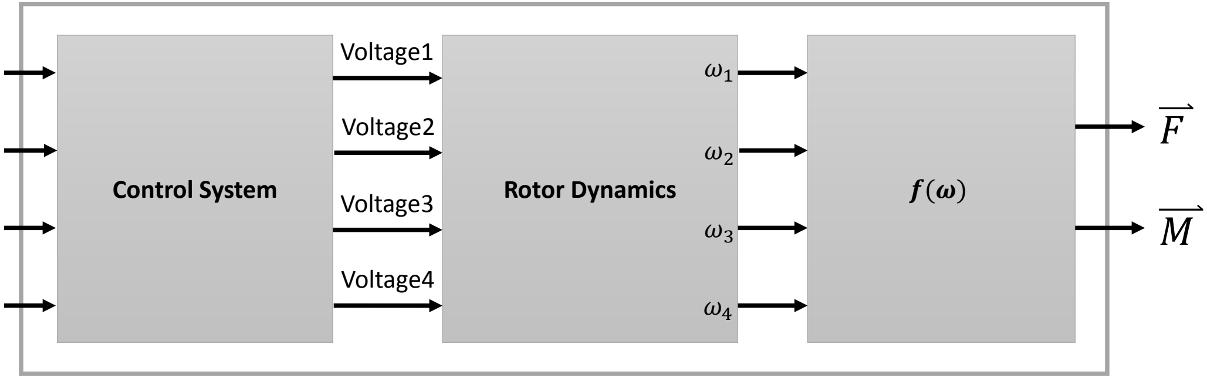
[picture p192: figure]
Control System; Rotor Dynamics; Voltage1; Voltage2; Voltage3; Voltage4

Roll ref

Pitch ref

Yaw ref

Throttle ref

Rotor
Dynamics

## Jmθ + bθ = kt

Ia

La

## dia dt + Raia = Va − keθ

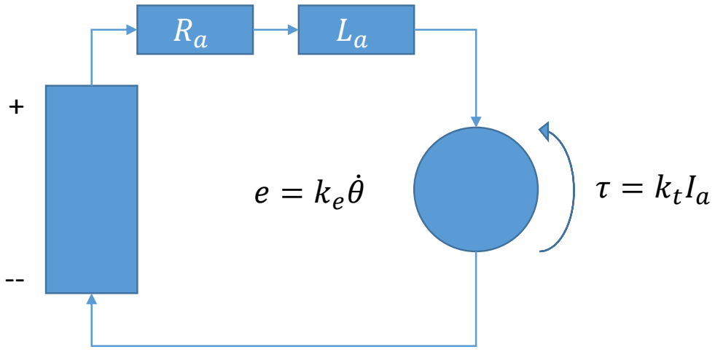
[picture p193: figure]
e = keθ

ℒ(s)

## Jm Θs

## 2 + b Θs = ktIa

## LaIas + RaIa = Va − keΘs

Θ
V

=

K
s(τs + 1)

Ω
V

=

K
τs + 1

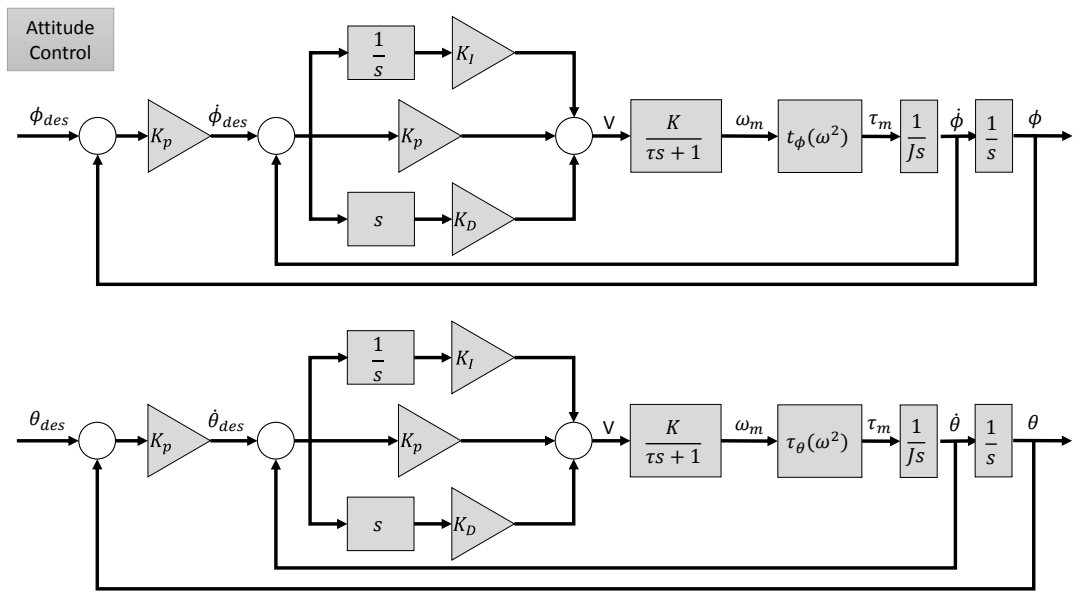
[picture p194: page 5]
Attitude Control; des; φdes; θ des; θdes

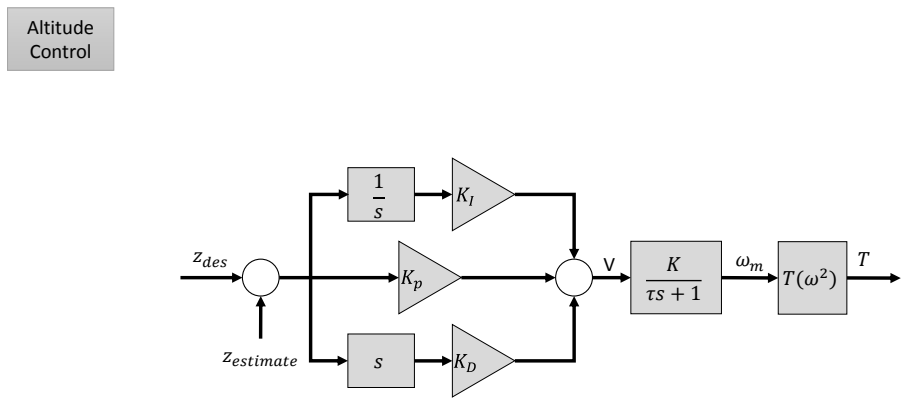
[picture p195: page 6]
Altitude Control; zdes; zestimate

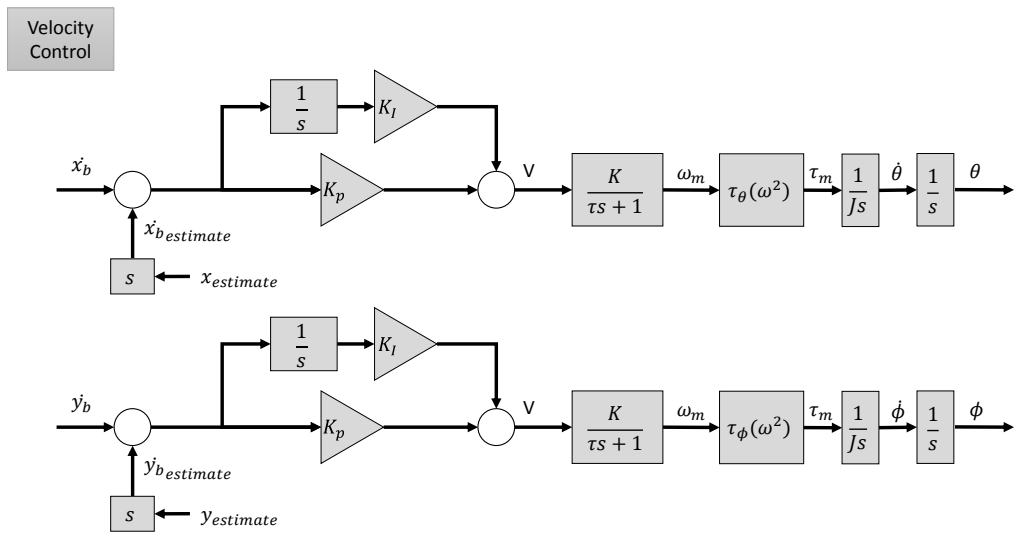
[picture p196: page 7]
Velocity Control; xestimate; estimate; yestimate

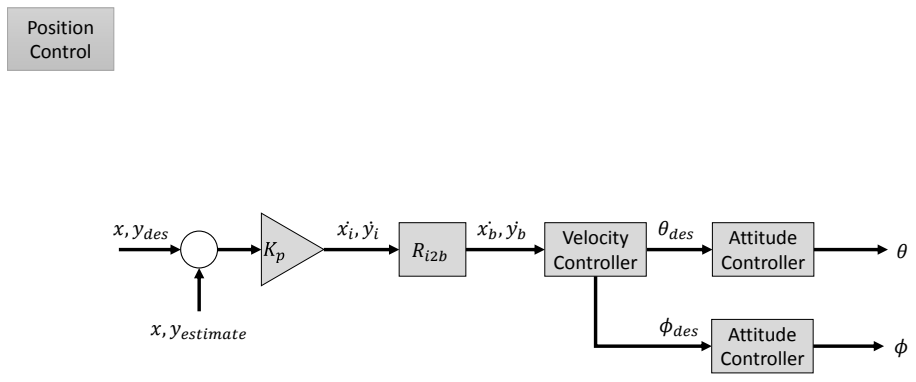
[picture p197: page 8]
Position Control; x, ydes; x, yestimate; Velocity Controller; Attitude Controller; φdes; θdes
