dtbinh/FlyNet/Presentations/Mid Semester Review/Individual_Slides/Steve/visodo_slides/figures/RTABMapBlock.pdf

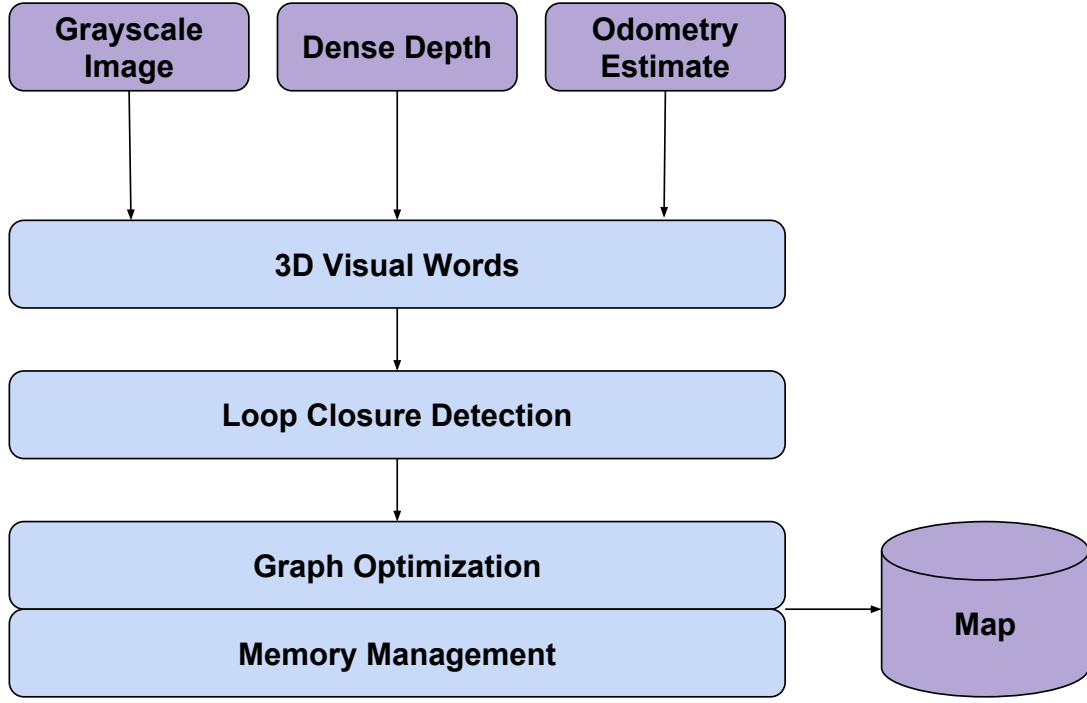
[picture p198: page 1]
Odometry; 3D Visual Words; Graph Optimization; Memory Management; Map

Estimate Dense Depth Grayscale
Image

Loop Closure Detection
