dtbinh/FlyNet/Presentations/Mid Semester Review/Individual_Slides/Steve/visodo_slides/figures/PoseGraph.pdf

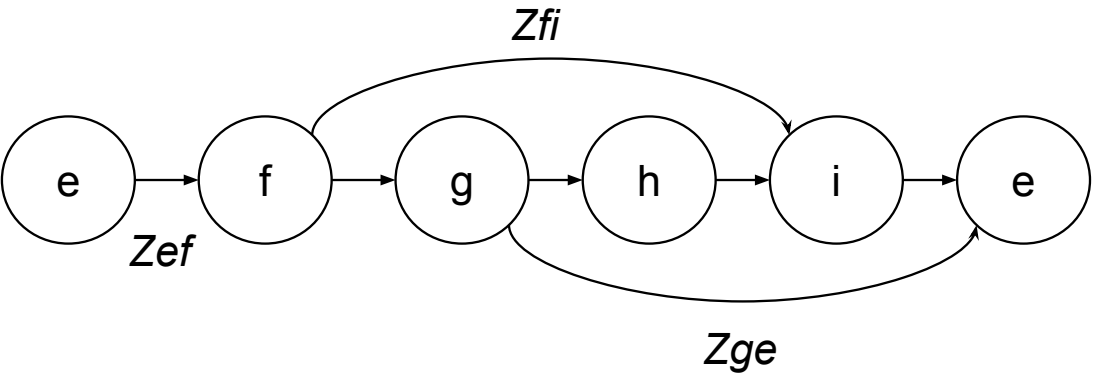
[picture p199: page 1]
Zef; Zfi; Zge
