dtbinh/FlyNet/(commit log)

2015-09-02 Added project charter template and time sheet template
    [Contact Info.xlsx, IndTimeSheet_TEMPLATE.xlsx]
2015-09-02 Added open action items and manager time sheet template
    [FlyNet_Timesheet_date-TEMPLATE.xlsx, open_action_items.xlsx]
2015-09-02 Added requirements spreadsheet
    [flynet_requirements.xlsx]
2015-09-02 Added meeting action items
    [open_action_items.xlsx]
2015-09-04 Updated requirements and action items
    [flynet_requirements.xlsx, open_action_items.xlsx]
2015-09-04 Added timecard
    [Ellison_Drew_9_4_15.xlsx]
2015-09-04 Add of timesheet
    [McGuire-31Aug.xlsx]
2015-09-04 Contact Info
    [Contact Info.xlsx]
2015-09-04 Added Timesheet
    [Clayton_Tyler_9_4_15.xlsx]
2015-09-04 Adding timecard
    [Dean_Taylor_09_04_15.xlsx]
2015-09-04 Added contact info
    [Contact Info.xlsx]
2015-09-05 Adding timesheet
    09_04_2015
    [Meletyan_Ed_09_04_2015.xlsx]
2015-09-05 Adding contact info
    [Contact Info.xlsx]
2015-09-05 Time Sheet
    [Contact Info.xlsx, Prashant_Ganesh_9_4_15.xlsx]
2015-09-05 Added austin timesheet
    [Anderson_Austin_9_4_15.xlsx]
2015-09-05 Busby Time Card
    [Busby_TimeSheet_Sep_4.xlsx]
2015-09-06 Added total timesheet week 1
    [FlyNet_Timesheet_9_4_15.xlsx]
2015-09-09 Added quadrotor ukf model skeleton and updated open action items
    [Schedule.xlsx, open_action_items.xlsx]
2015-09-10 Updated action items, requirements list is in progress, minutes and hardware purchase list added
    [closed_action_items.xlsx, flynet_requirements.xlsx, open_action_items.xlsx, purchase_list.xlsx]
2015-09-11 Added timecards and updated contact
    [Anderson_Austin_9_11_15.xlsx, Contact Info.xlsx]
2015-09-11 Add of McGuire timesheet
    [McGuire-11Sept.xlsx]
2015-09-11 Bryce's Timesheet
    9/11/15
    [Hill_Bryce_9_11_15.xlsx, IndTimeSheet_TEMPLATE.xlsx]
2015-09-11 Revert "Bryce's Timesheet"
    This reverts commit b7c589928abae3daf9dd052734ad59fde1026bfa.
    [Hill_Bryce_9_11_15.xlsx, IndTimeSheet_TEMPLATE.xlsx]
2015-09-11 Revert "Revert "Bryce's Timesheet""
    This reverts commit 2f77c0e54799006fc942aa2b7c43ff9394678a77.
    [Hill_Bryce_9_11_15.xlsx, IndTimeSheet_TEMPLATE.xlsx]
2015-09-11 Bryce's Timecard
    [Hill_Bryce_9_11_15.xlsx]
2015-09-11 Busby Timecard
    [Busby_TimeSheet_Sep_11.xlsx]
2015-09-11 Tylers Timecard 9/11/15
    [Clayton_Tyler_9_11_15.xlsx]
2015-09-11 Added Tylers contact info
    [Contact Info.xlsx]
2015-09-11 Meletyan Timecard 9_11_15
    [Meletyan_Ed_9_11_15.xlsx]
2015-09-12 Updated requirements chart
    [flynet_requirements_chart.xlsx]
2015-09-12 Added time card
    [Ellison_Drew_9_11_15.xlsx]
2015-09-12 Time Card
    [Prashant_Ganesh_9_11_15.xlsx]
2015-09-14 Updated purchase list
    [flynet_requirements_chart.xlsx, purchase_list.xlsx]
2015-09-14 Added week total timesheet for week ending on 9/11
    [FlyNet_Timesheet_9_11_15.xlsx, Schedule.xlsx]
2015-09-15 Updated action items
    [open_action_items.xlsx, purchase_list.xlsx]
2015-09-16 Updated action items and charter
    [closed_action_items.xlsx, open_action_items.xlsx]
2015-09-18 Matt Contact
    [Contact Info.xlsx]
2015-09-18 Add of McGuire
    [McGuire-18Sept.xlsx]
2015-09-18 Tylers Timecard 9/18
    [Clayton_Tyler_9_18_15.xlsx]
2015-09-18 Added my timecard
    [Anderson_TimeSheet_9_18.xlsx]
2015-09-18 Updated purchase list, added Ellison time card
    [Ellison_Drew_9_18_15.xlsx, flynet_requirements_chart.xlsx, purchase_list.xlsx]
2015-09-20 Added old DVZ Resources
    [AMCL parameters - Copy.xlsx, AMCL parameters.xlsx, AMCL_parameter_test.xlsx, Blade_Guard.SLDDRW, Blade_Guard_Plate.SLDPRT, Blade_Guard_Plate.STEP, Blade_Guard_Plate1_noHoles.SLDPRT, Blade_Guard_Plate2.SLDPRT]
2015-09-22 Modified requirements
    [FlyNet_Timesheet_9_18_15.xlsx, flynet_requirements_chart.xlsx]
2015-09-22 Added controls team action items
    [open_action_items.xlsx]
2015-09-22 Added to open action items
    [AMCL parameters - Copy.xlsx, AMCL parameters.xlsx, Blade_Guard.SLDDRW, Blade_Guard_Plate.SLDPRT, Blade_Guard_Plate.STEP, Blade_Guard_Plate1_noHoles.SLDPRT, Blade_Guard_Plate2.SLDPRT, Blade_Guard_Plate2.STEP]
2015-09-23 controls architecture v1
    [Anderson_TimeSheet_9_18.xlsx, Blade_Guard.SLDDRW, Blade_Guard_Plate.SLDPRT, Blade_Guard_Plate.STEP, Blade_Guard_Plate1_noHoles.SLDPRT, Blade_Guard_Plate2.SLDPRT, Blade_Guard_Plate2.STEP, Busby_TimeSheet_Sep_18.xlsx]
2015-09-25 Time CARDS!
    [Anderson-25Sept.xlsx]
2015-09-25 Added time card and minutes
    [Busby_TimeSheet_Sep_25.xlsx, Clayton_Tyler_9_25_15.xlsx, Ellison_Drew_9_25_15.xlsx]
2015-09-26 Updated requirements
    [flynet_requirements.xlsx, flynet_requirements_chart.xlsx]
2015-09-26 Uploaded Bryce's timesheet
    [Hill_Bryce_9_25_15.xlsx]
2015-10-02 Repo Management, action item updates
    [AMCL parameters - Copy.xlsx, AMCL parameters.xlsx, Anderson-25Sept.xlsx, Anderson_Austin_9_11_15.xlsx, Anderson_Austin_9_4_15.xlsx, Anderson_TimeSheet_9_18.xlsx, Blade_Guard.SLDDRW, Blade_Guard_Plate.SLDPRT]
2015-10-02 Add of McGuire 2 Oct
    [McGuire-2Oct.xlsx]
2015-10-02 Timecard 10/02/2015
    [Meletyan_10_02_2015.xlsx]
2015-10-02 added timecard for 10/2
    [Clayton_Tyler_10_2_15.xlsx]
2015-10-08 Updated some action items
    [closed_action_items.xlsx, open_action_items.xlsx]
2015-10-10 Updated time cards
    [Anderson_Austin_10092015.xlsx, Anderson_Austin_10_02_2015.xlsx, Busby_Oct_9.xlsx, Clayton_Tyler_10_2_15.xlsx, Dean_Taylor_10_02_2015.xlsx, FlyNet_Timesheet_10_2_15.xlsx, Hill_Bryce_9_25_15.xlsx, IndTimeSheet_TEMPLATE.xlsx]
2015-10-13 AlienBee Endurance Graph
    [PowerMassBOM3.xlsx]
2015-10-14 Add of initial visual odometry slides
2015-10-15 emulation of powerpoint format
2015-10-15 Additions to the code and power budgets for MSR
    [PowerMassBOM3_ABee.xlsx, PowerMassBOM3_M100.xlsx]
2015-10-16 Time Card for the week
    [Clayton_Tyler_10_16_15.xlsx]
2015-10-16 Added AA timecard
    [Anderson_Austin_10_16_15.xlsx]
2015-10-18 Added weekly status presenters
    [weekly_status_presentations.xlsx]
2015-10-19 Updates to Slides and calculations
    [PowerMassBOM3_ABee.xlsx]
2015-10-20 Updated Review Slides
    [Prashant_Ganesh_10_2_15.xlsx, budget.xlsx, flynet_requirements_chart.xlsx]
2015-10-20 Review updates
    [flynet_requirements_chart.xlsx, flynet_requirements_chart_10_19_15.xlsx, flynet_requirements_chart_9_1_15.xlsx]
2015-10-23 timecard 10/23
    [Clayton_Tyler_10_23_15.xlsx]
2015-10-23 Puttin the team on my back
    [Anderson_23_Oct.xlsx]
2015-10-30 Added a Quad-rotor Simulink Model
2015-10-30 weekly time card
    [Clayton_Tyler_10_30_15.xlsx]
2015-10-30 AA Time Cards
    [Anderson_Austin_10_30_15.xlsx]
2015-11-06 Time Care
    [Busby_Nov_6.xlsx]
2015-11-06 Time card!!! at least i CARE to check my spelling
    [Clayton_Tyler_11_6_15.xlsx]
2015-11-07 Time Card AA
    [Anderson_Nov_6.xlsx]
2015-11-08 Updated budget, receipts and Frew approved block diagrams
    [budget.xlsx]
2015-11-09 Uploading time card
    [Hill_Bryce_11_6_15.xlsx]
2015-11-10 Flight Demo
    [Final Flight Demo.xlsx]
2015-11-10 adding to tracking analysis
    [SimulationSummary.xlsx]
2015-11-11 Update Testing
    [TestPlan.xlsx]
2015-11-12 added flight test and param tuning files
    [param_set.txt]
2015-11-12 Test Update
    [TestPlan.xlsx]
2015-11-14 Add mcguire
    [McGuire-13Nov.xlsx]
2015-11-15 Quad Gains
    [Quad Gains.xlsx]
2015-11-16 Finally getting this up (I already got it to Drew)
    [Hill_Bryce_11_13_15.xlsx]
2015-11-17 Test Plan Progress
    [TestPlan.xlsx]
2015-11-20 Timecard 1st one
    [Hill_Bryce_11_20_15.xlsx]
2015-11-20 Time Card?
    [Busby_Nov_20.xlsx, Final Flight Demo.xlsx]
2015-11-20 new motor stuffs
    [PowerMassBOM_ABee_NEW.xlsx]
2015-11-20 quad stuffs
    [Quad Gains.xlsx]
2015-11-24 Mcguire add
    [McGuire-20Nov.xlsx]
2015-11-24 My Bad
    [Anderson_11_20_15.xlsx]
2015-11-25 Lots of updated shiiiiiiit
    [budget.xlsx]
2015-11-25 Updated organization
    [budget.xlsx]
2015-11-29 Updates test plans/results
    [TestPlan.xlsx]
2015-11-29 Continuity Doc
    [Final Flight Demo.xlsx]
2015-11-30 Small Updates
    [Final Flight Demo.xlsx, TestPlan.xlsx]
2015-12-01 Test Plan Update
    [Final Flight Demo.xlsx, TestPlan.xlsx]
2015-12-02 BOMB updates
    [PowerMassBOM_ABee_NEW.xlsx]
2015-12-02 mass & moments of inertia
    [PowerMassBOM_ABee_NEW.xlsx]
2015-12-03 a whole bunch of good stuffz
    [PowerMassBOM_ABee_NEW.xlsx]
2015-12-03 Added SolidWorks Stuff
    [2x3.SLDPRT, 4x1.5Foam.SLDPRT, 4x2Foam.SLDPRT, 4x4Foam.SLDPRT, 4x6Foam.SLDPRT, 4x8Foam.SLDPRT, Demo.SLDASM, DoorFrame.SLDPRT]
2015-12-04 Testing Update
    [TestPlan.xlsx]
2015-12-04 AdUrSeTwIN fail....
    [PowerMassBOM_ABee_NEW.xlsx]
2015-12-05 Steve add
    [McGuire-4Dec.xlsx]
2015-12-06 Updated documentation
    [Quad Gains.xlsx]
2015-12-07 Updates to data analysis and flight control technical document
    [mavros-local_position-local.csv, mavros-setpoint_position-local.csv, mavros-vision_pose-pose.csv]
2015-12-07 Jackie Robinson # of hours
    [Clayton_Tyler_12_4_15.xlsx]
2015-12-07 Late Time Card Sorry
    [Anderson_Austin_12_4_15.xlsx]
2015-12-07 Slides and other updates
    [Hill_Bryce_12_4_15.xlsx]
2015-12-08 Testing Slides
    [TestPlan.xlsx]
2015-12-08 Fixing mislabeled requirement
    [flynet_requirements_chart_10_19_15.xlsx]
2015-12-11 Last Time Card of 2015
    [Busby_Dec_11.xlsx]
2016-01-14 2016 Test Plan
    [TestPlan.xlsx]
2016-01-19 Test Plan
    [TestPlan.xlsx]
2016-01-20 Planning Test Plan Updates
    [TestPlan.xlsx]
2016-01-22 Test Plan Schedule
    [TestPlan.xlsx]
2016-01-26 Added SITL howto
    [mavros-local_position-local.csv, mavros-setpoint_position-local.csv, mavros-vision_pose-pose.csv, test.csv]
2016-01-27 Updating Testing with Target ID
    [TestPlan.xlsx]
2016-01-28 Mechanical Tests
    [TestPlan.xlsx]
2016-01-29 More Test Updates
    [TestPlan.xlsx]
2016-02-05 Updating target tracking test progress
    [TestPlan.xlsx]
2016-02-18 Updates from meeting
    [TestPlan.xlsx]
2016-02-22 Some Integration Updates
    [TestPlan.xlsx]
2016-02-29 Testing Updates
    [TestPlan.xlsx]
2016-03-01 Updated controls progress
    [TestPlan.xlsx]
2016-05-02 Final Test Plan Update
    [TestPlan.xlsx]
